liarokapisv/RobotHands/CADRoboticNewVersion/Interfaces/README.md

# Robot Hands Interfaces
In order to control robot hands the user can use the proposed interfaces.
#####Robot Hand Extension: 
This interface had two buttons, one for closing and one for opening the robot hand. 
To make this, you should print with 3d printer two parts, RobotHandExtension.STL and dovetail_male_RobotHandExtension.STL.
For connecting the two parts you must use a M5 nut and screw which you can find at common parts folder.
######Build of Materials
    1x M5 Nut
    1x M5 L22
    ABS Filament

#####SliderBox:
This interface had two linear potentiometers. Until now the one of these are active.
Also, SliderBox could be use for robot hands which had two servo motors like
[Model T42  of Yale OpenHand Project](http://www.eng.yale.edu/grablab/openhand/model_t42.html#performance).
To make this, you should cut the parts, which are in /dxf folder, in acrylic sheet with laser cutter. For connecting the parts you must use 
glue for acrylic, M3 nuts and screws. For connecting the potentiometers in the
SliderBox you must use M3 nuts, screws and spacers which are in common parts folder. 
######Build of Materials
    14x M3 Nut
    6x M3 L8
    8x M3 L20
    8x plastic spacers L15 for M3 screw
    Glue for Acrylic
    Acrylic sheet 2mm
    
For both interfaces you can find the software, firmware and electronics in respective folders of Robot-Hands repo.
