liarokapisv/RobotHands/CADRoboticNewVersion/RobotHand/README.md

# Physical Characteristics of Robot Finger and Hand
###Robot Finger:


    DOF's: 2
	Width(mm): 20
	Lenght(mm): 95
	Weigth(g): 20 
	Force in fingertip (N): 8
	
###Robot Hand:


	Actuators: 1
	Base Height(mm): 100-110
	Base Width(mm): 77
	Weight(g): 280
	Number of Fingers: 2-4

To change the design or fabrication parameters you must change the dimensions of the RobotHandParameters.SLDPRT sketch.

A complete tutorial for the replication of this robot hand can be found
[here.](http://www.openbionics.org/TR2015_OpenBionics_RobotHandsGuide.pdf)
