liarokapisv/RobotHands/CAD/Robot Finger/src/FingersTopPlate.SLDASM

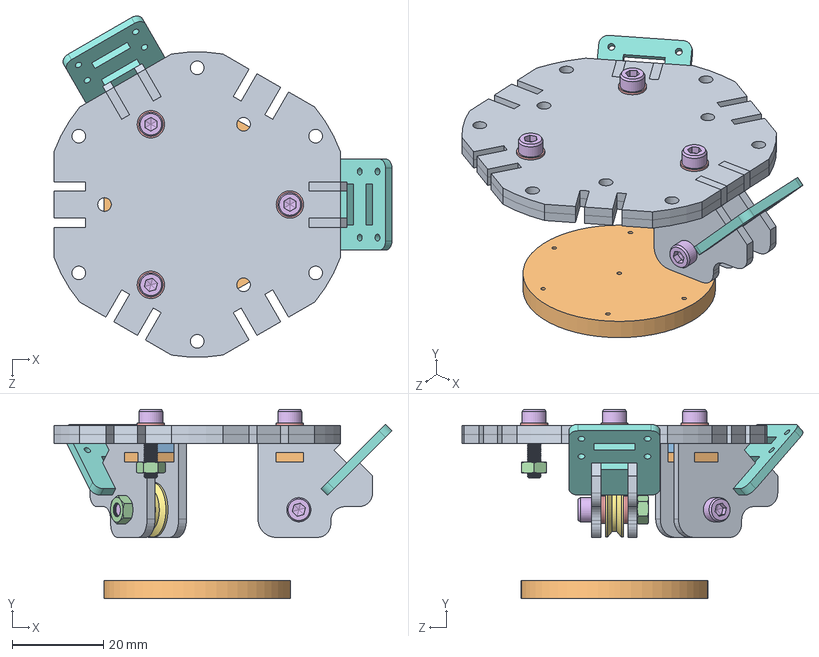
[picture p1: CAD file, 2017-01-19]
CAD/Robot Finger/src/FingersTopPlate.SLDASM
74.2 x 41.5 x 74.8 mm
FingerBase1 x 4
FingerBase2 x 2
FingerBase3 x 2
M3Nut x 5
M3Washer x 11
M3x12 x 5
pulley x 2
FingerMCP x 2
TopPlate x 2
DifferentialDisk
