liarokapisv/RobotHands/CADProsthetic/HandParameterized/Button/src/Button.SLDASM

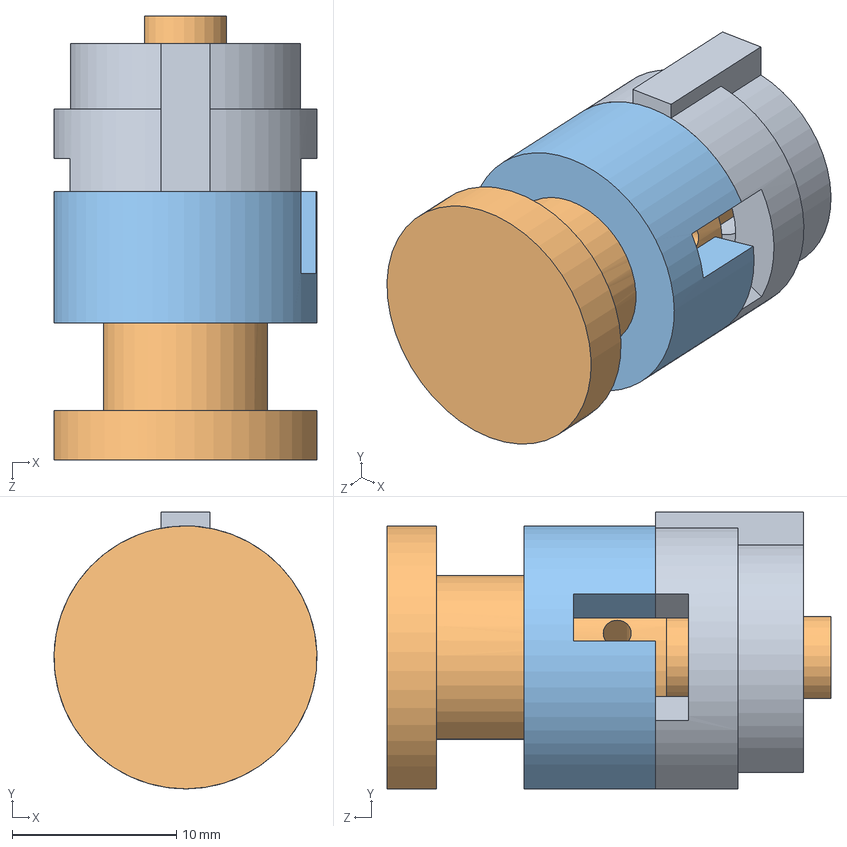
[picture p2: CAD file, 2017-01-14]
CADProsthetic/HandParameterized/Button/src/Button.SLDASM
16.0 x 16.8 x 27.0 mm
buttonBase
buttonAxle
buttonFrame
