liarokapisv/RobotHands/CADProsthetic/HandParameterized/Whipheel_tree/mainBar.STL

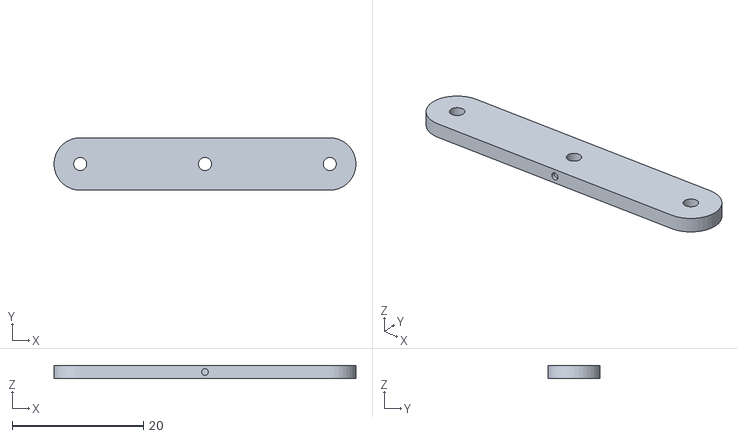
[picture p3: CAD file, 2017-01-14]
CADProsthetic/HandParameterized/Whipheel_tree/mainBar.STL
46.1 x 8.00 x 2.00
