liarokapisv/RobotHands/CADRoboticNewVersion/RobotHand/3d Printed/Robot Base/stdServoBase.SLDASM

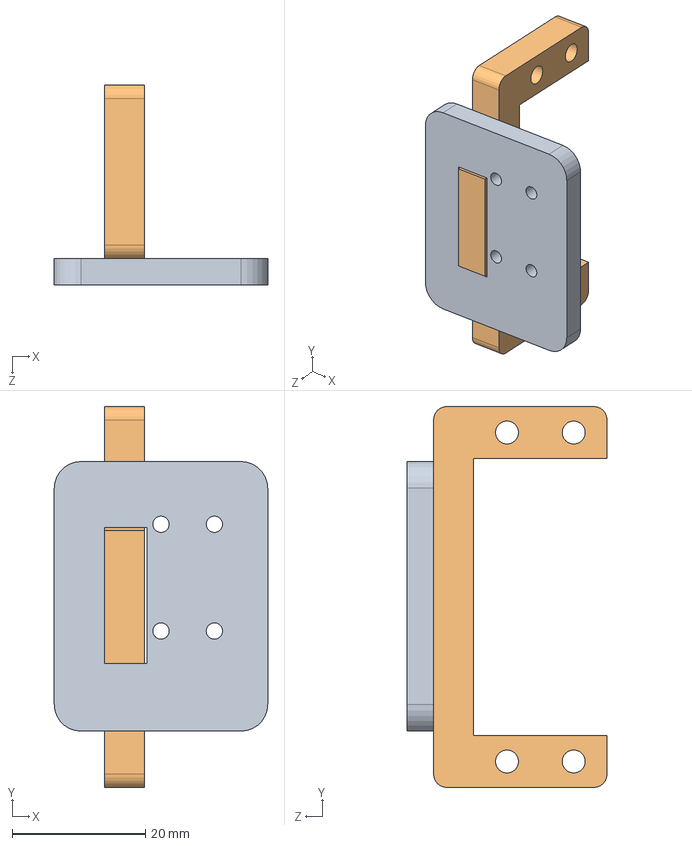
[picture p4: CAD file, 2017-01-14]
CADRoboticNewVersion/RobotHand/3d Printed/Robot Base/stdServoBase.SLDASM
32.0 x 57.1 x 30.0 mm
stdServoBase1
stdServoBase2
