liarokapisv/RobotHands/CADRoboticNewVersion/RobotHand/3d Printed/RobotHand.SLDASM

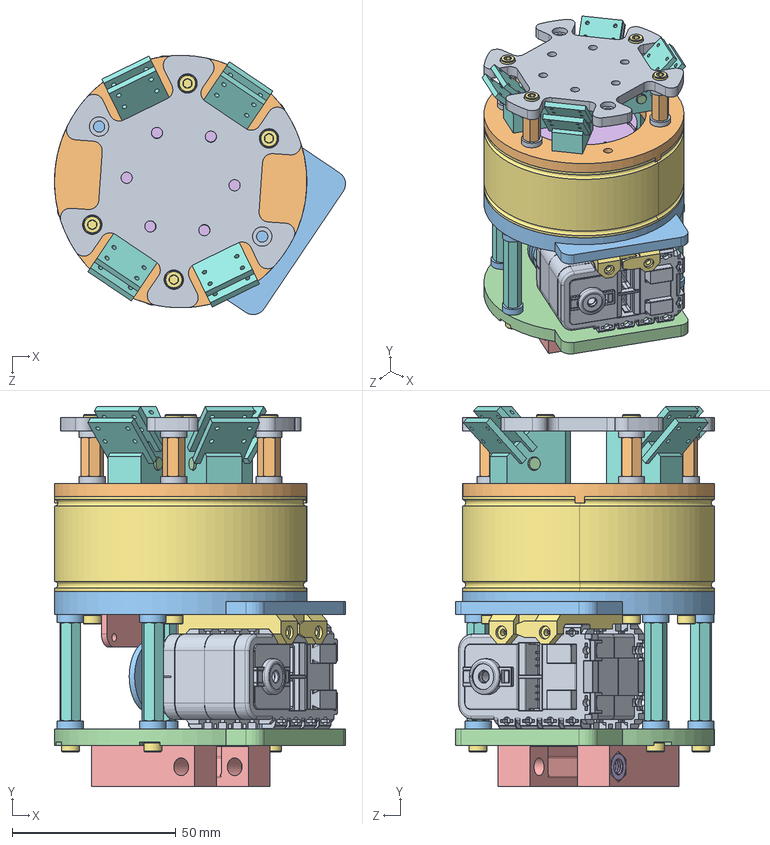
[picture p5: CAD file, 2017-01-14]
CADRoboticNewVersion/RobotHand/3d Printed/RobotHand.SLDASM
88.8 x 115.9 x 79.1 mm
TopPlate
MiddlePlate
BottomPlate
93600A129 - DowelPinM4L12 x 5
PCBMount
DifferentialDisk
AX12Base
ax12_wheel
ax12_box
ax12_cog
servoPulleyAX12
94150A305 - NutM2 x 4
91292A832 - ScrewM2L8 x 4
92290A745 - ScrewM2L4 x 2
94868A181 - HexStandoffM3L30 x 8
Spacer - 2mm x 8
94868A007 - HexStandoffM3L12 x 4
Spacer - 2_5mm x 8
FlangePlate
dovetail_female
91828A241 - NutM5
92290A115 - ScrewM3L10 x 16
FingerBase21 x 4
