liarokapisv/RobotHands/CADRoboticNewVersion/RobotHand/Laser Cutted/RobotHand.SLDASM

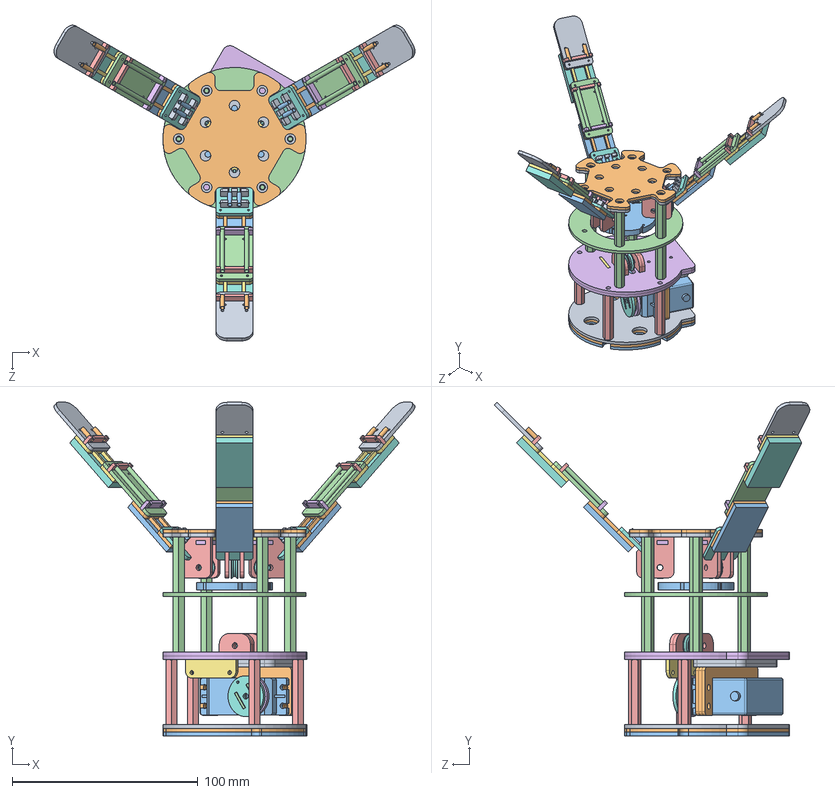
[picture p6: CAD file, 2017-01-14]
CADRoboticNewVersion/RobotHand/Laser Cutted/RobotHand.SLDASM
194.3 x 179.5 x 169.9 mm
TopPlate1
TopPlate2
DifferentialDisk
MiddlePlate
BearingBase x 4
BottomPlate x 2
PCBMount
pulley x 4
MountPA10_1
MountPA10_2
MountPA10_3
94868A181 - HexStandoffM3L30 x 8
94868A184 - HexStandoffM3L35 x 4
servoPulleyStd1
servoPulleyStd2
servoPulleyStd3
stdServoBase1 x 2
stdServoBase2 x 3
HS-422
ServoHorn
FingerBase1 x 6
FingerBase2 x 3
FingerBase3 x 3
FingerMCP x 3
TubePlateMCP x 6
JointBase1 x 3
Joint1 x 3
FingerPIP x 3
TubePlateDIP x 6
TubePlatePIP x 3
JointBase2 x 3
Joint2 x 3
FingerDIP x 3
tubeDIP x 6
tubeMCP x 6
tubePIP x 6
