liarokapisv/RobotHands/CAD/Robot Base AX12/src/servoPulley.SLDASM

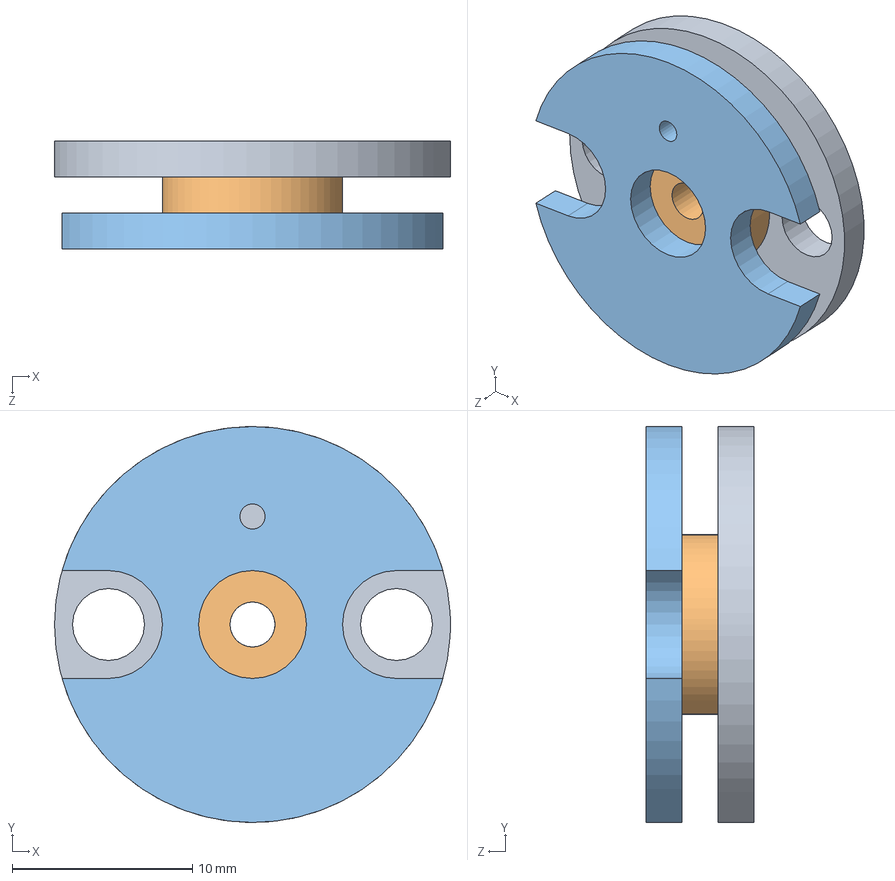
[picture p7: CAD file, 2017-01-14]
CAD/Robot Base AX12/src/servoPulley.SLDASM
22.0 x 22.0 x 6.00 mm
servoPulleyAX12_1
servoPulleyAX12_2
servoPulleyAX12_3
