liarokapisv/RobotHands/CAD/Robot Finger/src/Finger_2ph.SLDASM

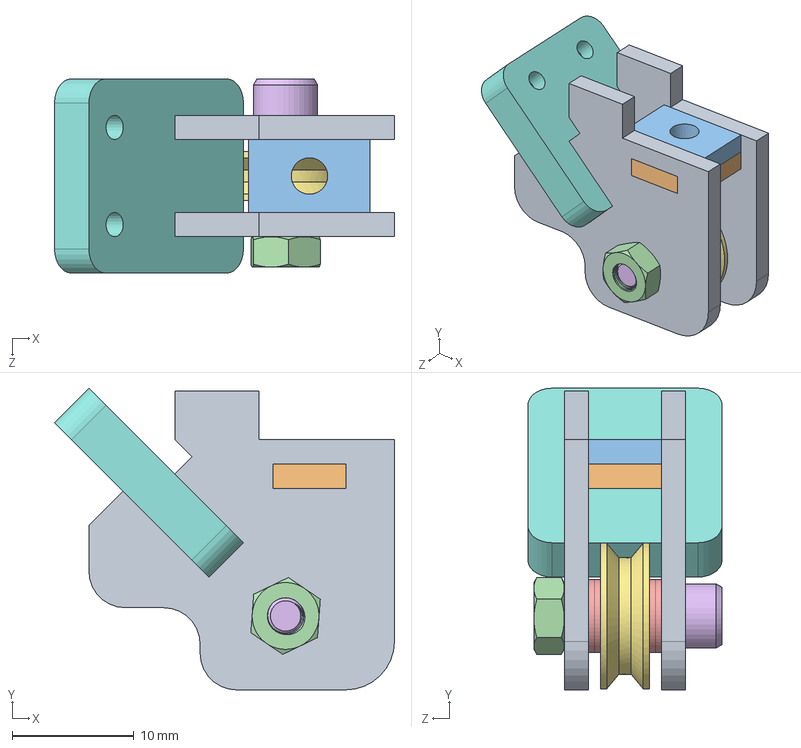
[picture p8: CAD file, 2017-01-19]
CAD/Robot Finger/src/Finger_2ph.SLDASM
28.0 x 24.8 x 16.0 mm
FingerBase1 x 2
FingerBase2
FingerBase3
M3Nut
M3Washer x 4
M3x12
pulley
FingerMCP
