liarokapisv/RobotHands/CADProsthetic/HandParameterized/Thumb_mechanism/thumbMechanismAssembly.STL

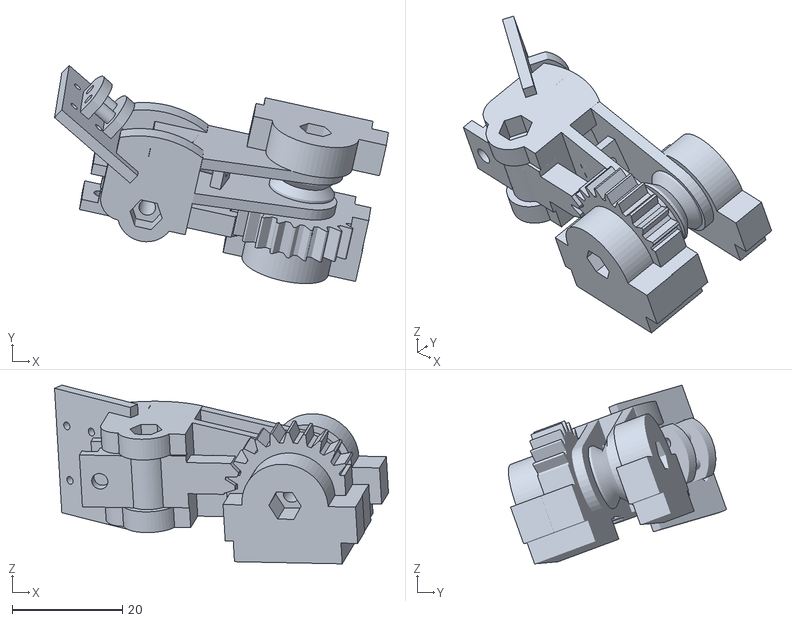
[picture p9: CAD file, 2017-01-14]
CADProsthetic/HandParameterized/Thumb_mechanism/thumbMechanismAssembly.STL
60.6 x 39.6 x 32.4
