liarokapisv/RobotHands/CADRoboticNewVersion/Interfaces/Extension/RobotHandExtensionAssembly.SLDASM

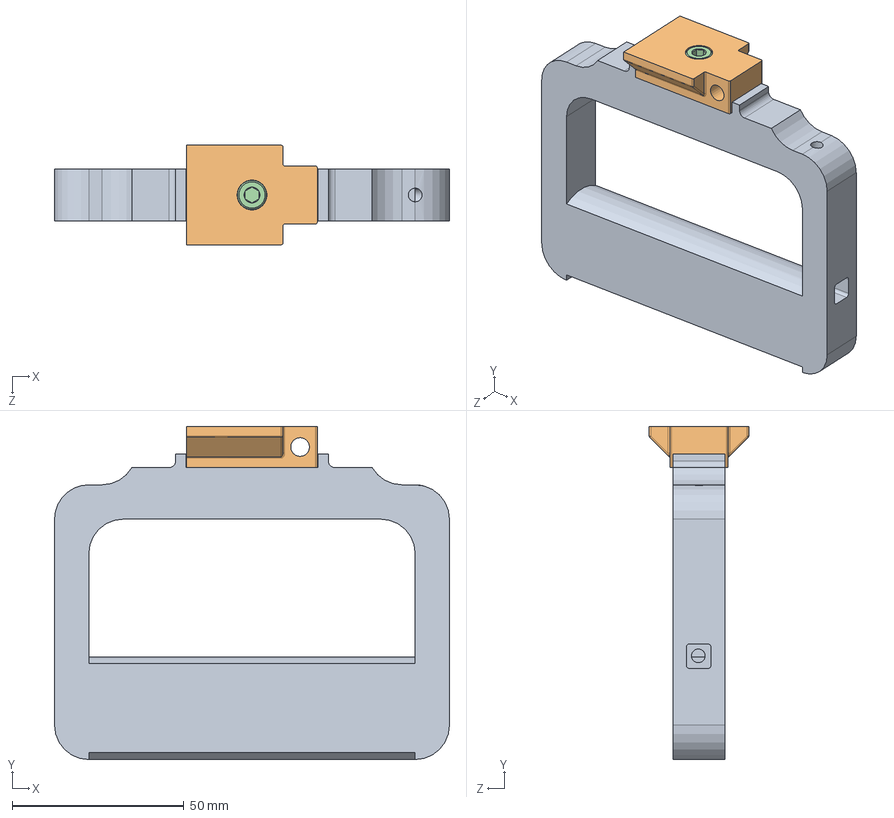
[picture p10: CAD file, 2017-01-14]
CADRoboticNewVersion/Interfaces/Extension/RobotHandExtensionAssembly.SLDASM
115.0 x 97.0 x 29.0 mm
RobotHandExtension
dovetail_male_RobotHandExtension
91828A241 - NutM5
92290A782 - ScrewM5L22
