liarokapisv/RobotHands/CADRoboticNewVersion/Interfaces/SliderBox/SliderBox.SLDASM

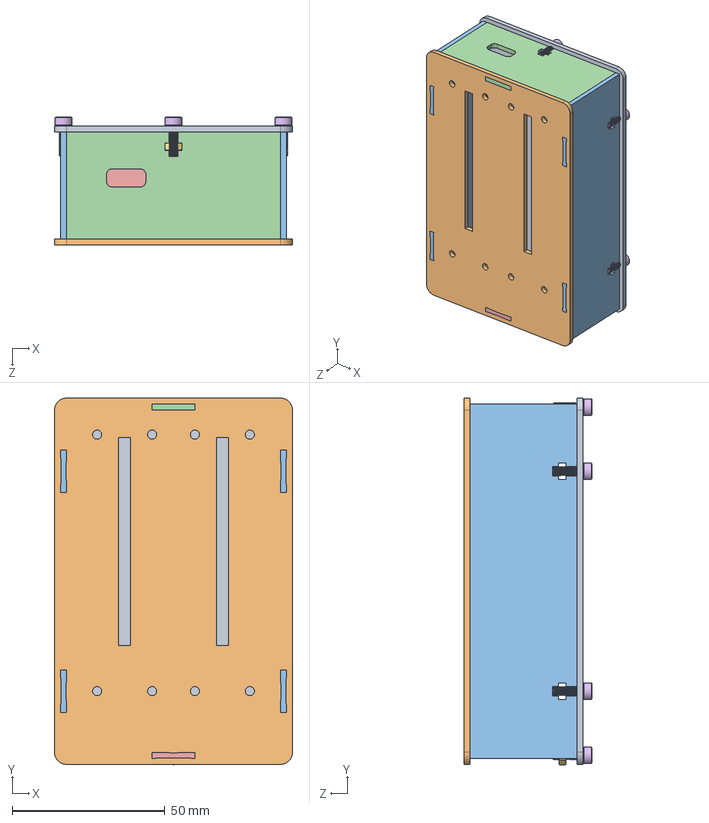
[picture p11: CAD file, 2017-01-14]
CADRoboticNewVersion/Interfaces/SliderBox/SliderBox.SLDASM
78.0 x 120.2 x 42.0 mm
SliderBottom
SliderTop
SlideSide x 2
SlideSideUp
SlideSideDown
92290A115 - ScrewM3L10 x 6
94150A325 - NutM3
