liarokapisv/RobotHands/CAD/Robot Flange/src/FlangeStdServo.SLDASM

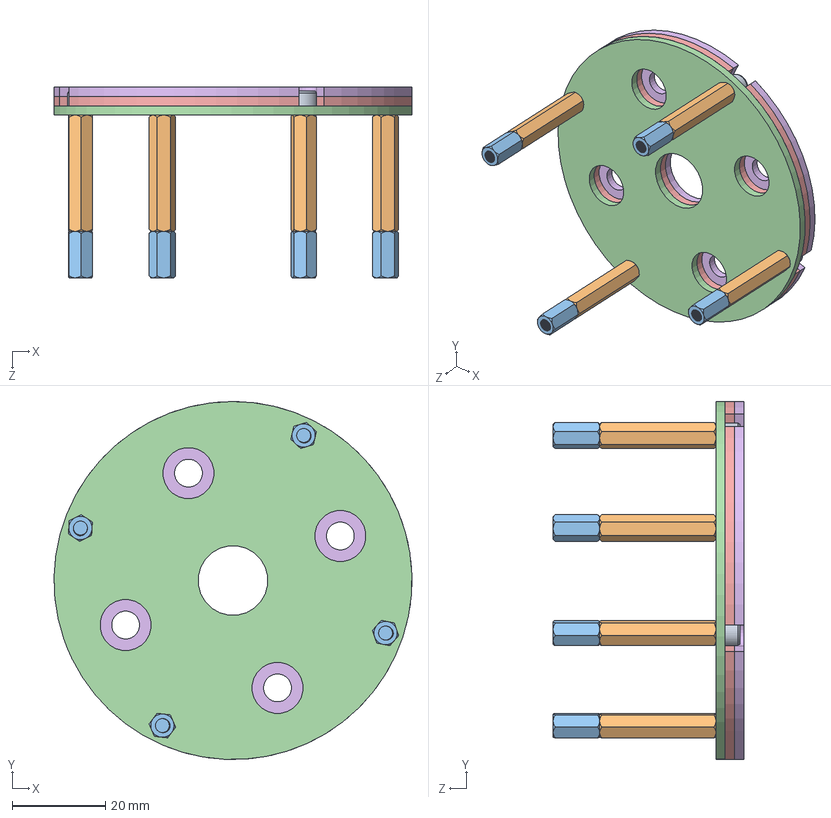
[picture p12: CAD file, 2017-01-19]
CAD/Robot Flange/src/FlangeStdServo.SLDASM
77.0 x 77.0 x 41.0 mm
M3x10 x 4
M3Spacer25 x 4
M3Spacer10 x 4
flangeStdServo_1
flangeStdServo_2
flangeStdServo_3
