liarokapisv/RobotHands/CADProsthetic/HandParameterized/Fingers/src/Pinky/pinky.SLDASM

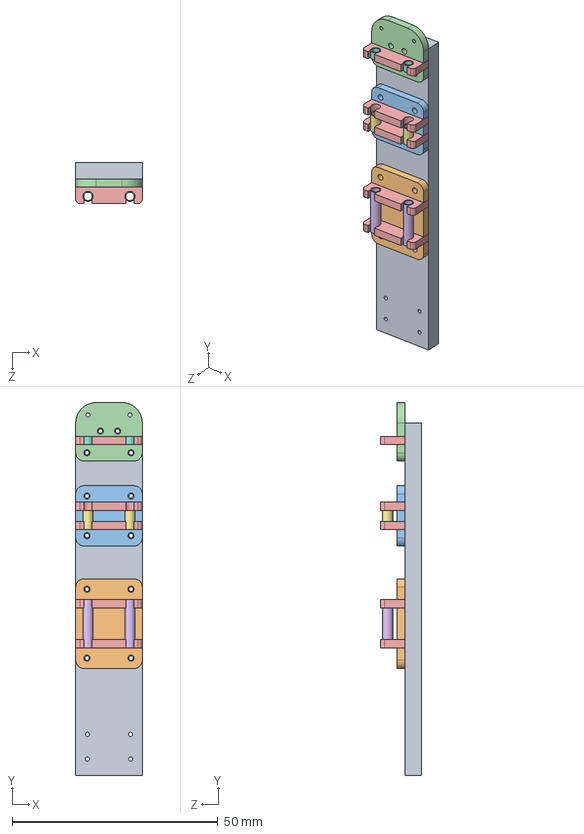
[picture p13: CAD file, 2017-01-14]
CADProsthetic/HandParameterized/Fingers/src/Pinky/pinky.SLDASM
16.2 x 90.6 x 10.0 mm
pinkyElastomer
pinkyPIP
pinkyMIP
pinkyDIP
tubeDriver x 5
pinkyTube1 x 2
pinkyTube3 x 2
commonFingersTube x 2
