liarokapisv/RobotHands/CADProsthetic/HandParameterized/Thumb_mechanism/src/thumbMovingMechanism.SLDASM

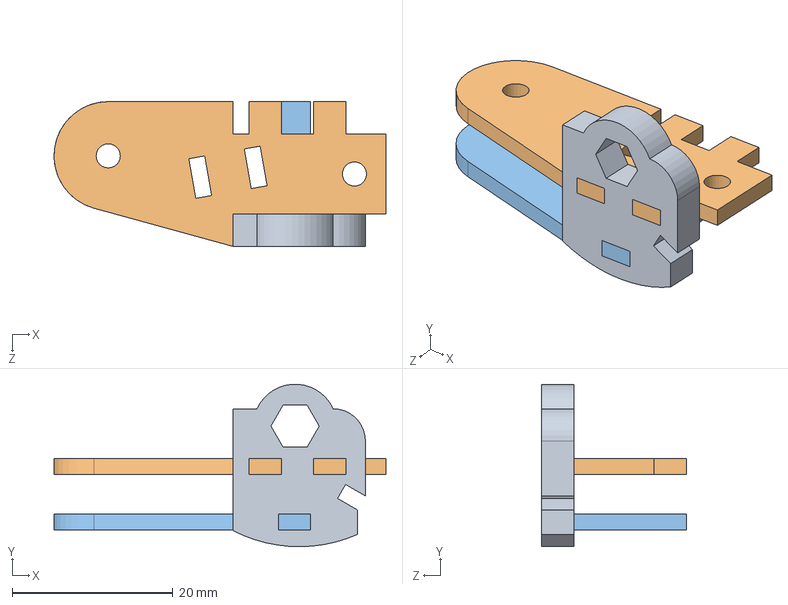
[picture p14: CAD file, 2017-01-14]
CADProsthetic/HandParameterized/Thumb_mechanism/src/thumbMovingMechanism.SLDASM
41.3 x 20.2 x 18.0 mm
thumbMovingBracket
thumbMovingBracketDown
thumbMovingBracketUp
