liarokapisv/RobotHands/CADProsthetic/HandParameterized/Fingers/src/Index/index.SLDASM

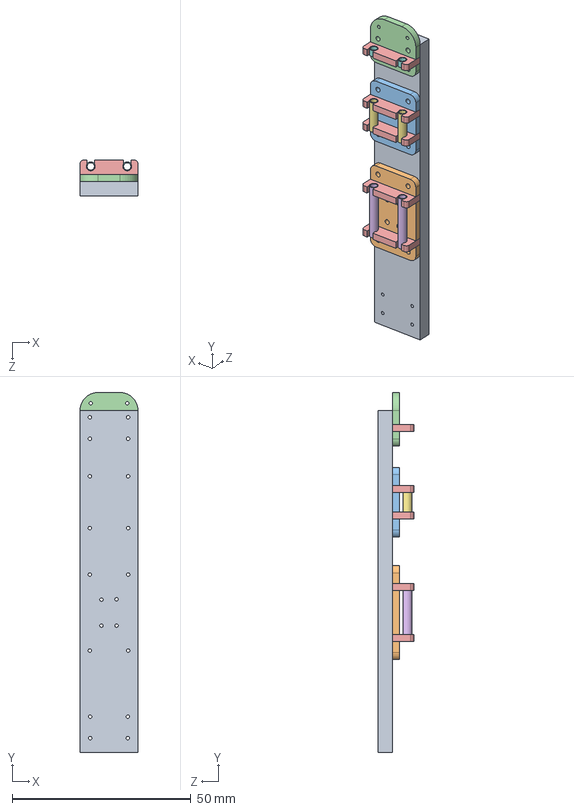
[picture p15: CAD file, 2017-01-14]
CADProsthetic/HandParameterized/Fingers/src/Index/index.SLDASM
16.2 x 100.7 x 10.0 mm
indexElastomer
indexPIP
indexMIP
indexDIP
tubeDriver x 5
indexTube1 x 2
indexTube2 x 2
commonFingersTube x 2
