liarokapisv/RobotHands/CADProsthetic/HandParameterized/Fingers/src/Thumb/thumb.SLDASM

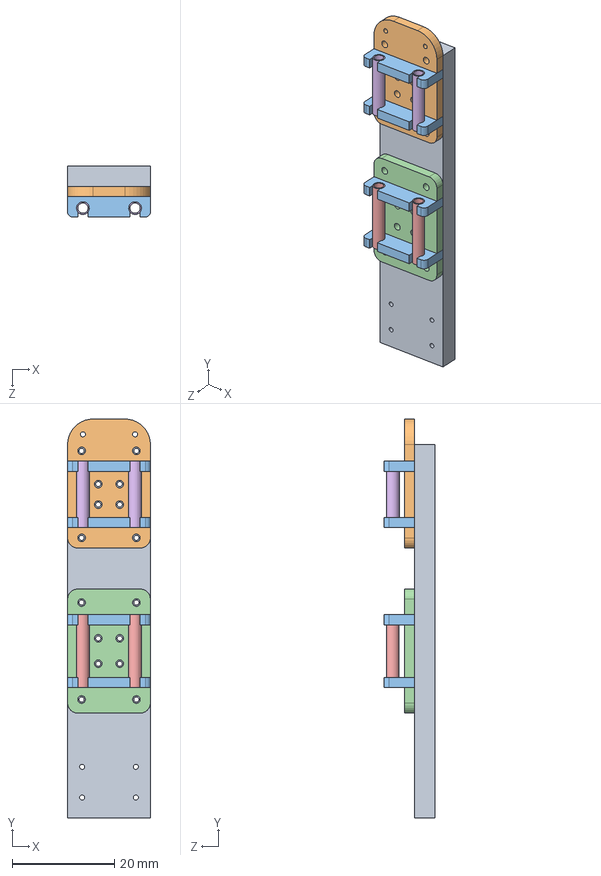
[picture p16: CAD file, 2017-01-14]
CADProsthetic/HandParameterized/Fingers/src/Thumb/thumb.SLDASM
16.2 x 78.0 x 10.0 mm
thumbElastomer
thumbDIP
tubeDriver x 4
thumbPIP
thumbTube1 x 2
thumbTube2 x 2
