liarokapisv/RobotHands/CADProsthetic/HandParameterized/Whipheel_tree/src/whiffleetree.SLDASM

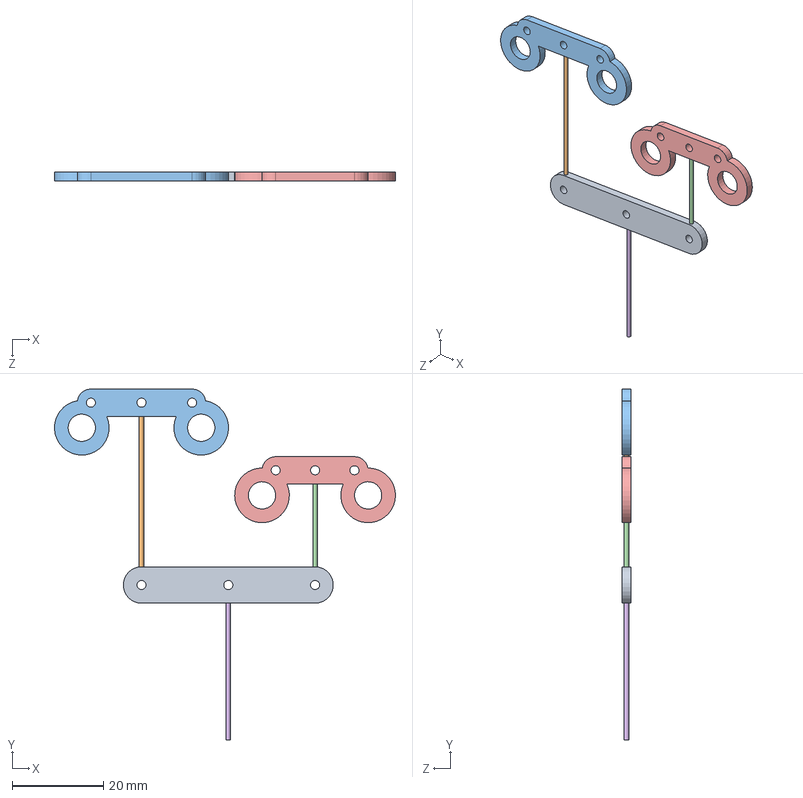
[picture p17: CAD file, 2017-01-14]
CADProsthetic/HandParameterized/Whipheel_tree/src/whiffleetree.SLDASM
74.8 x 77.0 x 2.00 mm
mainBar
dynema1
barIndexMiddle
dynema2
barMiddlePinky
dynema3
