liarokapisv/RobotHands/CADProsthetic/HandParameterized/Fingers/src/Middle/middle.SLDASM

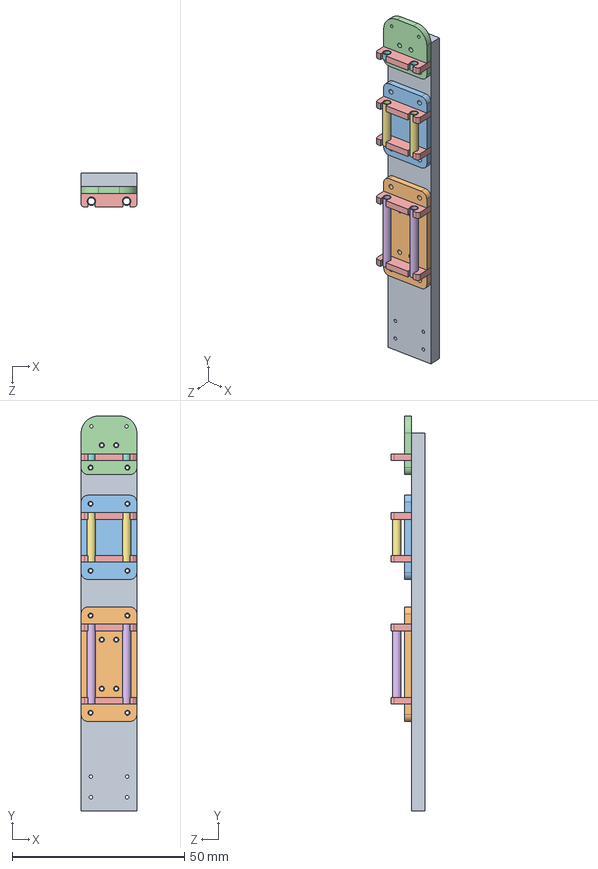
[picture p18: CAD file, 2017-01-14]
CADProsthetic/HandParameterized/Fingers/src/Middle/middle.SLDASM
16.2 x 114.6 x 10.0 mm
middleElastomer
middlePIP
middleMIP
middleDIP
tubeDriver x 5
middleTube1 x 2
middleTube2 x 2
commonFingersTube x 2
