liarokapisv/RobotHands/CADRoboticNewVersion/Couplings/MountPA10.SLDASM

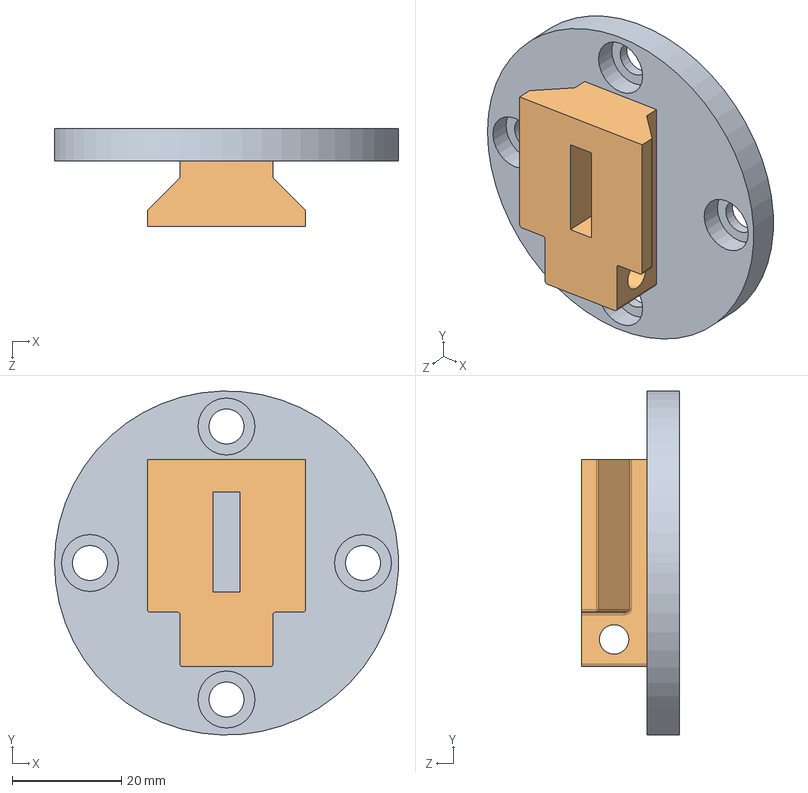
[picture p19: CAD file, 2017-01-14]
CADRoboticNewVersion/Couplings/MountPA10.SLDASM
63.0 x 63.0 x 18.0 mm
MountPlatePA10
dovetail_male
