liarokapisv/RobotHands/CAD/Robot Base stdServo/src/RobotBaseStdServo.SLDASM

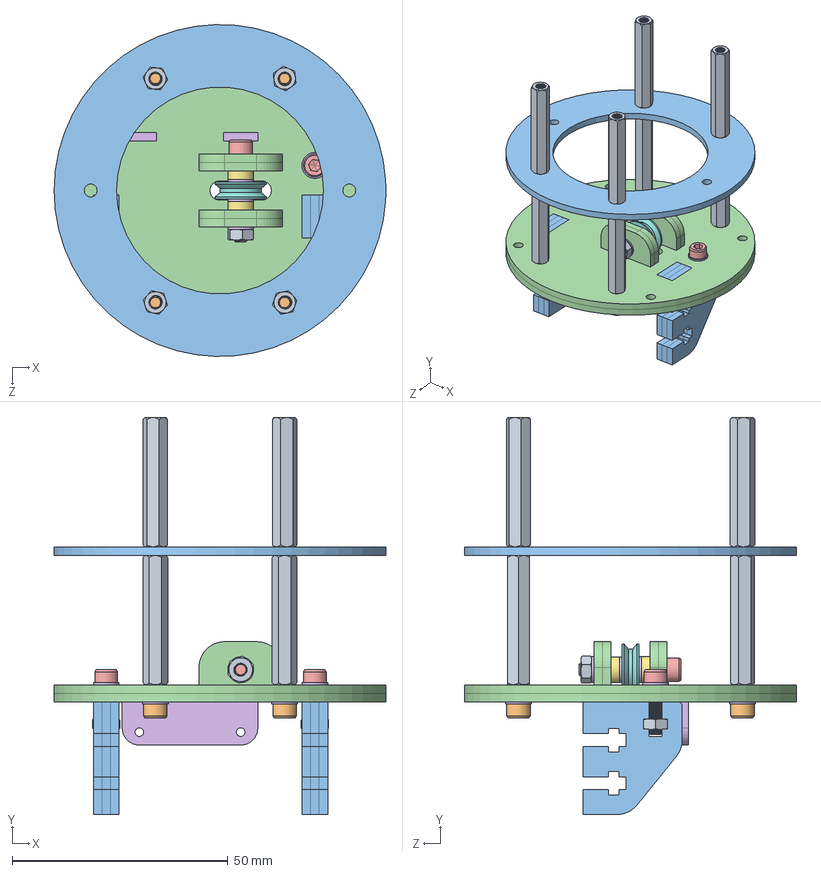
[picture p20: CAD file, 2017-01-19]
CAD/Robot Base stdServo/src/RobotBaseStdServo.SLDASM
77.0 x 92.1 x 77.0 mm
M3Spacer30 x 8
M3ThreadRod x 4
MiddlePlate
BearingBase x 4
M3x20
M3Washer x 9
PlasticSpacer x 2
pulley
M3Nut x 3
M3x10 x 4
stdServoBase x 6
BottomPlateStdServo x 2
M3x12 x 2
PCBMount
