liarokapisv/RobotHands/CADProsthetic/HandParameterized/Fingers/src/Ring/ring.SLDASM

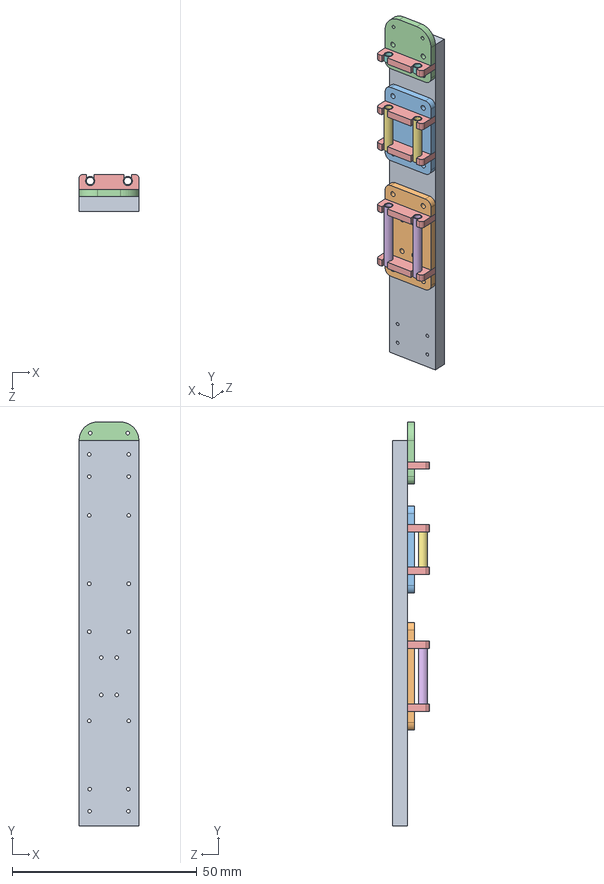
[picture p21: CAD file, 2017-01-14]
CADProsthetic/HandParameterized/Fingers/src/Ring/ring.SLDASM
16.2 x 109.5 x 10.0 mm
ringElastomer
ringPIP
ringMIP
ringDIP
tubeDriver x 5
ringTube1 x 2
ringTube2 x 2
commonFingersTube x 2
