liarokapisv/RobotHands/CADProsthetic/HandParameterized/Whipheel_tree/src/mainBar.SLDPRT

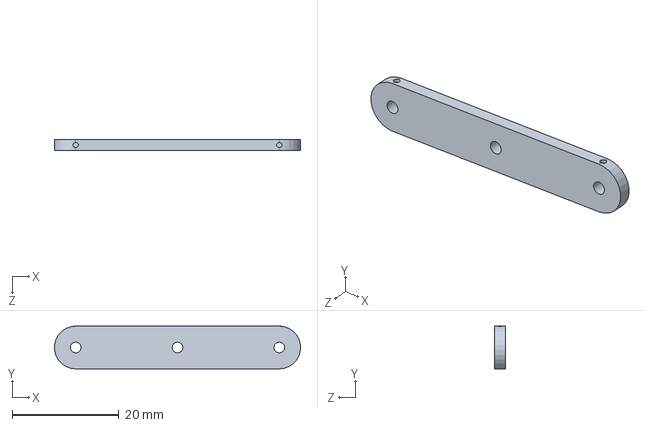
[picture p22: CAD file, 2017-01-14]
CADProsthetic/HandParameterized/Whipheel_tree/src/mainBar.SLDPRT
46.0 x 8.00 x 2.00 mm
