liarokapisv/RobotHands/CADRoboticNewVersion/RobotHand/3d Printed/Robot Base/FlangeCoupling.SLDASM

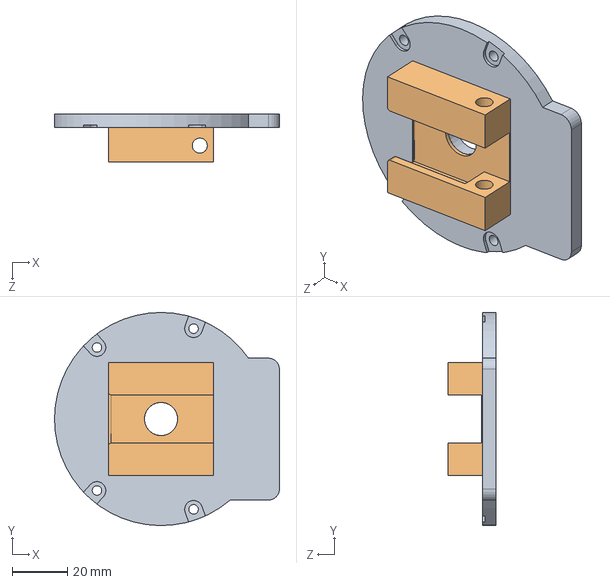
[picture p23: CAD file, 2017-01-14]
CADRoboticNewVersion/RobotHand/3d Printed/Robot Base/FlangeCoupling.SLDASM
81.3 x 77.0 x 17.5 mm
FlangePlate
dovetail_female
