liarokapisv/RobotHands/CAD/Robot Base AX12/src/RobotBaseAX12.SLDASM

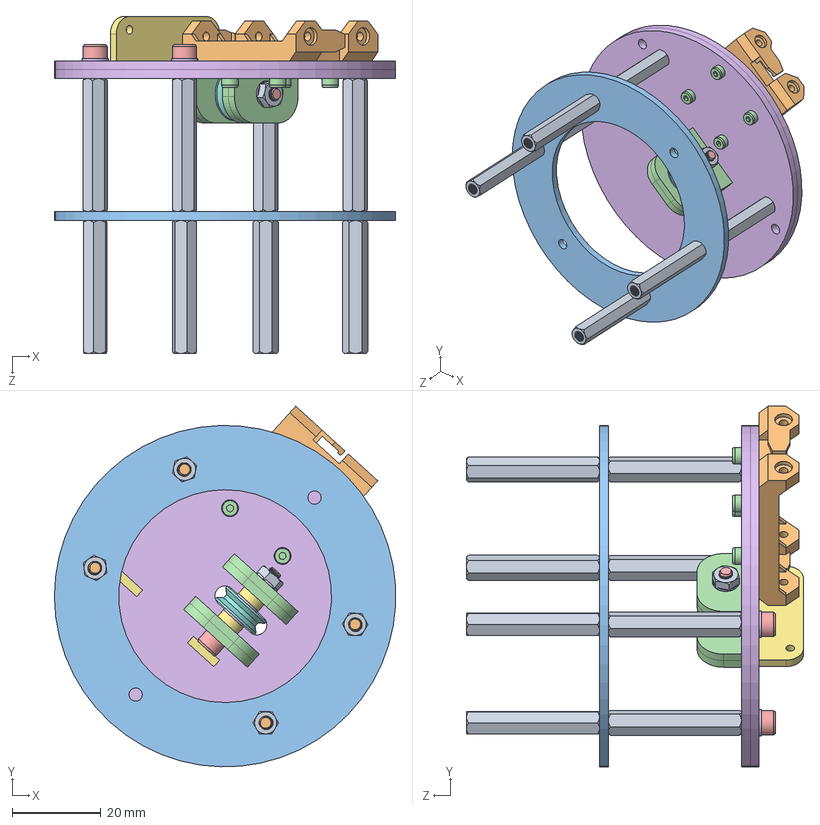
[picture p24: CAD file, 2017-01-14]
CAD/Robot Base AX12/src/RobotBaseAX12.SLDASM
76.9 x 81.3 x 76.0 mm
M3Spacer30 x 8
M3ThreadRod x 4
MiddlePlate
BearingBase x 4
M3x20
M3Washer x 7
PlasticSpacer x 2
pulley
M3Nut
AX12Base
M2Nut x 4
M2x8 x 4
M3x10 x 4
BottomPlateAX12 x 2
PCBMount
