liarokapisv/RobotHands/CAD/Robot Base stdServo/src/servoPulleyStd.SLDASM

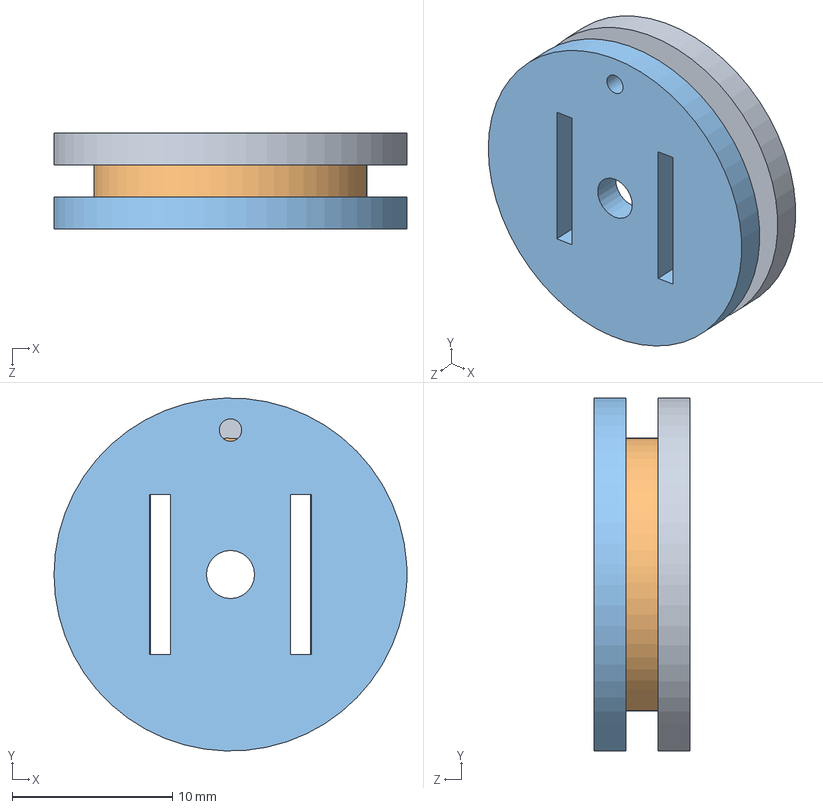
[picture p26: CAD file, 2017-01-14]
CAD/Robot Base stdServo/src/servoPulleyStd.SLDASM
22.0 x 22.0 x 6.00 mm
servoPulleyStd1
servoPulleyStd2
servoPulleyStd3
