liarokapisv/RobotHands/CADRoboticNewVersion/Common Parts/AX12.SLDASM

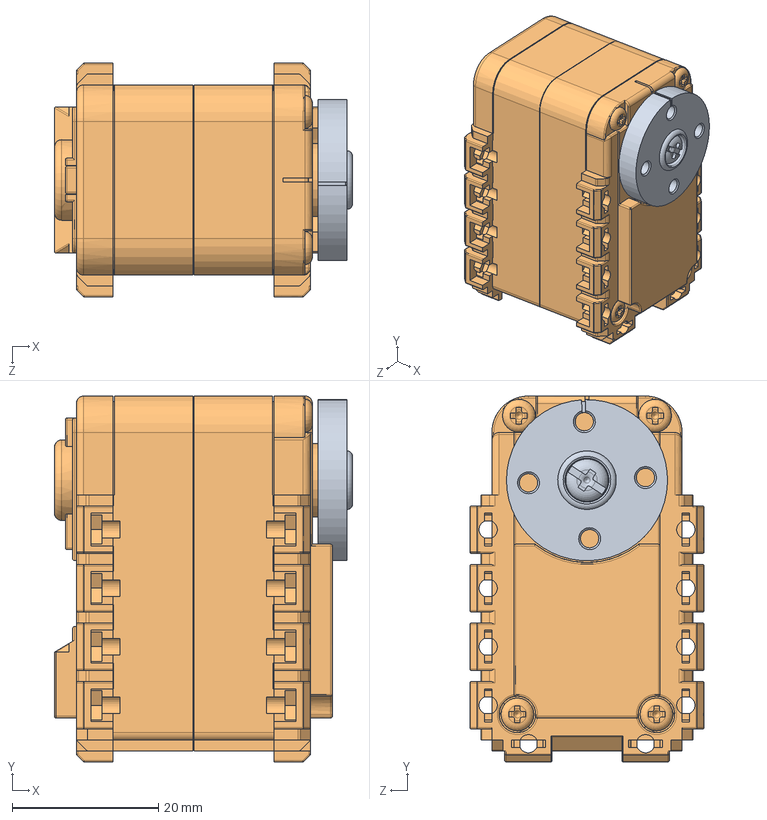
[picture p27: CAD file, 2017-01-14]
CADRoboticNewVersion/Common Parts/AX12.SLDASM
40.8 x 50.0 x 32.0 mm
ax12_wheel
ax12_box
ax12_cog
