liarokapisv/RobotHands/CADProsthetic/HandParameterized/Thumb_mechanism/src/lockMechanismBracket2.SLDASM

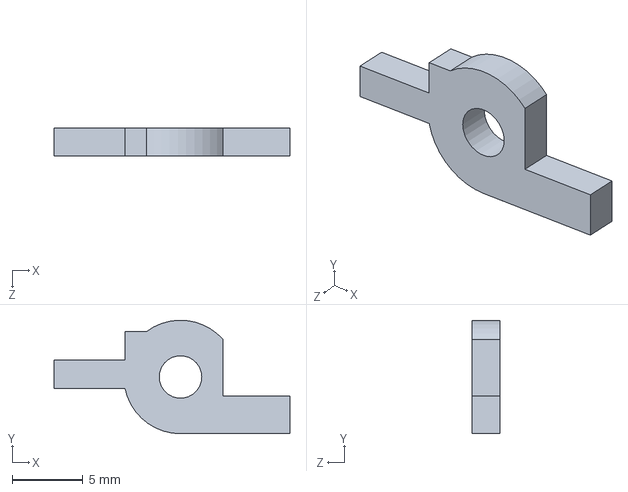
[picture p28: CAD file, 2017-01-14]
CADProsthetic/HandParameterized/Thumb_mechanism/src/lockMechanismBracket2.SLDASM
16.6 x 8.00 x 2.00 mm
