liarokapisv/RobotHands/CADRoboticNewVersion/RobotHand/Laser Cutted/Robot Base/Base.SLDASM

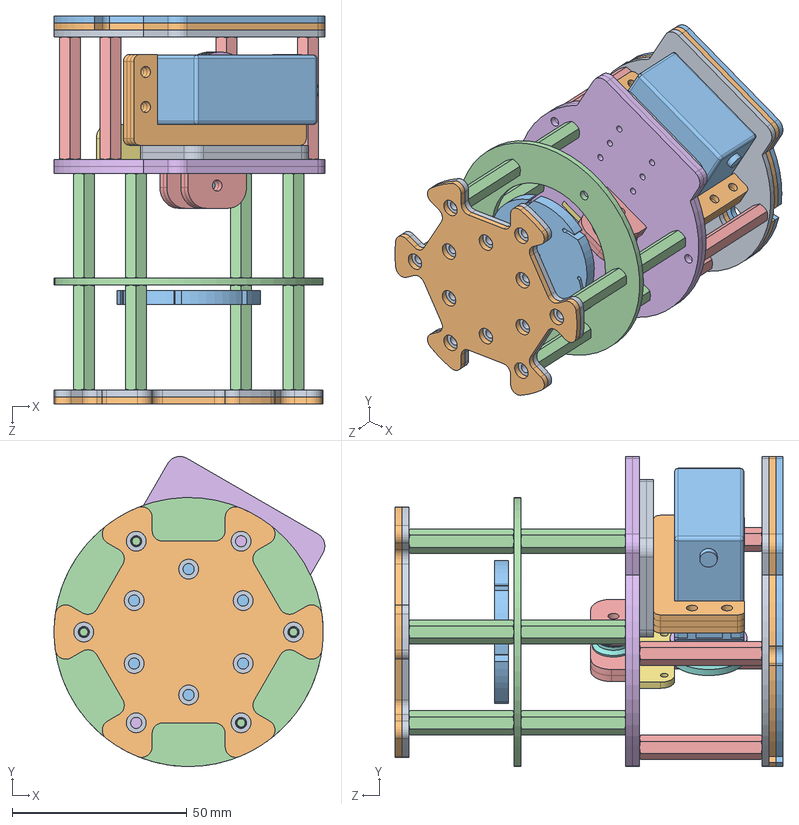
[picture p29: CAD file, 2017-01-14]
CADRoboticNewVersion/RobotHand/Laser Cutted/Robot Base/Base.SLDASM
77.5 x 88.8 x 111.0 mm
TopPlate1
TopPlate2
DifferentialDisk
MiddlePlate
BearingBase x 4
BottomPlate x 2
PCBMount
pulley
MountPA10_1
MountPA10_2
MountPA10_3
94868A181 - HexStandoffM3L30 x 8
94868A184 - HexStandoffM3L35 x 4
servoPulleyStd1
servoPulleyStd2
servoPulleyStd3
stdServoBase1 x 2
stdServoBase2 x 3
HS-422
ServoHorn
