liarokapisv/RobotHands/CAD/CommonParts/M3ThreadRod.SLDPRT

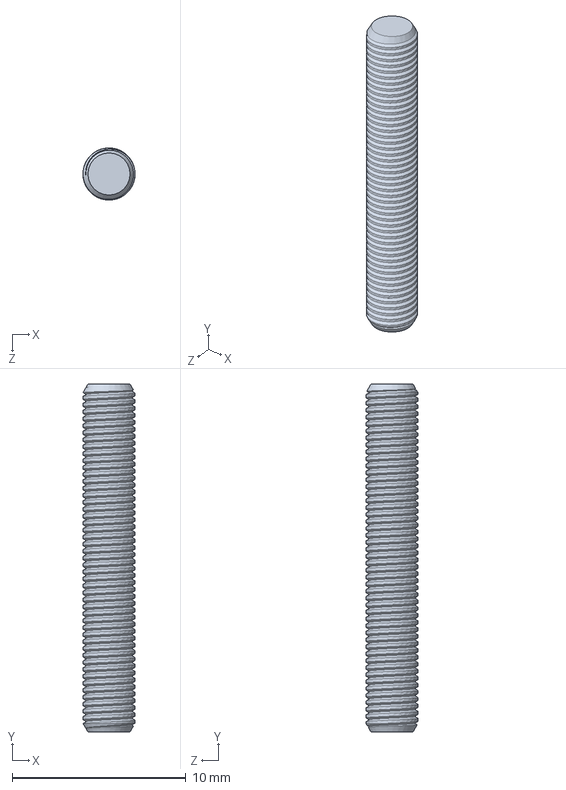
[picture p30: CAD file, 2017-01-19]
CAD/CommonParts/M3ThreadRod.SLDPRT
3.00 x 20.0 x 3.00 mm
