liarokapisv/RobotHands/CAD/FinalParts/MiddlePlate.sldprt

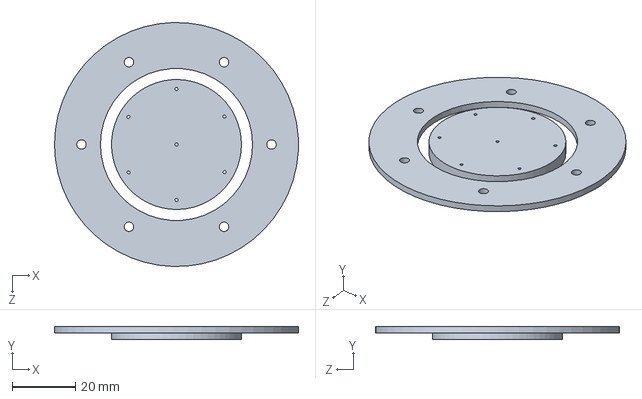
[picture p31: CAD file, 2017-01-19]
CAD/FinalParts/MiddlePlate.sldprt
77.0 x 4.00 x 77.0 mm
