liarokapisv/RobotHands/CAD/Laser/RobotHand_stdServo.dxf

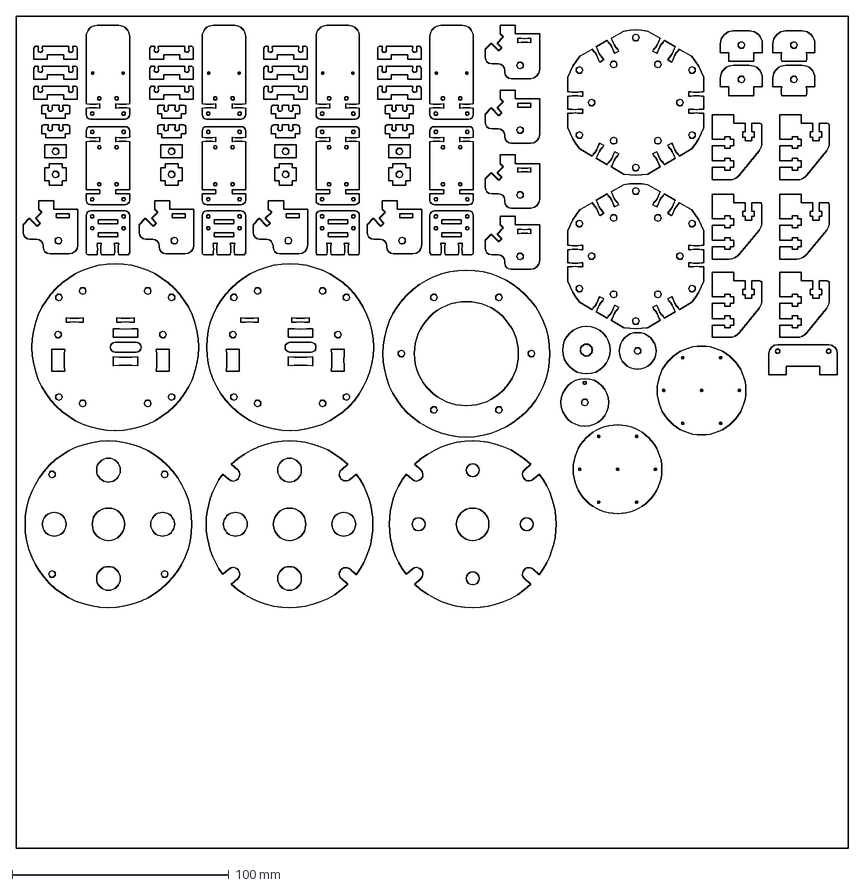
[picture p32: CAD file, 2017-01-14]
CAD/Laser/RobotHand_stdServo.dxf
384.0 x 384.0 mm
