liarokapisv/RobotHands/CAD/Robot Base AX12/PCBMount.STL

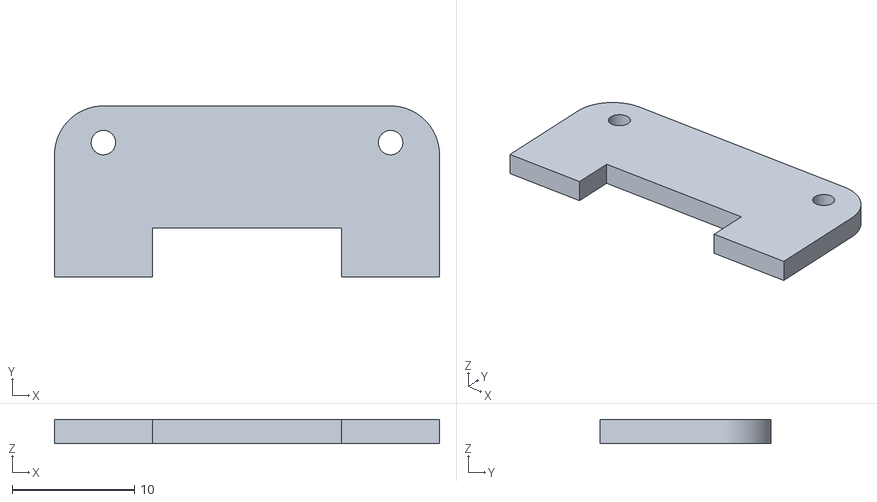
[picture p33: CAD file, 2017-01-14]
CAD/Robot Base AX12/PCBMount.STL
31.5 x 14.0 x 2.00
