liarokapisv/RobotHands/CAD/Robot Base AX12/src/servoPulleyAX12_3.SLDPRT

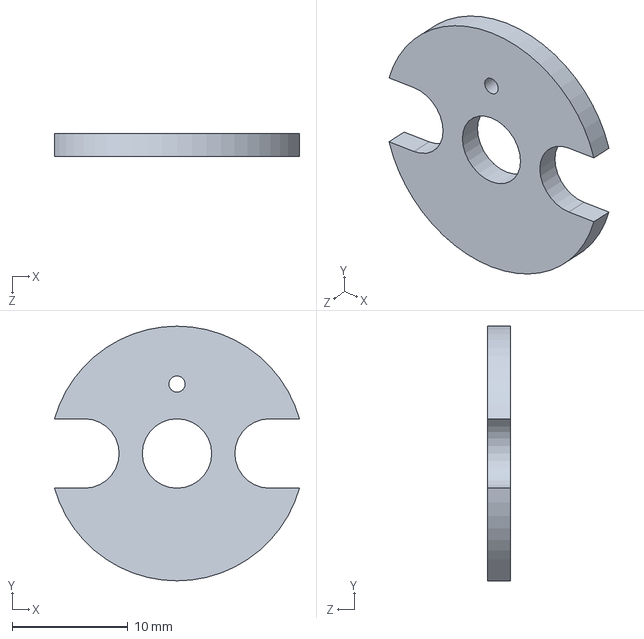
[picture p34: CAD file, 2017-01-14]
CAD/Robot Base AX12/src/servoPulleyAX12_3.SLDPRT
21.2 x 22.0 x 2.00 mm
