liarokapisv/RobotHands/CAD/Robot Base stdServo/BottomPlateStdServo.STL

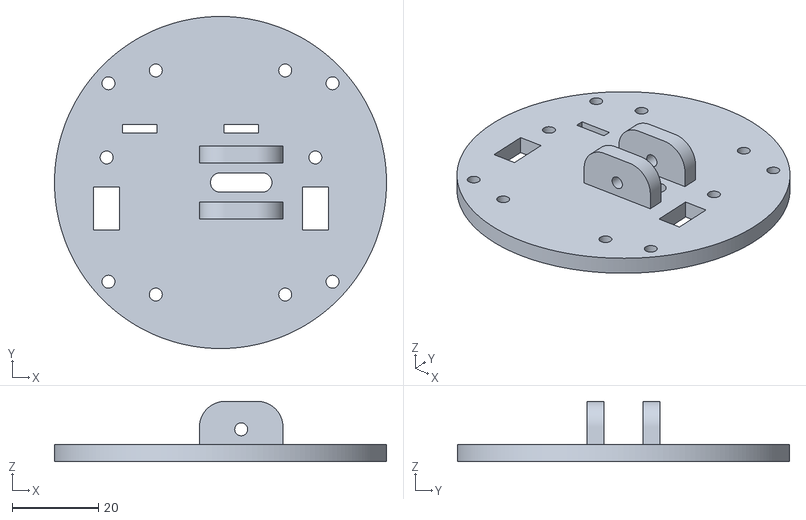
[picture p35: CAD file, 2017-01-14]
CAD/Robot Base stdServo/BottomPlateStdServo.STL
77.0 x 77.0 x 14.0
