liarokapisv/RobotHands/CAD/Robot Base stdServo/src/BearingBase.SLDPRT

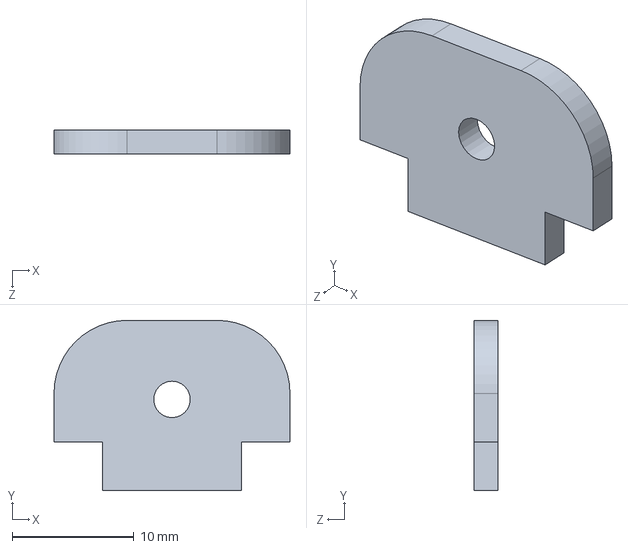
[picture p36: CAD file, 2017-01-19]
CAD/Robot Base stdServo/src/BearingBase.SLDPRT
19.4 x 14.0 x 2.00 mm
