liarokapisv/RobotHands/CAD/Robot Finger/FingerDIP.STL

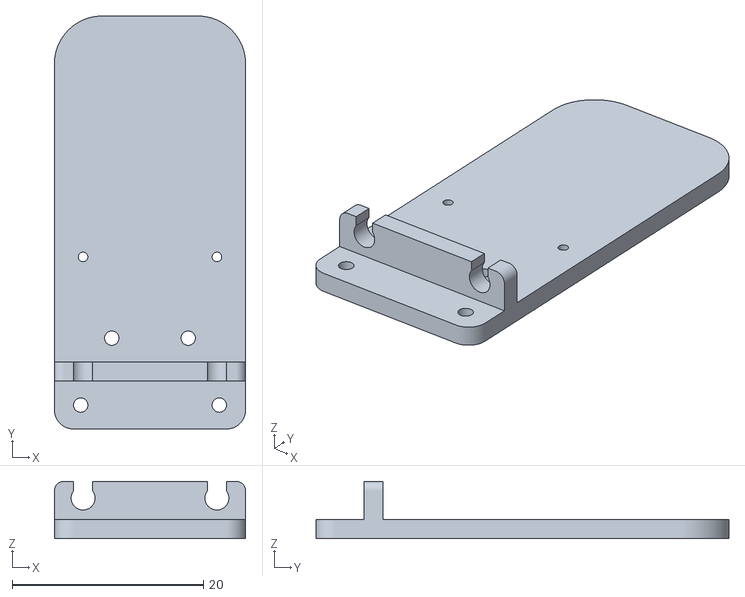
[picture p37: CAD file, 2017-01-14]
CAD/Robot Finger/FingerDIP.STL
20.0 x 43.2 x 6.00
