liarokapisv/RobotHands/CAD/Robot Flange/FlangeAX12.STL

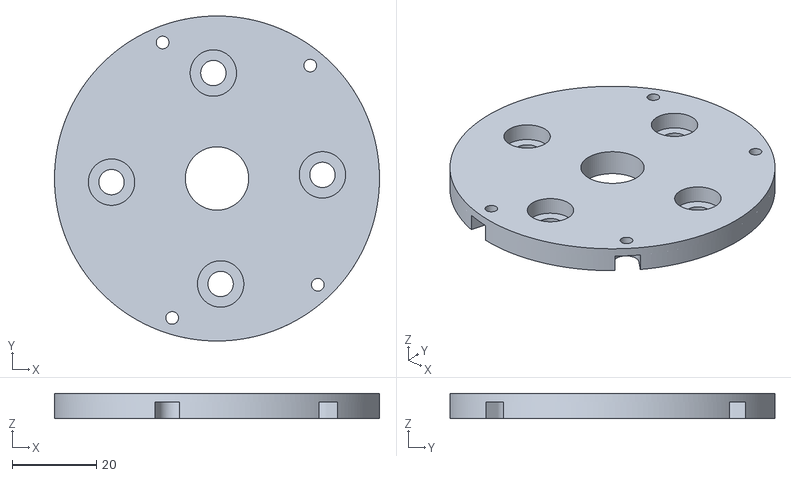
[picture p38: CAD file, 2017-01-14]
CAD/Robot Flange/FlangeAX12.STL
77.0 x 77.0 x 6.00
