liarokapisv/RobotHands/CAD/Robot Flange/src/flangeStdServo_2.SLDPRT

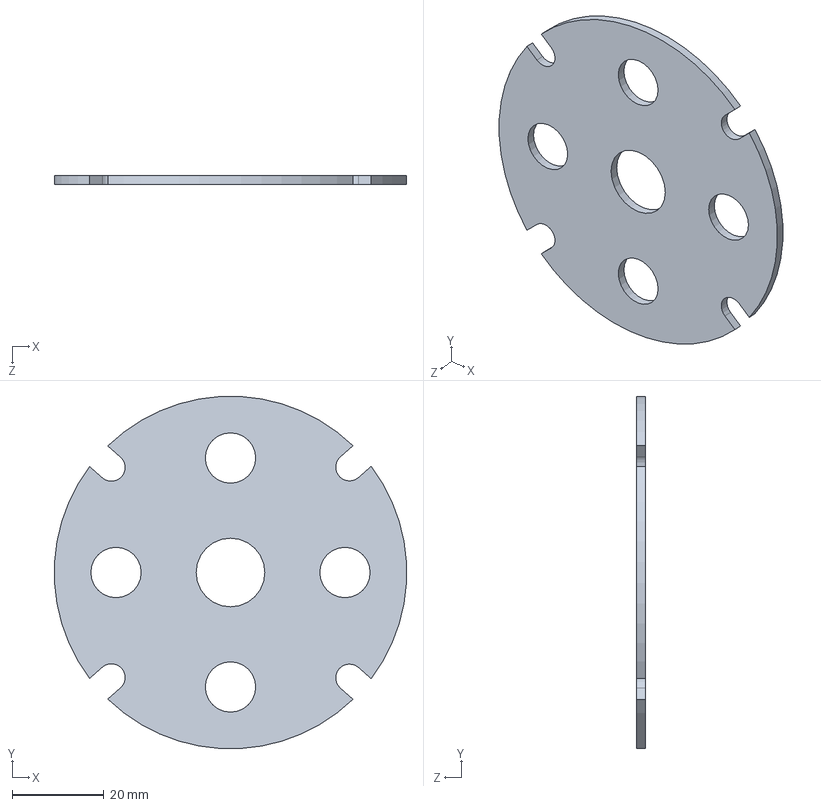
[picture p39: CAD file, 2017-01-19]
CAD/Robot Flange/src/flangeStdServo_2.SLDPRT
76.9 x 76.9 x 2.00 mm
