liarokapisv/RobotHands/CADProsthetic/HandParameterized/Button/buttonBase.STL

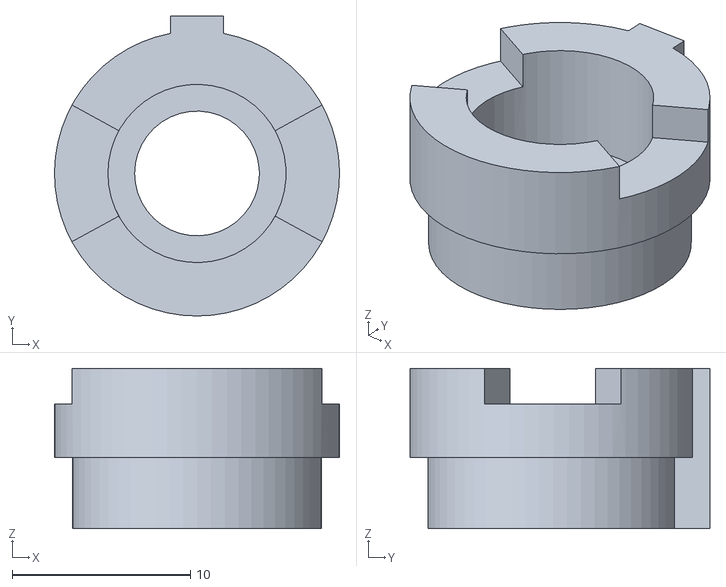
[picture p40: CAD file, 2017-01-14]
CADProsthetic/HandParameterized/Button/buttonBase.STL
16.0 x 16.8 x 9.00
