liarokapisv/RobotHands/CADProsthetic/HandParameterized/Fingers/Common Parts/driverBaseFrame1.STL

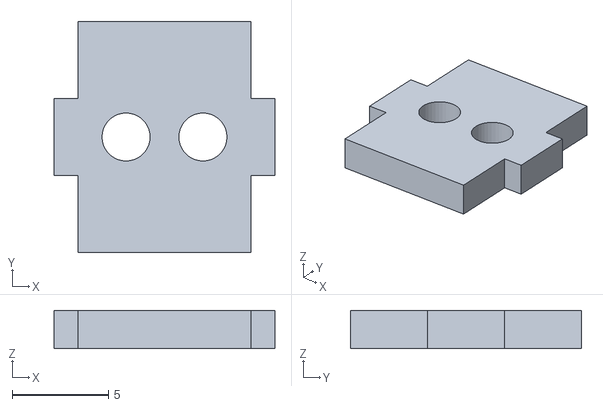
[picture p41: CAD file, 2017-01-14]
CADProsthetic/HandParameterized/Fingers/Common Parts/driverBaseFrame1.STL
11.5 x 12.0 x 2.00
