liarokapisv/RobotHands/CADProsthetic/HandParameterized/Fingers/Index/indexPIP.STL

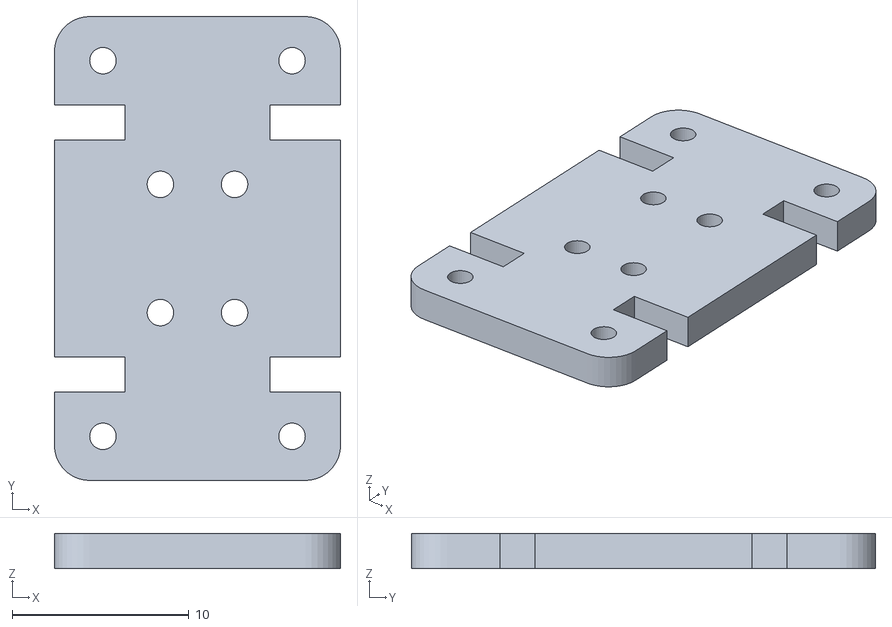
[picture p42: CAD file, 2017-01-14]
CADProsthetic/HandParameterized/Fingers/Index/indexPIP.STL
16.2 x 26.3 x 2.00
