liarokapisv/RobotHands/CADProsthetic/HandParameterized/Fingers/Middle/middlePIP.STL

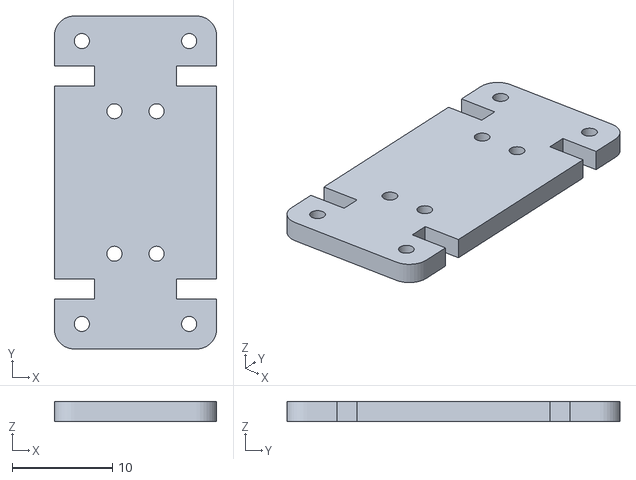
[picture p43: CAD file, 2017-01-14]
CADProsthetic/HandParameterized/Fingers/Middle/middlePIP.STL
16.2 x 33.2 x 2.00
