liarokapisv/RobotHands/CADProsthetic/HandParameterized/Fingers/Pinky/pinkyMIP.STL

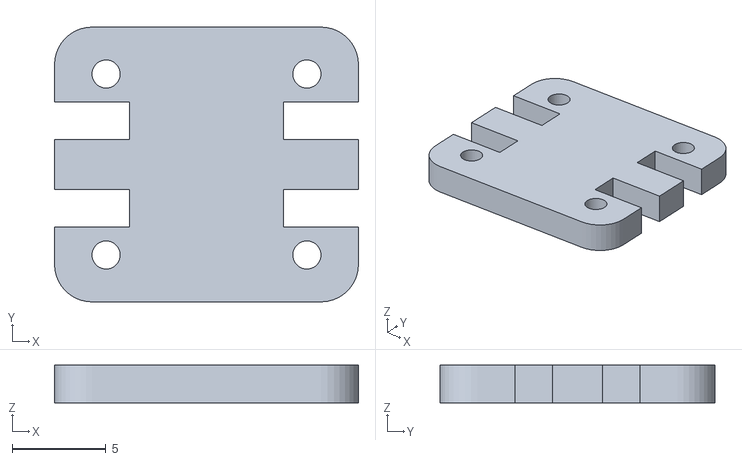
[picture p44: CAD file, 2017-01-14]
CADProsthetic/HandParameterized/Fingers/Pinky/pinkyMIP.STL
16.2 x 14.6 x 2.00
