liarokapisv/RobotHands/CADProsthetic/HandParameterized/Fingers/src/Common Parts/driverBaseFrame1.SLDPRT

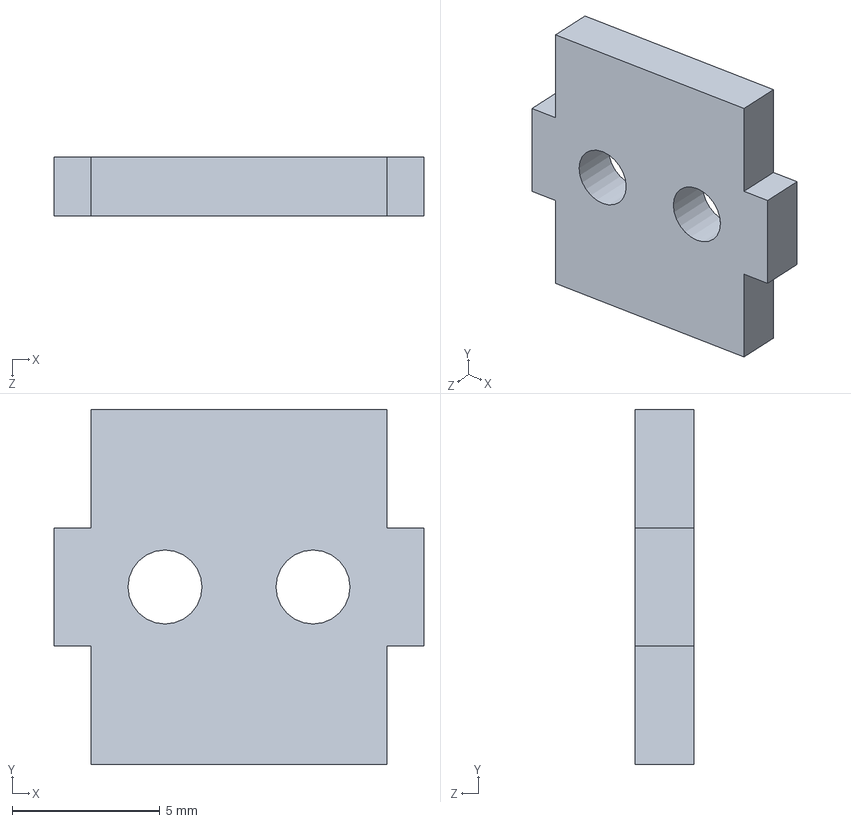
[picture p45: CAD file, 2017-01-14]
CADProsthetic/HandParameterized/Fingers/src/Common Parts/driverBaseFrame1.SLDPRT
12.5 x 12.0 x 2.00 mm
