liarokapisv/RobotHands/CADProsthetic/HandParameterized/Fingers/src/Middle/tube32.SLDPRT

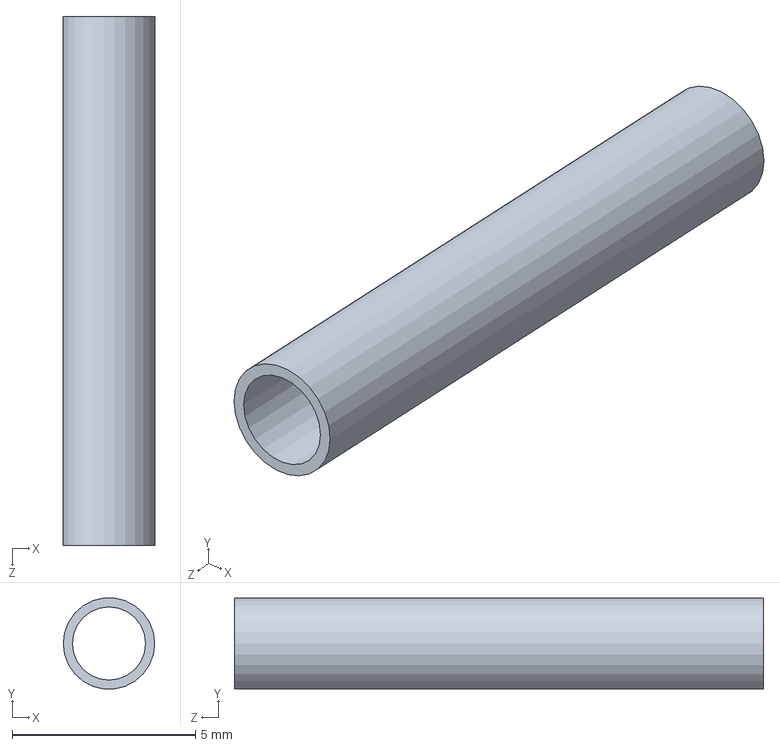
[picture p46: CAD file, 2017-01-14]
CADProsthetic/HandParameterized/Fingers/src/Middle/tube32.SLDPRT
2.50 x 2.48 x 14.4 mm
