liarokapisv/RobotHands/CADProsthetic/HandParameterized/Fingers/src/Ring/ringDIP.SLDPRT

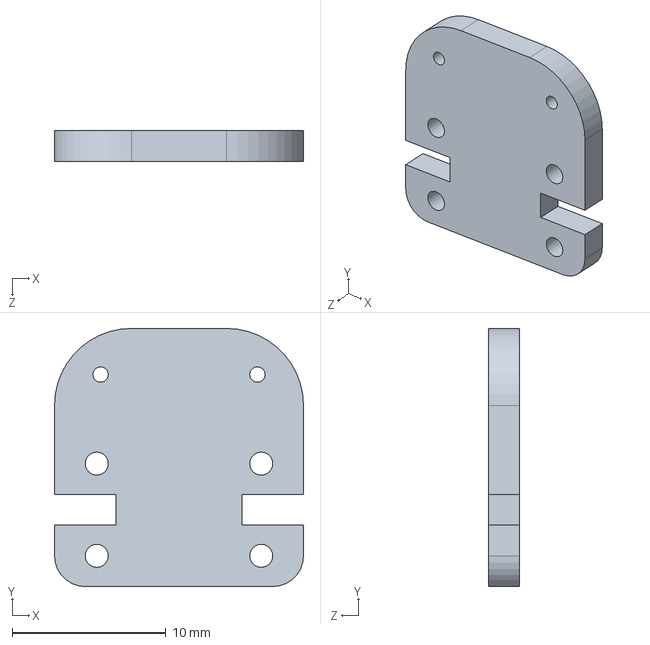
[picture p47: CAD file, 2017-01-14]
CADProsthetic/HandParameterized/Fingers/src/Ring/ringDIP.SLDPRT
16.2 x 16.8 x 2.00 mm
