liarokapisv/RobotHands/CADProsthetic/HandParameterized/Fingers/src/Thumb/thumbDIP.SLDPRT

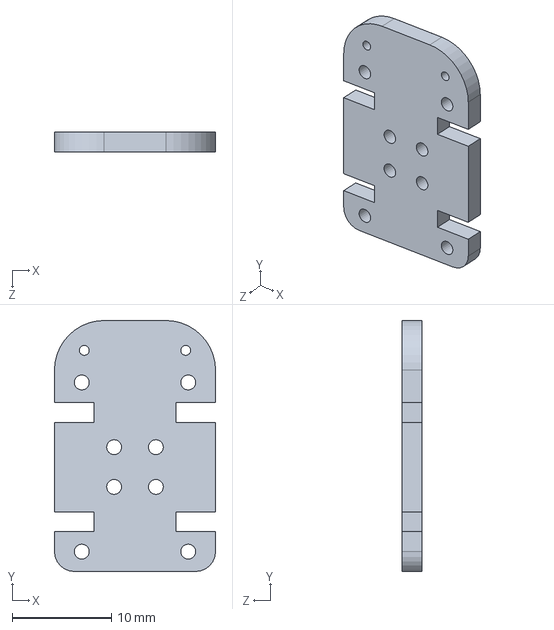
[picture p48: CAD file, 2017-01-14]
CADProsthetic/HandParameterized/Fingers/src/Thumb/thumbDIP.SLDPRT
16.2 x 25.2 x 2.00 mm
