liarokapisv/RobotHands/CADProsthetic/HandParameterized/Flange/src/SupportHandFlange1.SLDPRT

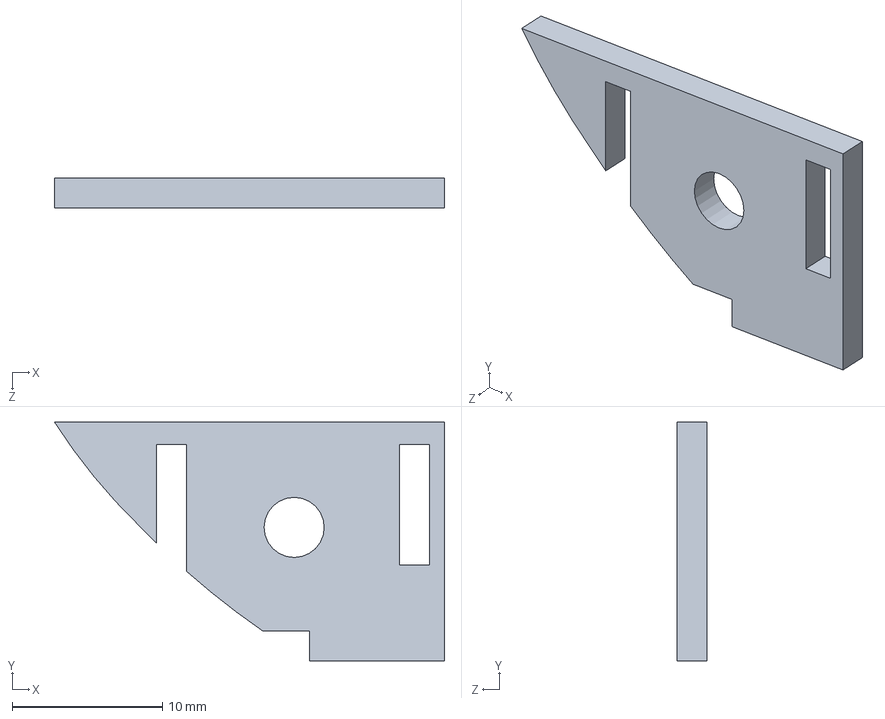
[picture p49: CAD file, 2017-01-14]
CADProsthetic/HandParameterized/Flange/src/SupportHandFlange1.SLDPRT
25.9 x 15.9 x 2.00 mm
