liarokapisv/RobotHands/CADProsthetic/HandParameterized/Flange/supportHandFlange2.STL

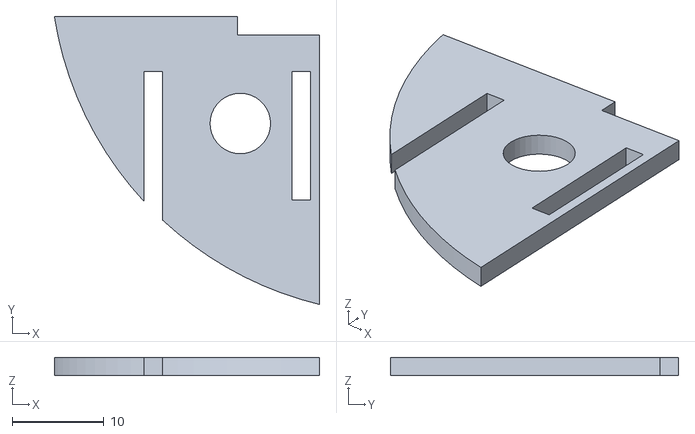
[picture p50: CAD file, 2017-01-14]
CADProsthetic/HandParameterized/Flange/supportHandFlange2.STL
28.9 x 31.4 x 2.00
