liarokapisv/RobotHands/CADProsthetic/HandParameterized/Palm/palmUp.STL

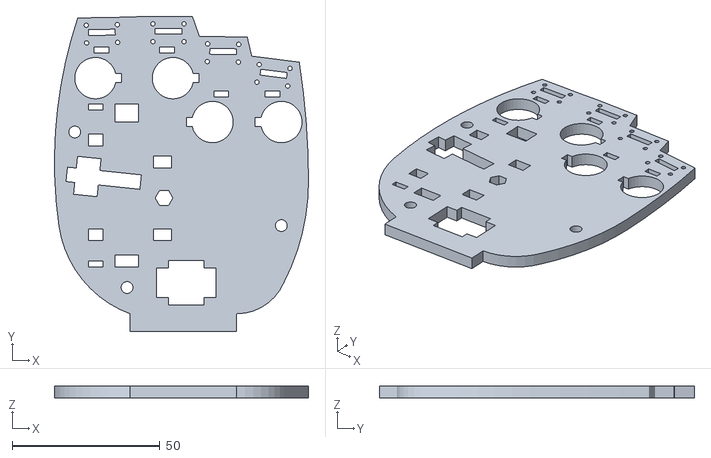
[picture p51: CAD file, 2017-01-14]
CADProsthetic/HandParameterized/Palm/palmUp.STL
85.9 x 106.5 x 4.00
