liarokapisv/RobotHands/CADProsthetic/HandParameterized/ServoBase/Base HerkuleX/BracketHerkulex.STL

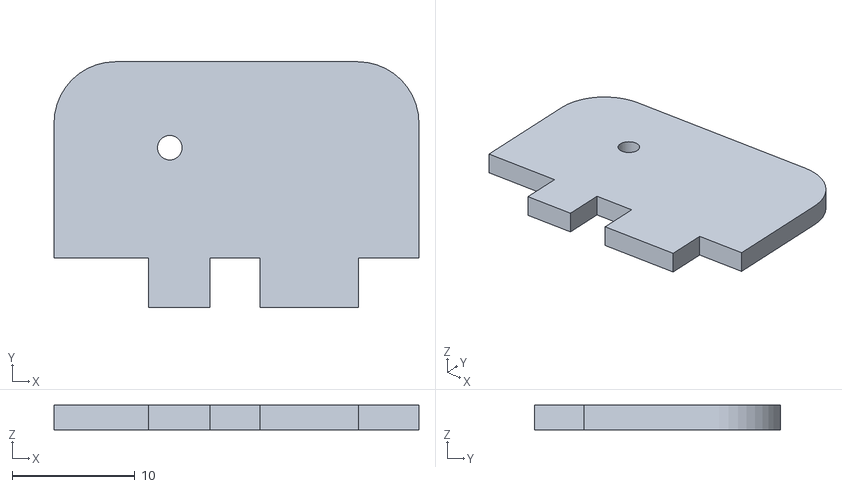
[picture p52: CAD file, 2017-01-14]
CADProsthetic/HandParameterized/ServoBase/Base HerkuleX/BracketHerkulex.STL
29.7 x 20.0 x 2.00
