liarokapisv/RobotHands/CADProsthetic/HandParameterized/ServoBase/Pulley/supportPulley1.STL

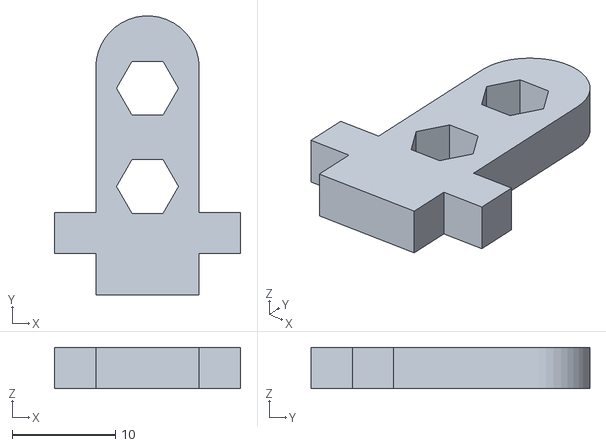
[picture p53: CAD file, 2017-01-14]
CADProsthetic/HandParameterized/ServoBase/Pulley/supportPulley1.STL
18.0 x 27.0 x 4.00
