liarokapisv/RobotHands/CADProsthetic/HandParameterized/ServoBase/src/Pulley/pulley.SLDPRT

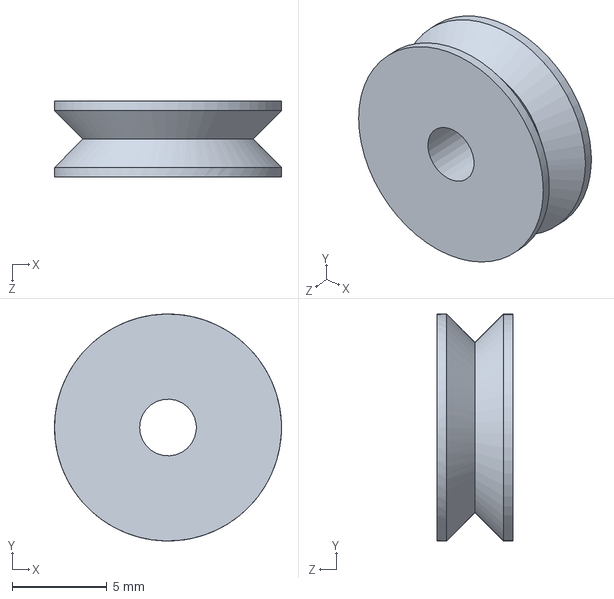
[picture p54: CAD file, 2017-01-14]
CADProsthetic/HandParameterized/ServoBase/src/Pulley/pulley.SLDPRT
12.0 x 12.0 x 4.00 mm
