liarokapisv/RobotHands/CADProsthetic/HandParameterized/Thumb_mechanism/lockMechanismSupport.STL

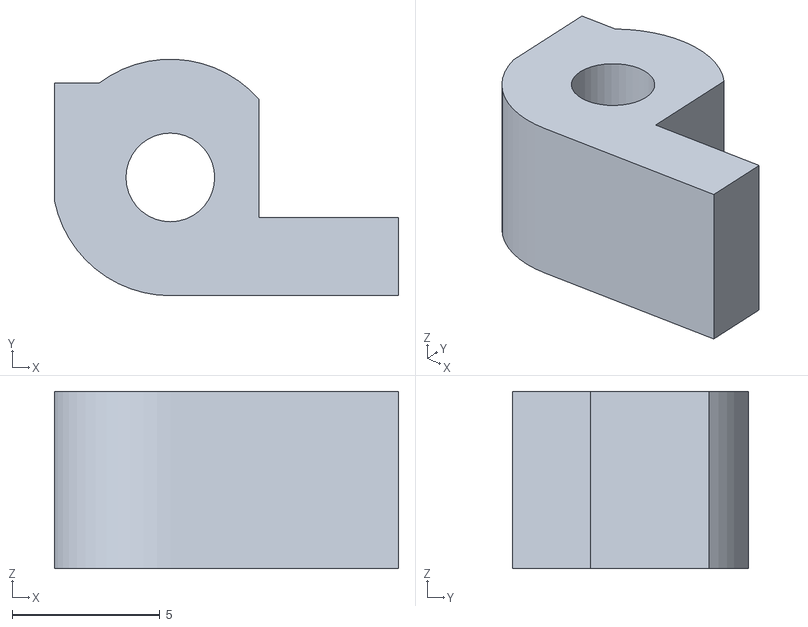
[picture p55: CAD file, 2017-01-14]
CADProsthetic/HandParameterized/Thumb_mechanism/lockMechanismSupport.STL
11.6 x 8.00 x 6.00
