liarokapisv/RobotHands/CADProsthetic/HandParameterized/Thumb_mechanism/src/thumbBase.SLDPRT

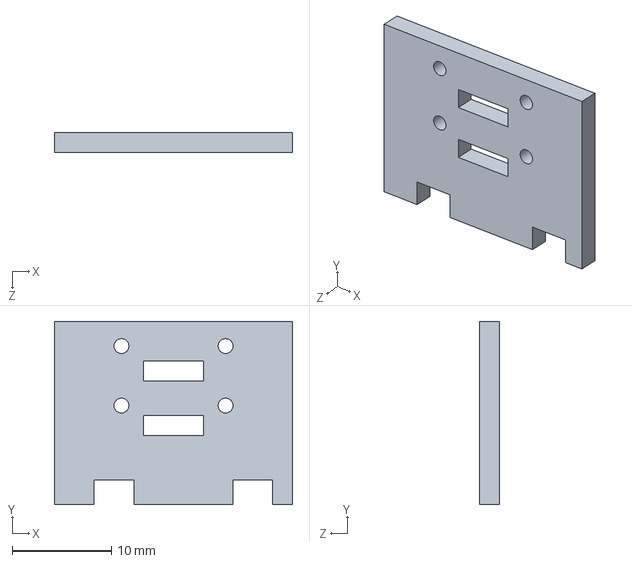
[picture p56: CAD file, 2017-01-14]
CADProsthetic/HandParameterized/Thumb_mechanism/src/thumbBase.SLDPRT
24.0 x 18.5 x 2.00 mm
