liarokapisv/RobotHands/CADProsthetic/HandParameterized/Whipheel_tree/src/barIndexMiddle.SLDPRT

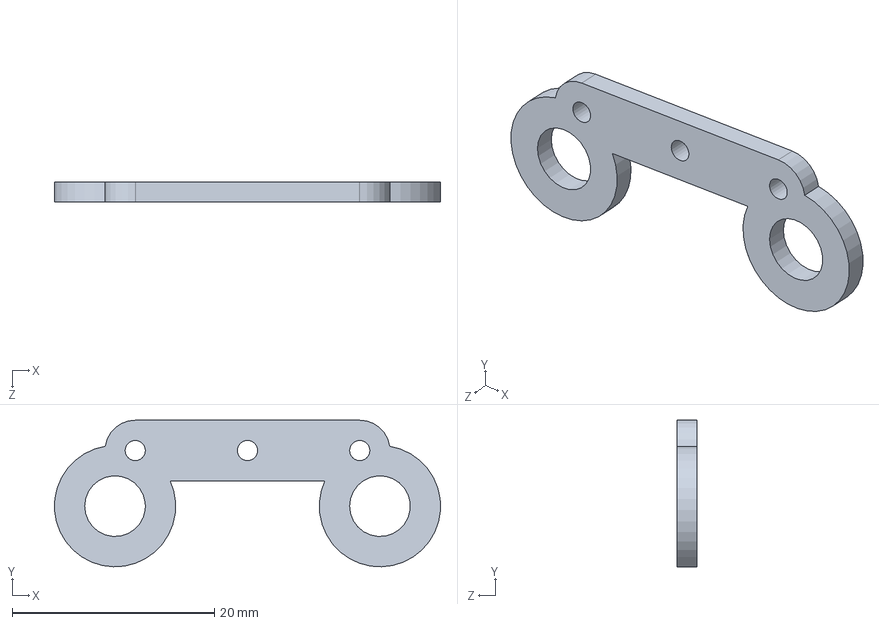
[picture p57: CAD file, 2017-01-14]
CADProsthetic/HandParameterized/Whipheel_tree/src/barIndexMiddle.SLDPRT
38.2 x 14.5 x 2.00 mm
