liarokapisv/RobotHands/CADRoboticNewVersion/Common Parts/Joint1.SLDPRT

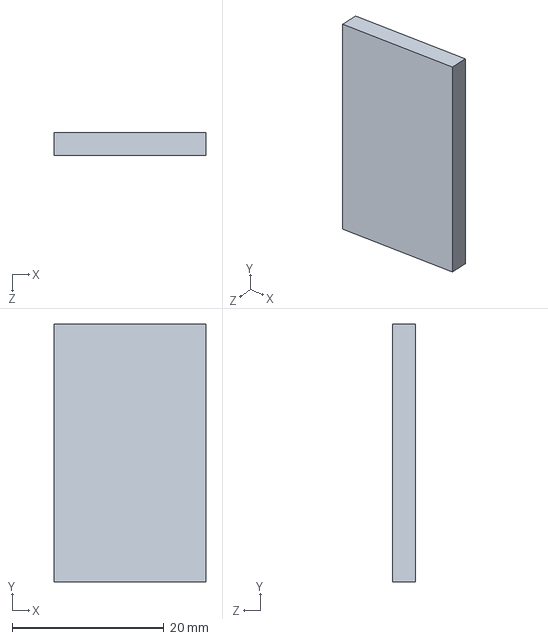
[picture p58: CAD file, 2017-01-14]
CADRoboticNewVersion/Common Parts/Joint1.SLDPRT
20.0 x 34.0 x 3.00 mm
