liarokapisv/RobotHands/CADRoboticNewVersion/Couplings/Mount_Kuka-Youbot.SLDPRT

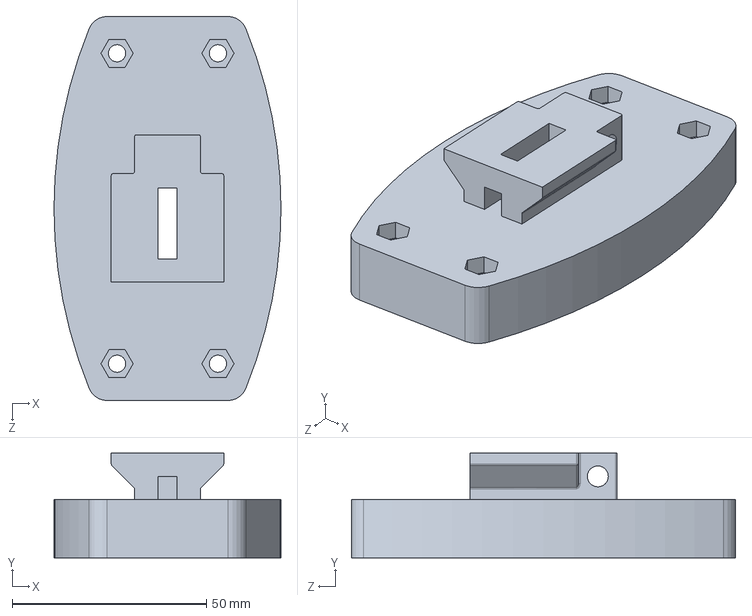
[picture p59: CAD file, 2017-01-14]
CADRoboticNewVersion/Couplings/Mount_Kuka-Youbot.SLDPRT
58.5 x 27.0 x 99.0 mm
