liarokapisv/RobotHands/CADRoboticNewVersion/Interfaces/Extension/dovetail_male_RobotHandExtension.SLDPRT

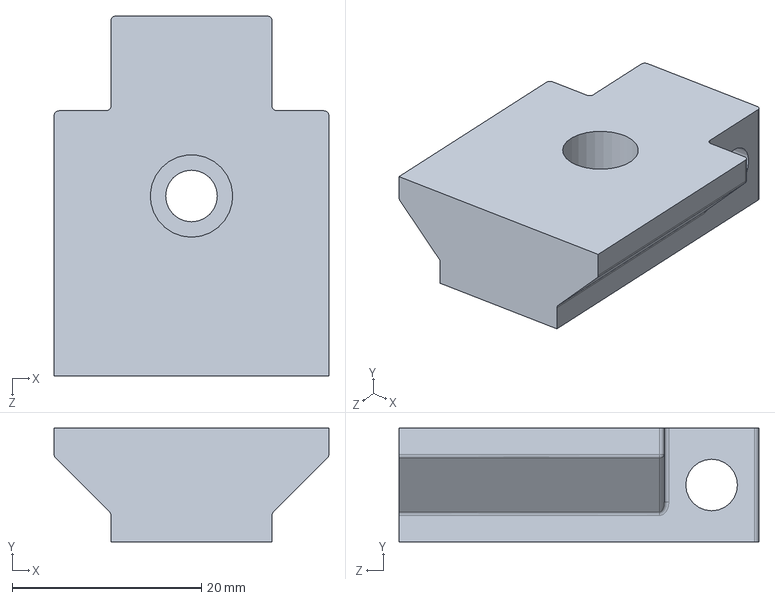
[picture p60: CAD file, 2017-01-14]
CADRoboticNewVersion/Interfaces/Extension/dovetail_male_RobotHandExtension.SLDPRT
29.0 x 12.0 x 38.0 mm
