liarokapisv/RobotHands/CADRoboticNewVersion/Interfaces/SliderBox/SliderBottom.SLDPRT

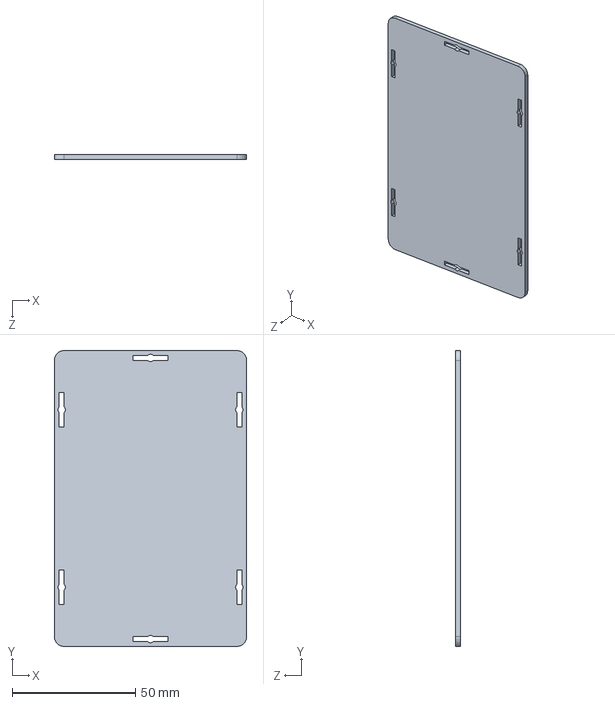
[picture p61: CAD file, 2017-01-14]
CADRoboticNewVersion/Interfaces/SliderBox/SliderBottom.SLDPRT
78.0 x 120.0 x 2.00 mm
