liarokapisv/RobotHands/CADRoboticNewVersion/RobotHand/3d Printed/Robot Finger/FingerDIP.SLDPRT

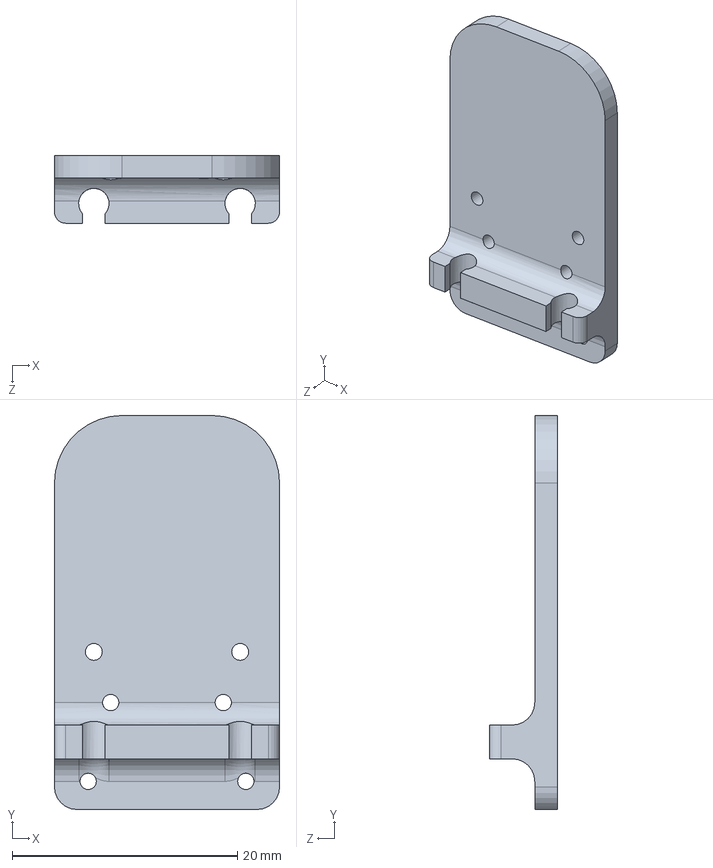
[picture p62: CAD file, 2017-01-14]
CADRoboticNewVersion/RobotHand/3d Printed/Robot Finger/FingerDIP.SLDPRT
20.0 x 35.0 x 6.00 mm
