liarokapisv/RobotHands/CADRoboticNewVersion/RobotHand/Laser Cutted/Robot Base/MountPA10_3.SLDPRT

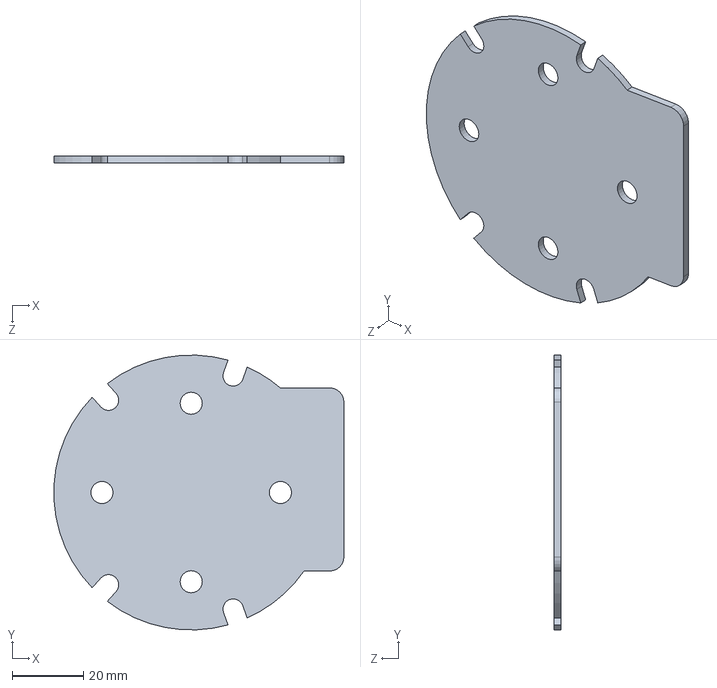
[picture p63: CAD file, 2017-01-14]
CADRoboticNewVersion/RobotHand/Laser Cutted/Robot Base/MountPA10_3.SLDPRT
81.2 x 76.9 x 2.00 mm
