liarokapisv/RobotHands/CADRoboticNewVersion/RobotHand/Laser Cutted/Robot Finger/JointBase1.SLDPRT

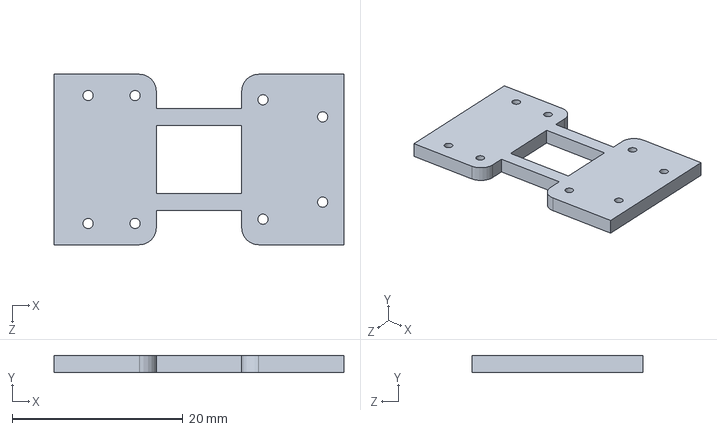
[picture p64: CAD file, 2017-01-14]
CADRoboticNewVersion/RobotHand/Laser Cutted/Robot Finger/JointBase1.SLDPRT
34.0 x 2.00 x 20.0 mm
