liarokapisv/RobotHands/CAD/FinalParts/FingerTopPlate.sldprt

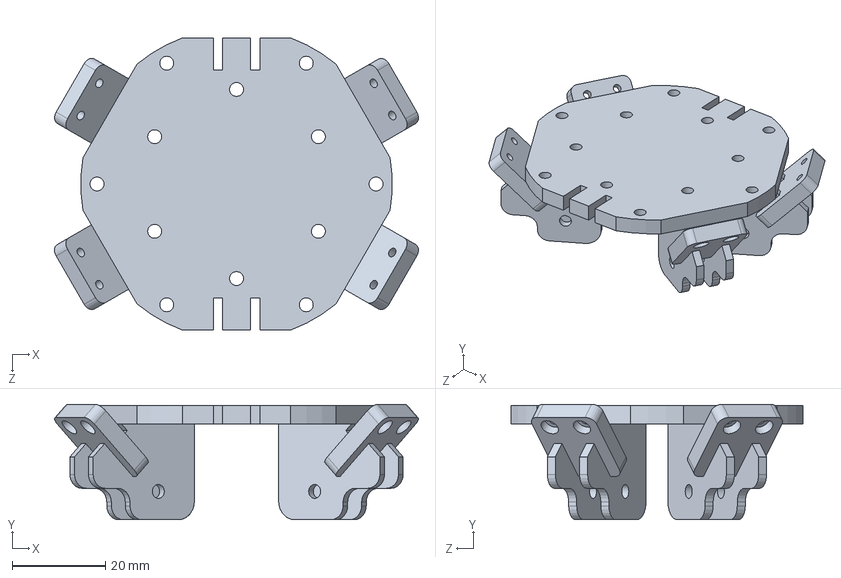
[picture p65: CAD file, 2017-01-19]
CAD/FinalParts/FingerTopPlate.sldprt
78.3 x 24.8 x 62.8 mm
