liarokapisv/RobotHands/CAD/Laser/RobotHand_AX12.dxf

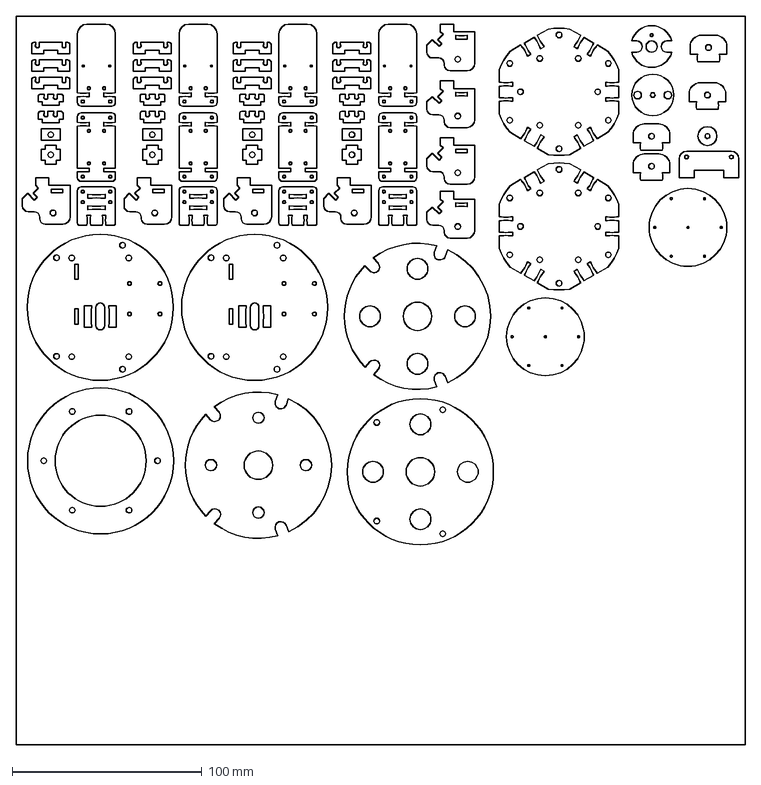
[picture p66: CAD file, 2017-01-14]
CAD/Laser/RobotHand_AX12.dxf
384.0 x 384.0 mm
