liarokapisv/RobotHands/CAD/Robot Base stdServo/MiddlePlate.STL

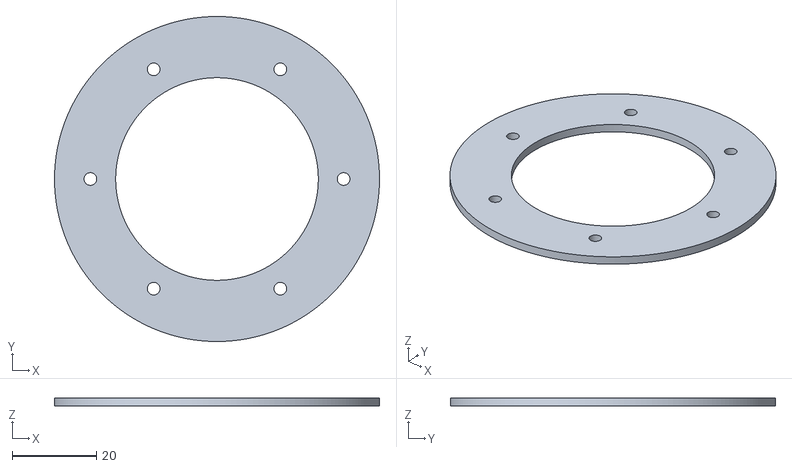
[picture p67: CAD file, 2017-01-14]
CAD/Robot Base stdServo/MiddlePlate.STL
77.0 x 77.0 x 2.00
