liarokapisv/RobotHands/CAD/Robot Base stdServo/src/BottomPlateStdServo.SLDPRT

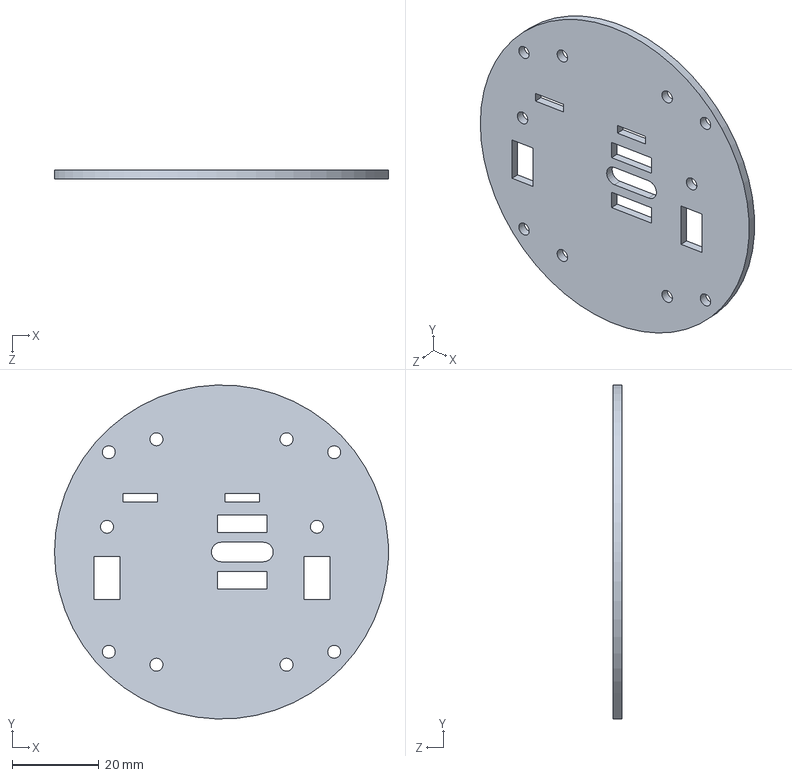
[picture p68: CAD file, 2017-01-19]
CAD/Robot Base stdServo/src/BottomPlateStdServo.SLDPRT
77.0 x 77.0 x 2.00 mm
