liarokapisv/RobotHands/CAD/Robot Finger/FingerBase.STL

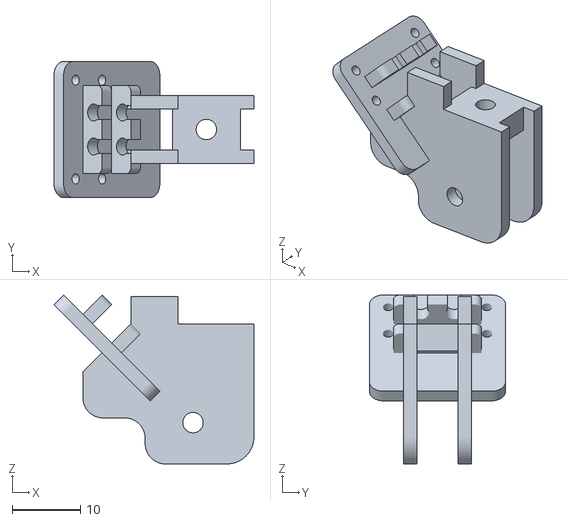
[picture p69: CAD file, 2017-01-14]
CAD/Robot Finger/FingerBase.STL
29.4 x 20.0 x 24.8
