liarokapisv/RobotHands/CAD/Robot Flange/src/flangeStdServo_1.SLDPRT

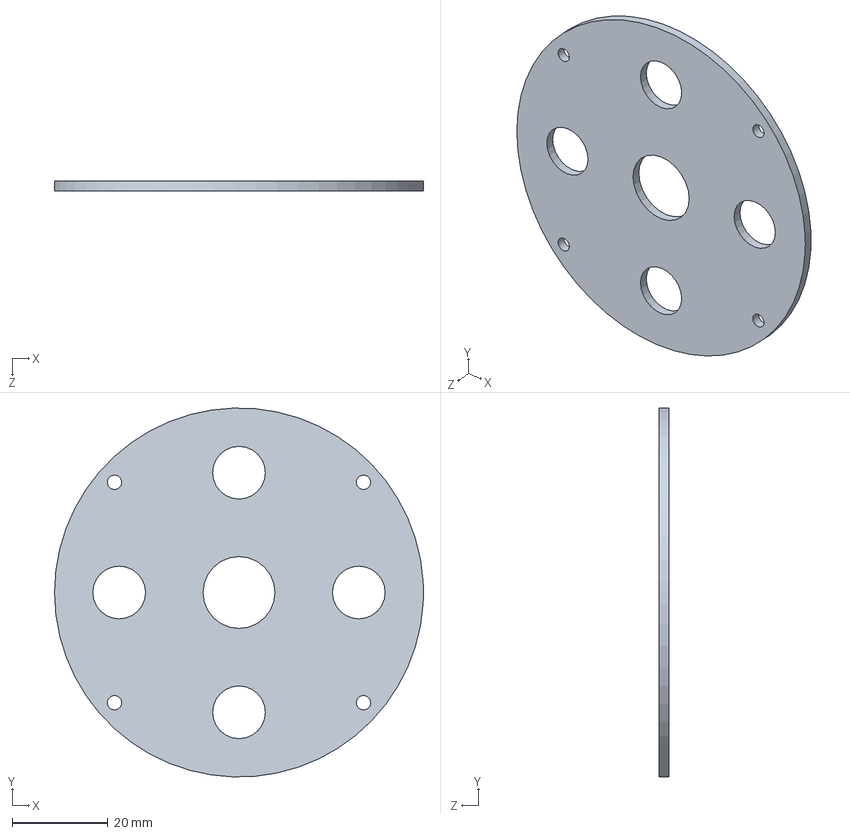
[picture p70: CAD file, 2017-01-19]
CAD/Robot Flange/src/flangeStdServo_1.SLDPRT
77.0 x 77.0 x 2.00 mm
