liarokapisv/RobotHands/CADProsthetic/HandParameterized/Button/buttonAxle.STL

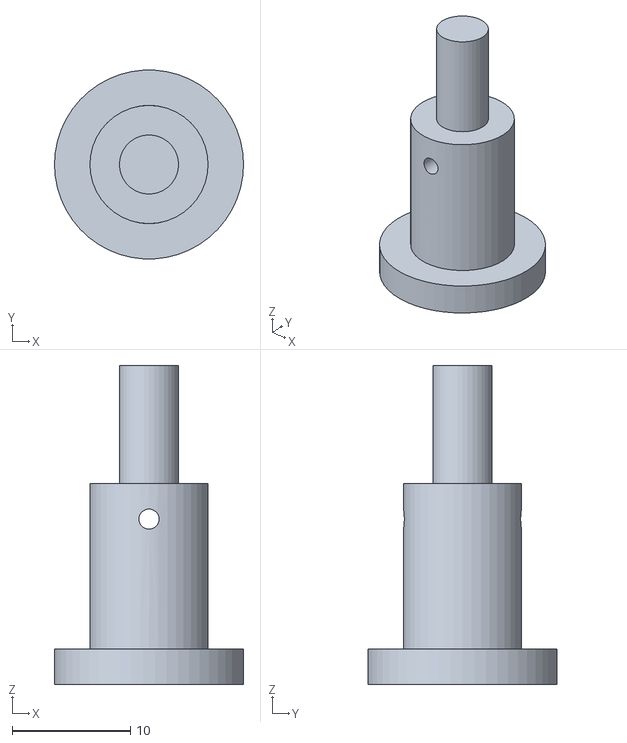
[picture p71: CAD file, 2017-01-14]
CADProsthetic/HandParameterized/Button/buttonAxle.STL
16.0 x 16.0 x 27.0
