liarokapisv/RobotHands/CADProsthetic/HandParameterized/Fingers/Common Parts/driverBaseFrame2.STL

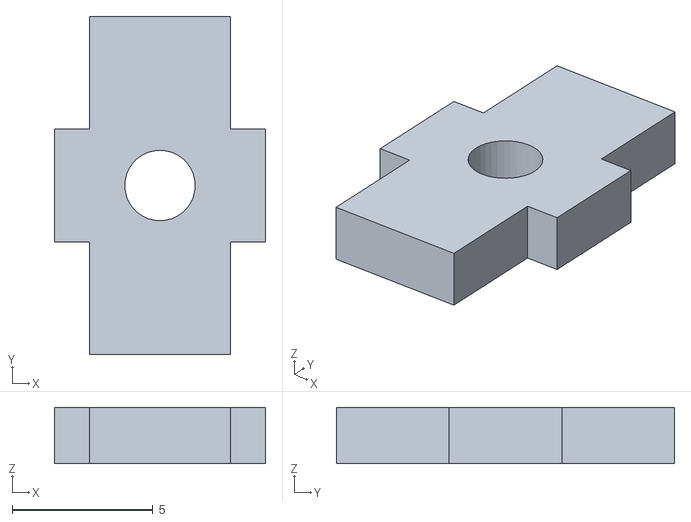
[picture p72: CAD file, 2017-01-14]
CADProsthetic/HandParameterized/Fingers/Common Parts/driverBaseFrame2.STL
7.50 x 12.0 x 2.00
