liarokapisv/RobotHands/CADProsthetic/HandParameterized/Fingers/Index/indexDIP.STL

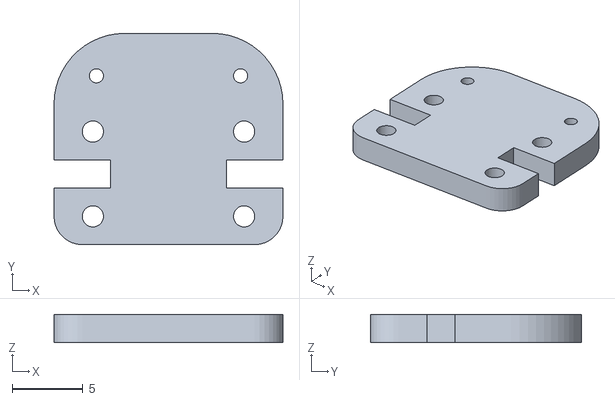
[picture p73: CAD file, 2017-01-14]
CADProsthetic/HandParameterized/Fingers/Index/indexDIP.STL
16.2 x 14.9 x 2.00
