liarokapisv/RobotHands/CADProsthetic/HandParameterized/Fingers/Pinky/pinkyPIP.STL

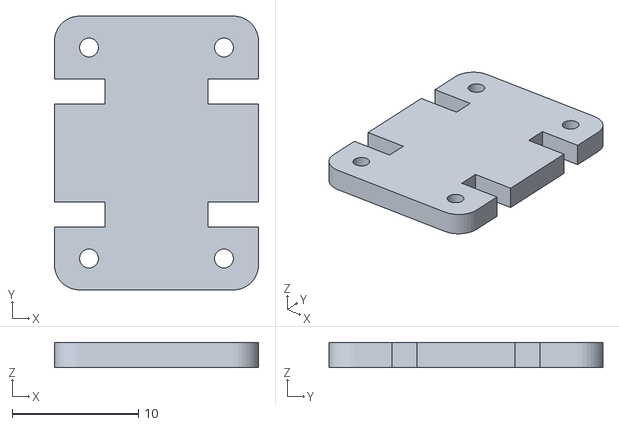
[picture p74: CAD file, 2017-01-14]
CADProsthetic/HandParameterized/Fingers/Pinky/pinkyPIP.STL
16.2 x 21.7 x 2.00
