liarokapisv/RobotHands/CADProsthetic/HandParameterized/Fingers/Ring/ringPIP.STL

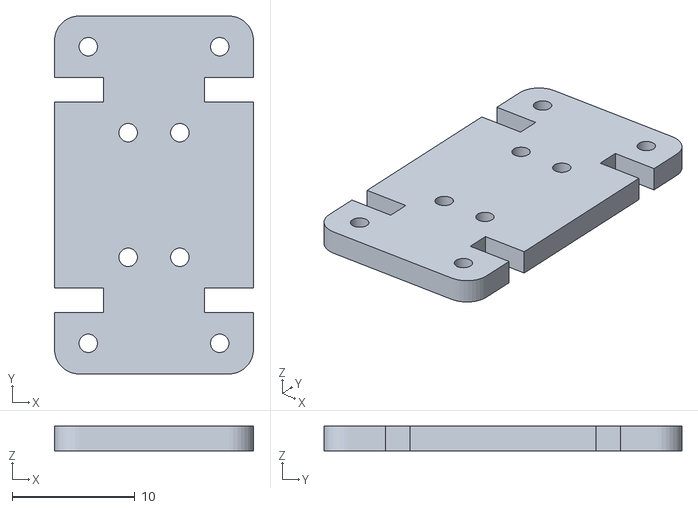
[picture p75: CAD file, 2017-01-14]
CADProsthetic/HandParameterized/Fingers/Ring/ringPIP.STL
16.2 x 29.1 x 2.00
