liarokapisv/RobotHands/CADProsthetic/HandParameterized/Fingers/src/Middle/middleTube2.SLDPRT

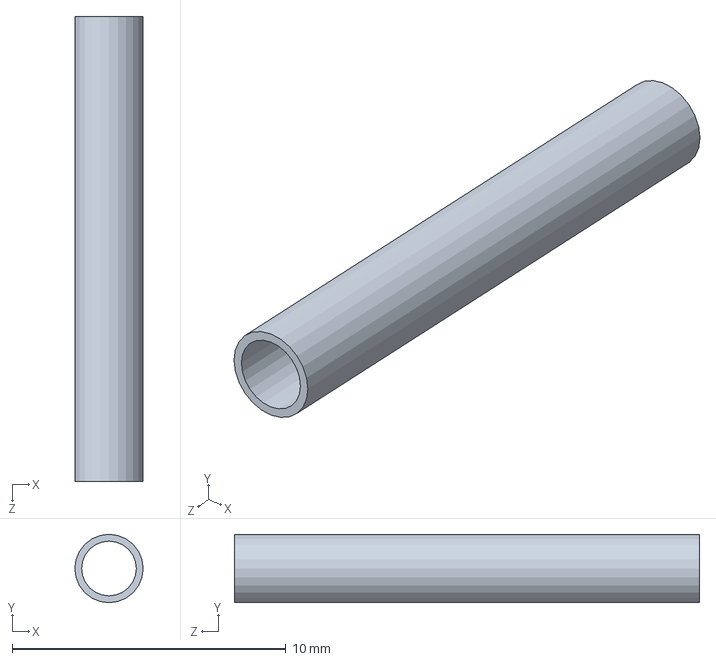
[picture p76: CAD file, 2017-01-14]
CADProsthetic/HandParameterized/Fingers/src/Middle/middleTube2.SLDPRT
2.50 x 2.50 x 17.0 mm
