liarokapisv/RobotHands/CADProsthetic/HandParameterized/Fingers/src/Pinky/pinkyTube3.SLDPRT

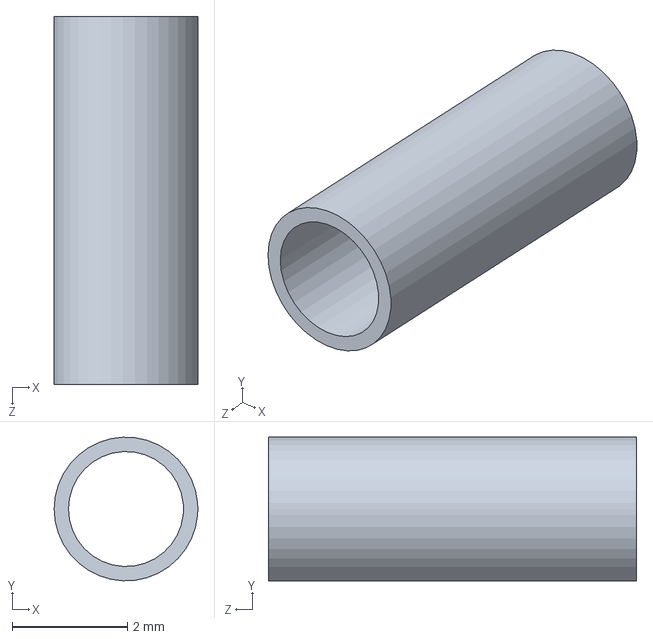
[picture p77: CAD file, 2017-01-14]
CADProsthetic/HandParameterized/Fingers/src/Pinky/pinkyTube3.SLDPRT
2.50 x 2.50 x 6.40 mm
