liarokapisv/RobotHands/CADProsthetic/HandParameterized/Fingers/src/Ring/ringElastomer.SLDPRT

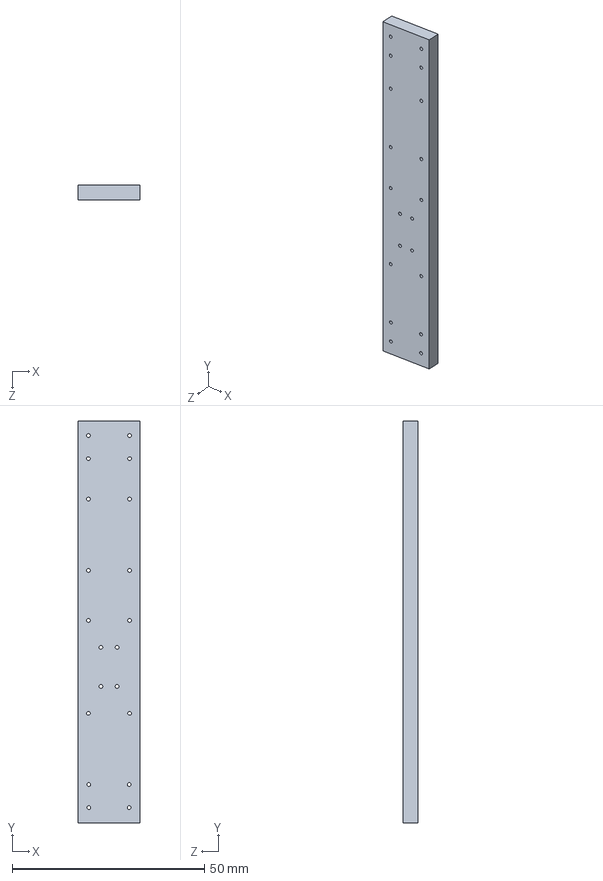
[picture p78: CAD file, 2017-01-14]
CADProsthetic/HandParameterized/Fingers/src/Ring/ringElastomer.SLDPRT
16.2 x 104.5 x 4.00 mm
