liarokapisv/RobotHands/CADProsthetic/HandParameterized/Fingers/src/Thumb/tubeDriver.SLDPRT

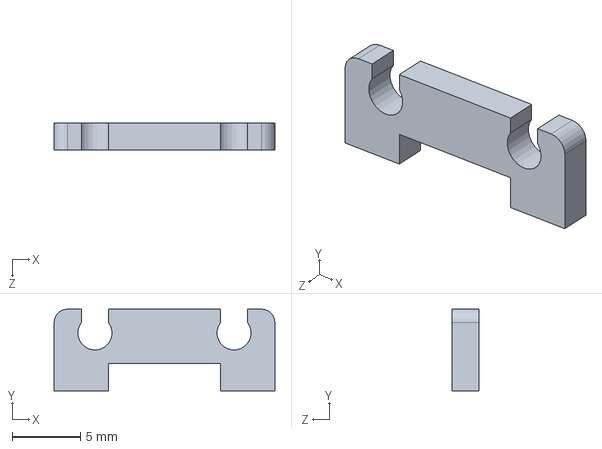
[picture p79: CAD file, 2017-01-14]
CADProsthetic/HandParameterized/Fingers/src/Thumb/tubeDriver.SLDPRT
16.2 x 6.00 x 2.00 mm
