liarokapisv/RobotHands/CADProsthetic/HandParameterized/Fingers/Thumb/thumbPIP.STL

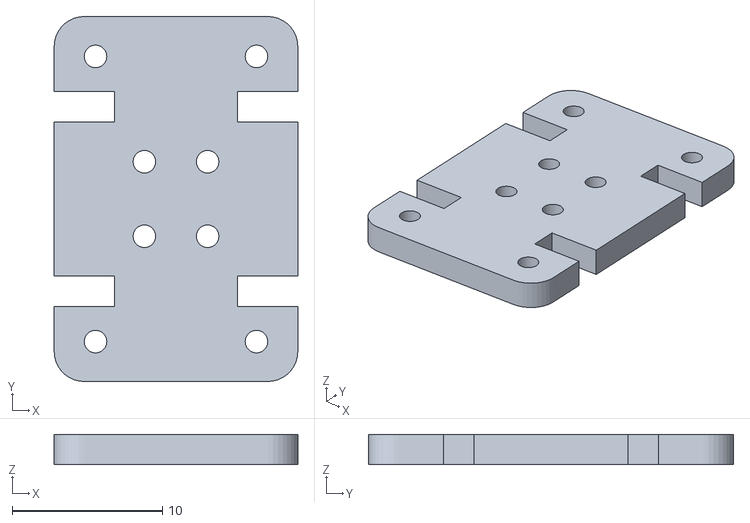
[picture p80: CAD file, 2017-01-14]
CADProsthetic/HandParameterized/Fingers/Thumb/thumbPIP.STL
16.2 x 24.3 x 2.00
