liarokapisv/RobotHands/CADProsthetic/HandParameterized/Flange/src/flange.SLDPRT

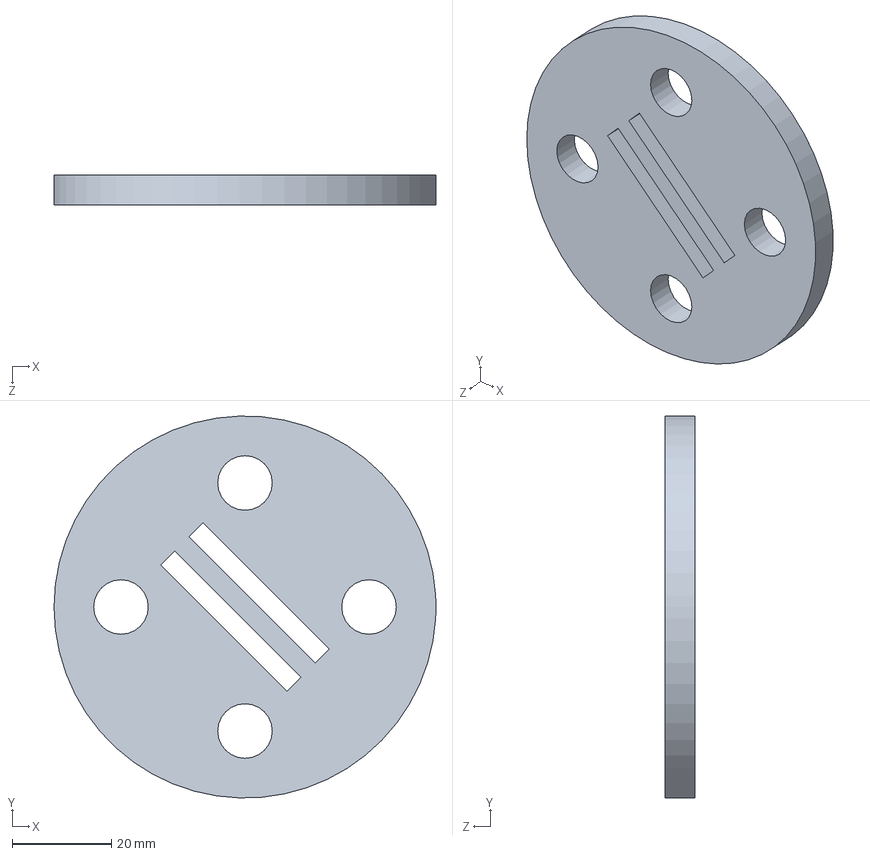
[picture p81: CAD file, 2017-01-14]
CADProsthetic/HandParameterized/Flange/src/flange.SLDPRT
77.0 x 77.0 x 6.00 mm
