liarokapisv/RobotHands/CADProsthetic/HandParameterized/ServoBase/Base HerkuleX/MiniBaseHerkulex.STL

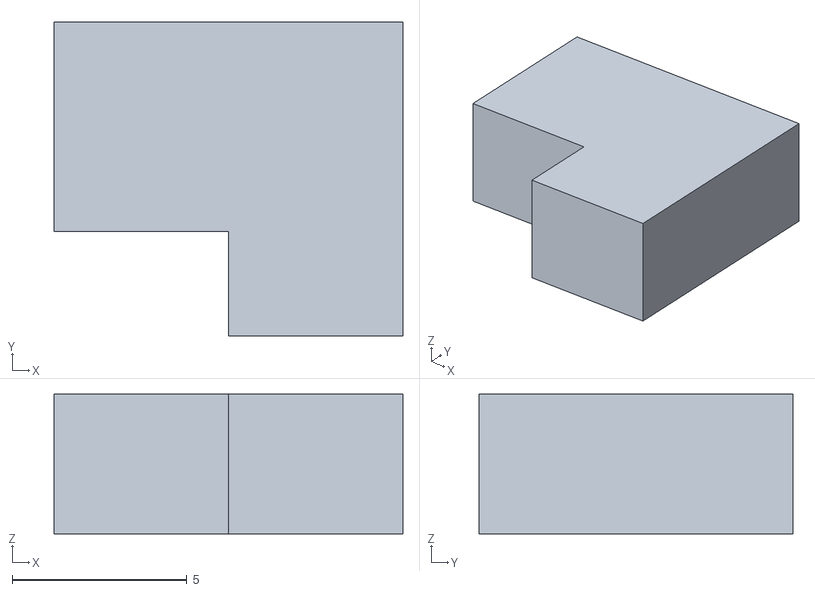
[picture p82: CAD file, 2017-01-14]
CADProsthetic/HandParameterized/ServoBase/Base HerkuleX/MiniBaseHerkulex.STL
10.0 x 9.00 x 4.00
