liarokapisv/RobotHands/CADProsthetic/HandParameterized/ServoBase/Pulley/supportPulleyPalmUp2.STL

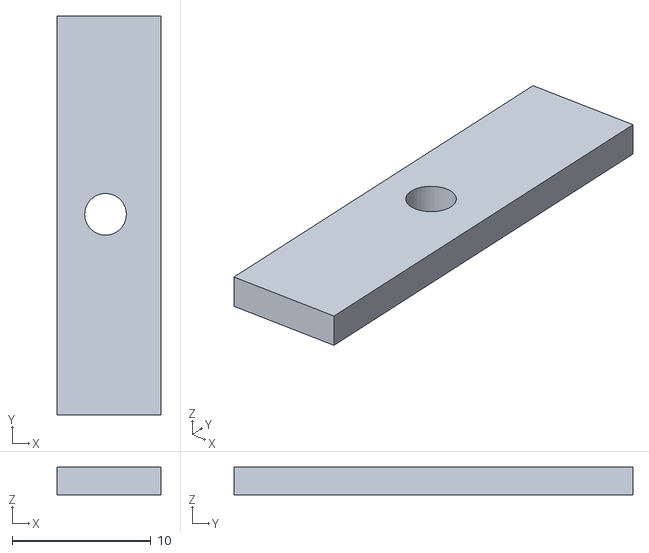
[picture p83: CAD file, 2017-01-14]
CADProsthetic/HandParameterized/ServoBase/Pulley/supportPulleyPalmUp2.STL
7.50 x 28.7 x 2.00
