liarokapisv/RobotHands/CADProsthetic/HandParameterized/ServoBase/src/Base HerkuleX/BracketHerkulex2.SLDPRT

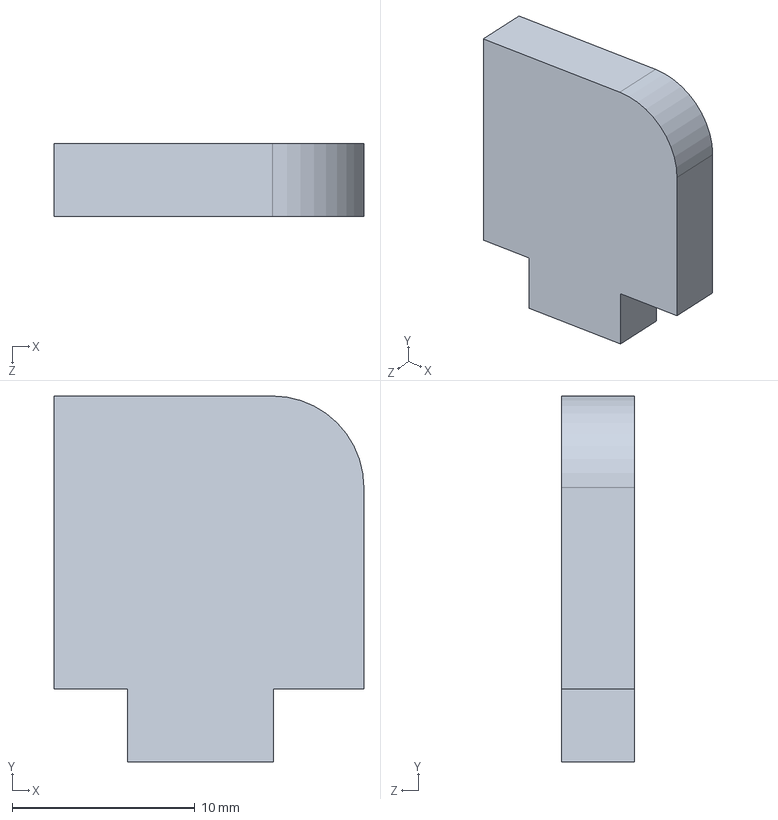
[picture p84: CAD file, 2017-01-14]
CADProsthetic/HandParameterized/ServoBase/src/Base HerkuleX/BracketHerkulex2.SLDPRT
16.9 x 20.0 x 4.00 mm
