liarokapisv/RobotHands/CADProsthetic/HandParameterized/ServoBase/src/Pulley/supportPulleyPalmUp.SLDPRT

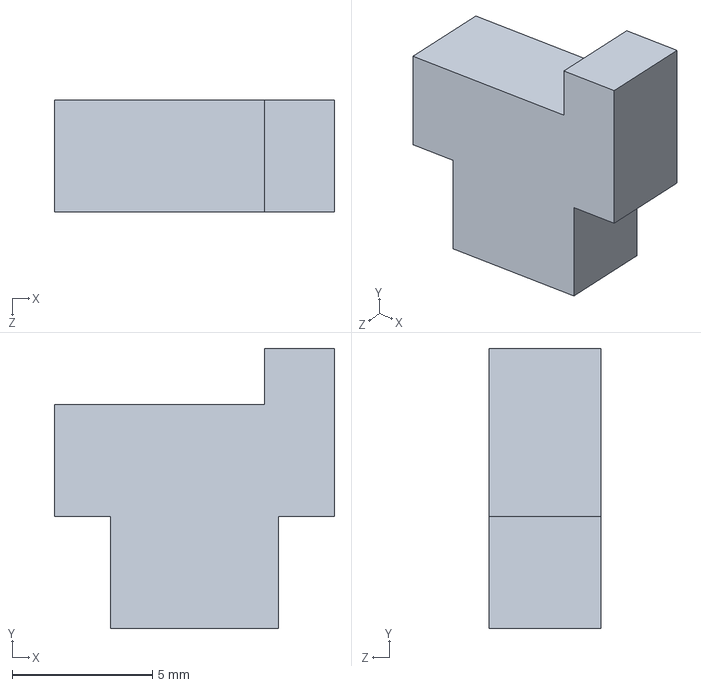
[picture p85: CAD file, 2017-01-14]
CADProsthetic/HandParameterized/ServoBase/src/Pulley/supportPulleyPalmUp.SLDPRT
10.0 x 10.0 x 4.00 mm
