liarokapisv/RobotHands/CADProsthetic/HandParameterized/Thumb_mechanism/src/thumbMovingBracketUp.SLDPRT

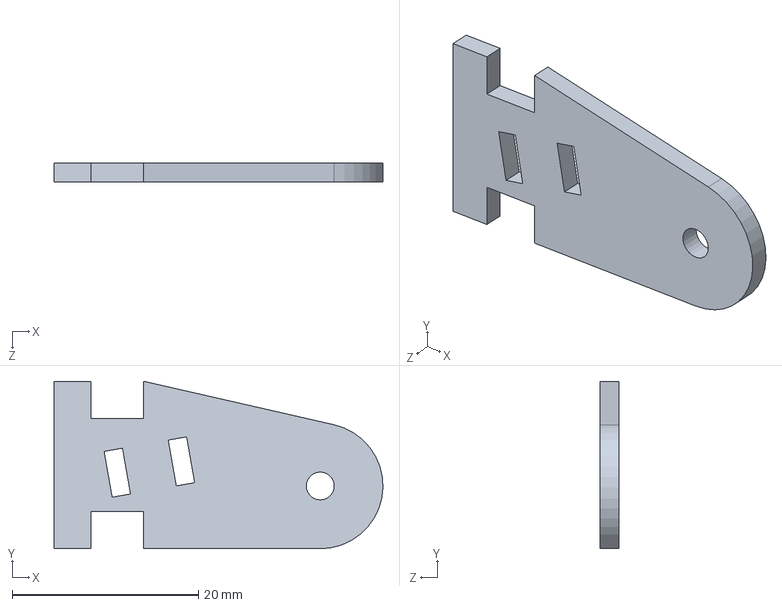
[picture p86: CAD file, 2017-01-14]
CADProsthetic/HandParameterized/Thumb_mechanism/src/thumbMovingBracketUp.SLDPRT
35.4 x 18.0 x 2.00 mm
