liarokapisv/RobotHands/CADProsthetic/HandParameterized/Whipheel_tree/src/BasePulleyInsidePalm.SLDPRT

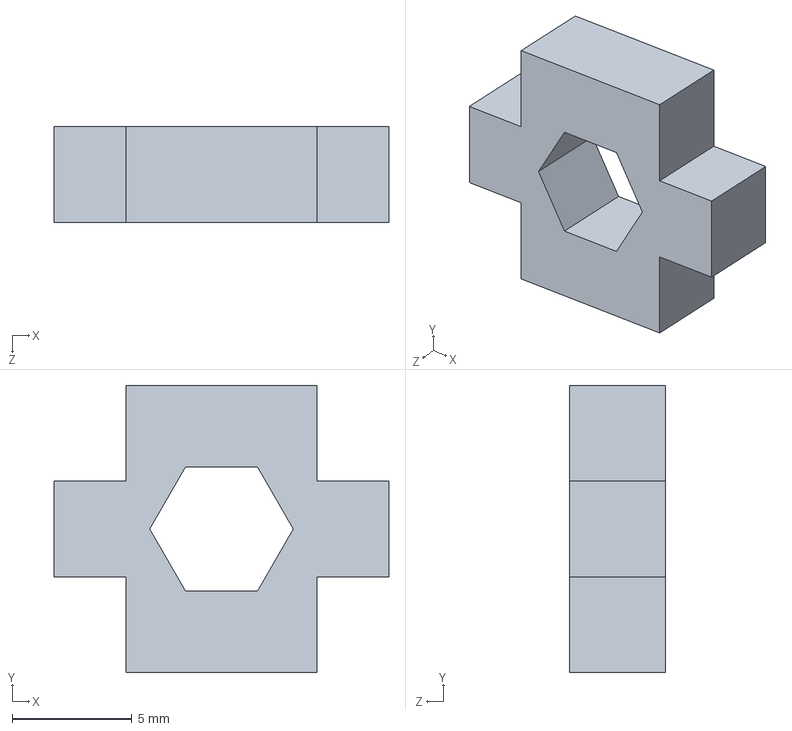
[picture p87: CAD file, 2017-01-14]
CADProsthetic/HandParameterized/Whipheel_tree/src/BasePulleyInsidePalm.SLDPRT
14.0 x 12.0 x 4.00 mm
