liarokapisv/RobotHands/CADRoboticNewVersion/Common Parts/tubePIP.SLDPRT

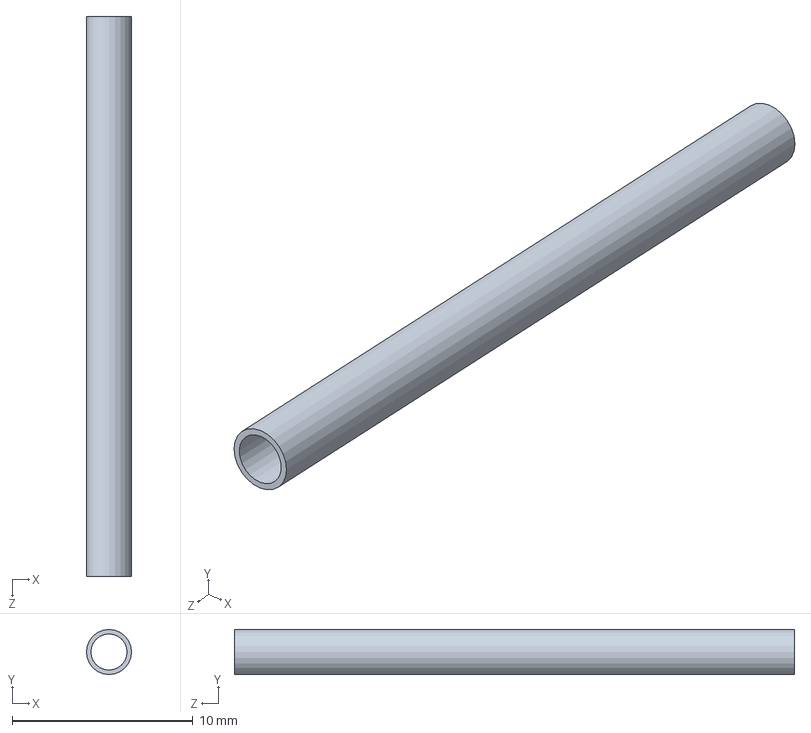
[picture p88: CAD file, 2017-01-14]
CADRoboticNewVersion/Common Parts/tubePIP.SLDPRT
2.50 x 2.50 x 31.0 mm
