liarokapisv/RobotHands/CADRoboticNewVersion/Couplings/dovetail_female.SLDPRT

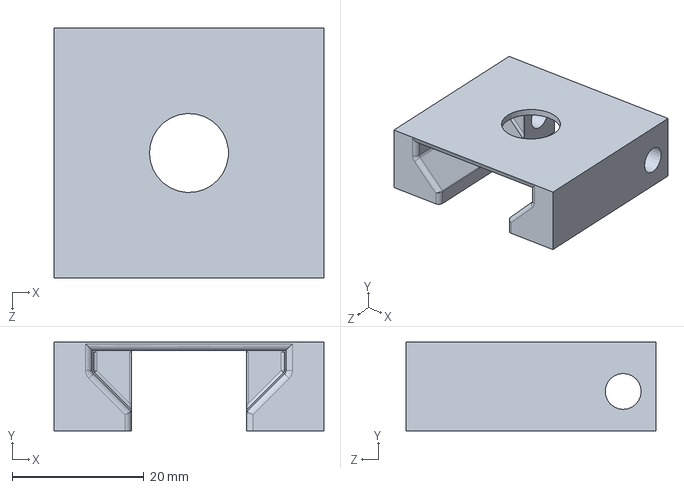
[picture p89: CAD file, 2017-01-14]
CADRoboticNewVersion/Couplings/dovetail_female.SLDPRT
41.0 x 13.5 x 38.0 mm
