liarokapisv/RobotHands/CADRoboticNewVersion/RobotHand/3d Printed/Robot Base/PCBMount.SLDPRT

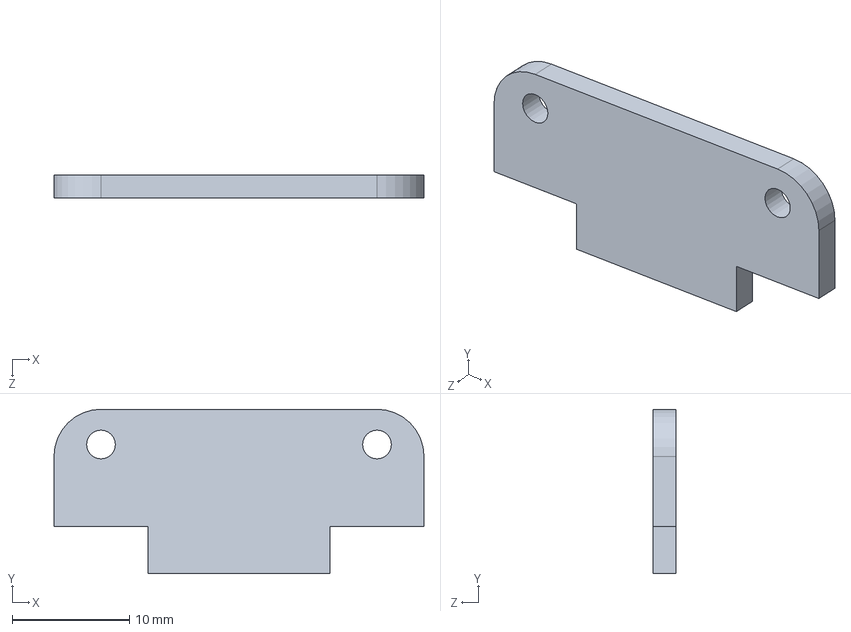
[picture p90: CAD file, 2017-01-14]
CADRoboticNewVersion/RobotHand/3d Printed/Robot Base/PCBMount.SLDPRT
31.5 x 14.0 x 2.00 mm
