liarokapisv/RobotHands/CADRoboticNewVersion/RobotHand/3d Printed/Robot Finger/FingerPIP.SLDPRT

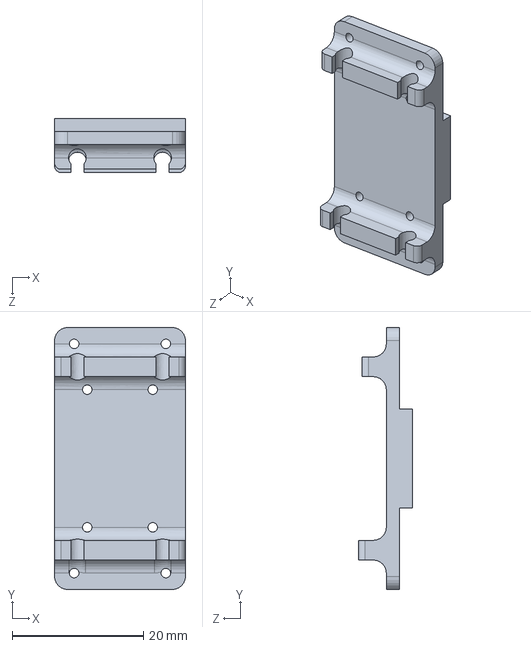
[picture p91: CAD file, 2017-01-14]
CADRoboticNewVersion/RobotHand/3d Printed/Robot Finger/FingerPIP.SLDPRT
20.0 x 40.0 x 8.25 mm
