liarokapisv/RobotHands/CADRoboticNewVersion/RobotHand/Laser Cutted/Robot Base/servoPulleyStd3.SLDPRT

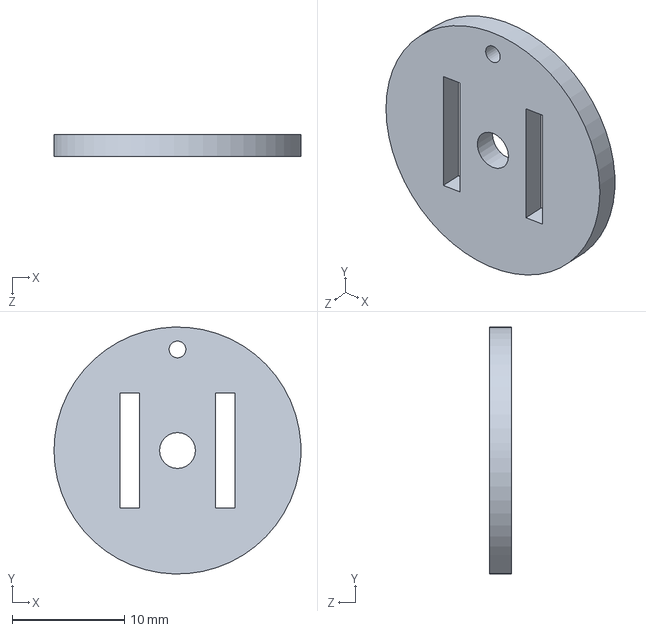
[picture p92: CAD file, 2017-01-14]
CADRoboticNewVersion/RobotHand/Laser Cutted/Robot Base/servoPulleyStd3.SLDPRT
22.0 x 22.0 x 2.00 mm
