liarokapisv/RobotHands/CADRoboticNewVersion/RobotHand/Laser Cutted/Robot Finger/TubePlateDIP.SLDPRT

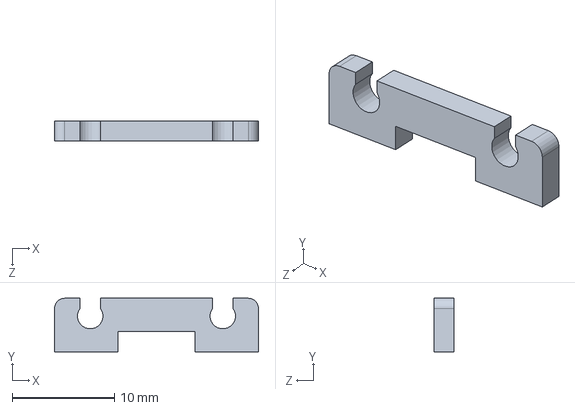
[picture p93: CAD file, 2017-01-14]
CADRoboticNewVersion/RobotHand/Laser Cutted/Robot Finger/TubePlateDIP.SLDPRT
20.0 x 5.25 x 2.00 mm
