liarokapisv/RobotHands/CAD/FinalParts/ServoPlate.sldprt

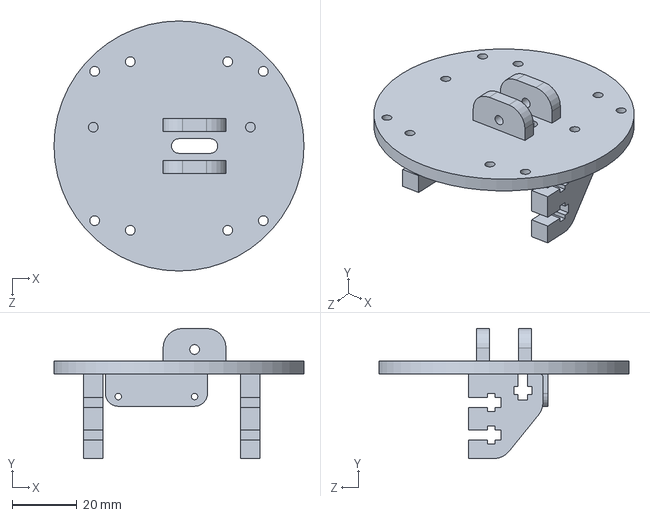
[picture p94: CAD file, 2017-01-19]
CAD/FinalParts/ServoPlate.sldprt
77.0 x 40.1 x 77.0 mm
