liarokapisv/RobotHands/CAD/Robot Base stdServo/servoPulleyStd3.STL

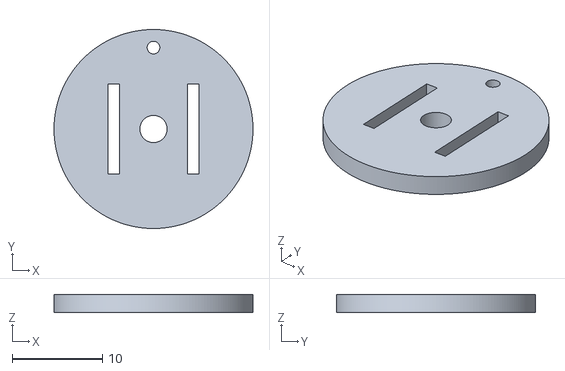
[picture p95: CAD file, 2017-01-14]
CAD/Robot Base stdServo/servoPulleyStd3.STL
22.0 x 22.0 x 2.00
