liarokapisv/RobotHands/CAD/Robot Base stdServo/src/stdServoBase.SLDPRT

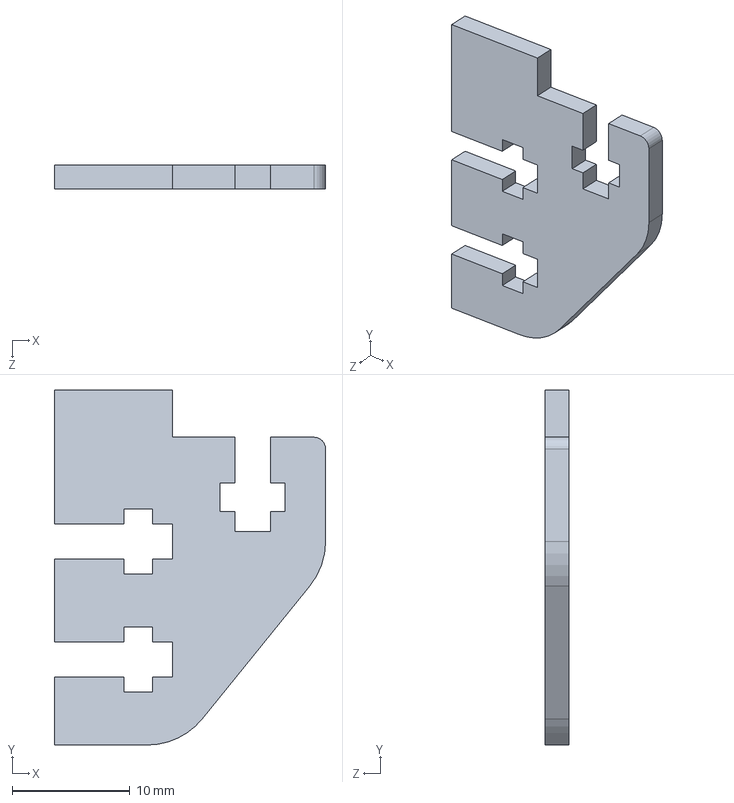
[picture p96: CAD file, 2017-01-19]
CAD/Robot Base stdServo/src/stdServoBase.SLDPRT
23.0 x 30.1 x 2.00 mm
