liarokapisv/RobotHands/CAD/Robot Finger/src/FingerBase1.SLDPRT

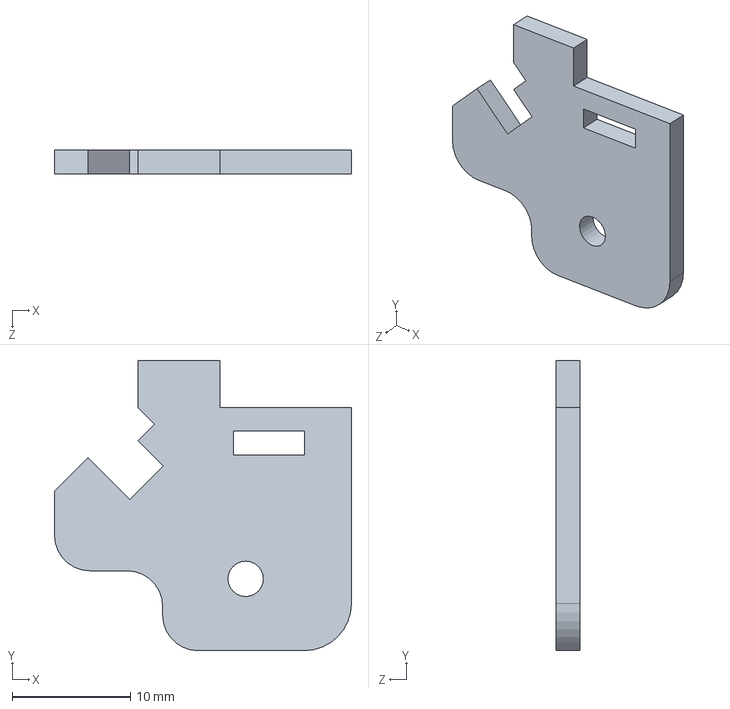
[picture p97: CAD file, 2017-01-19]
CAD/Robot Finger/src/FingerBase1.SLDPRT
25.2 x 24.6 x 2.00 mm
