liarokapisv/RobotHands/CAD/Robot Finger/TopPlate.STL

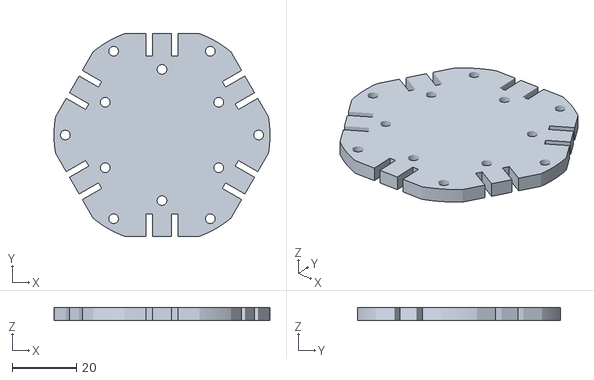
[picture p98: CAD file, 2017-01-14]
CAD/Robot Finger/TopPlate.STL
67.0 x 62.8 x 4.00
