liarokapisv/RobotHands/CADProsthetic/HandParameterized/Button/buttonFrame.STL

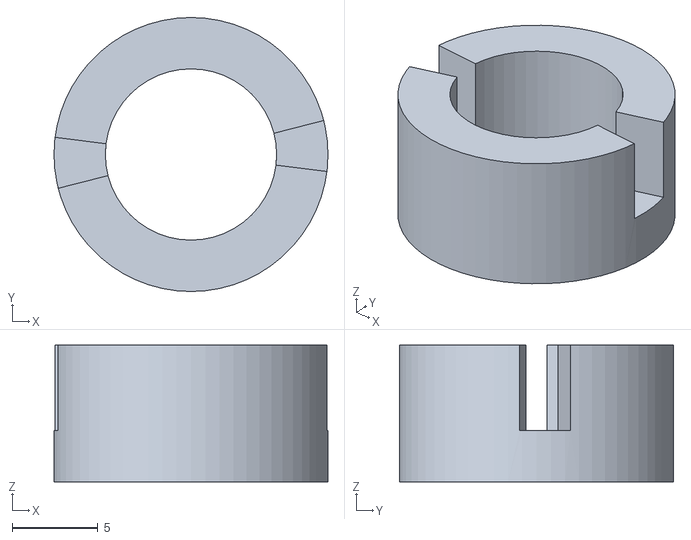
[picture p99: CAD file, 2017-01-14]
CADProsthetic/HandParameterized/Button/buttonFrame.STL
16.0 x 16.0 x 8.00
