liarokapisv/RobotHands/CADProsthetic/HandParameterized/Fingers/Index/indexMIP.STL

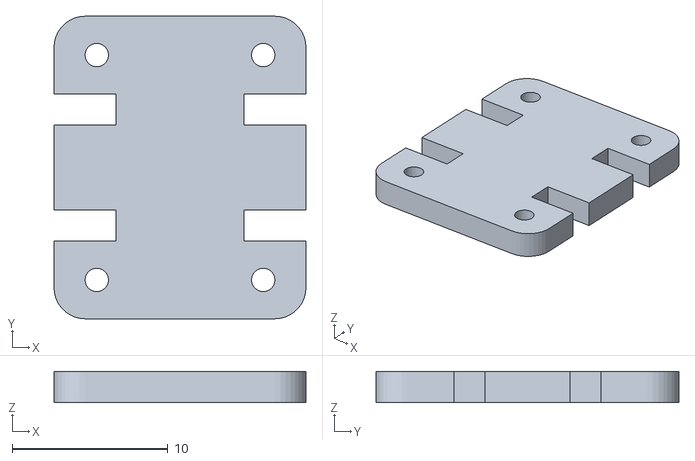
[picture p100: CAD file, 2017-01-14]
CADProsthetic/HandParameterized/Fingers/Index/indexMIP.STL
16.2 x 19.5 x 2.00
