liarokapisv/RobotHands/CADProsthetic/HandParameterized/Fingers/Middle/middleDIP.STL

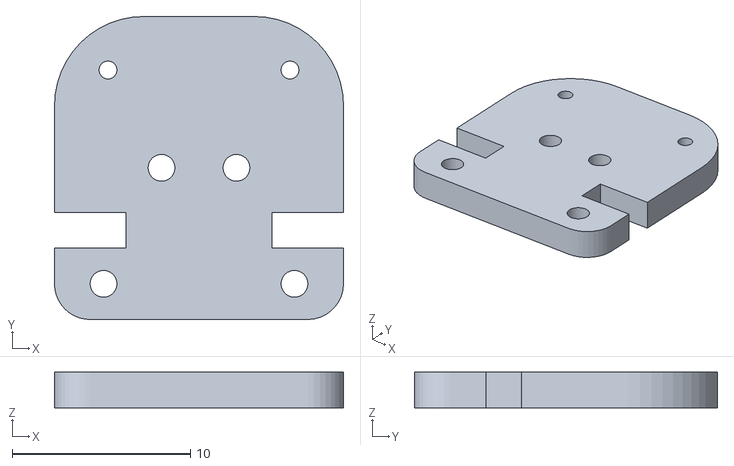
[picture p101: CAD file, 2017-01-14]
CADProsthetic/HandParameterized/Fingers/Middle/middleDIP.STL
16.2 x 17.0 x 2.00
