liarokapisv/RobotHands/CADProsthetic/HandParameterized/Fingers/Ring/ringMIP.STL

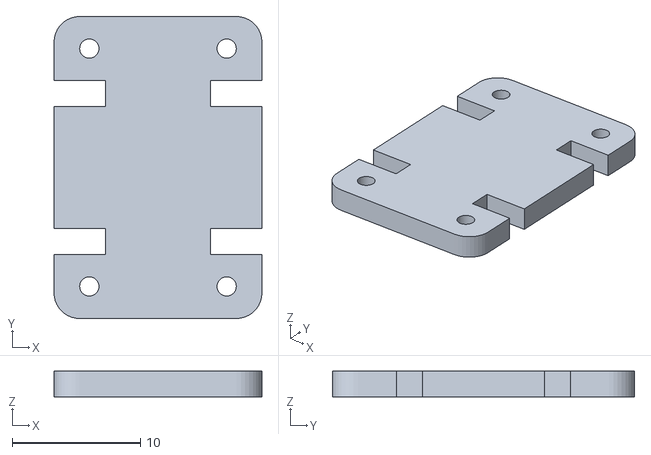
[picture p102: CAD file, 2017-01-14]
CADProsthetic/HandParameterized/Fingers/Ring/ringMIP.STL
16.2 x 23.5 x 2.00
