liarokapisv/RobotHands/CADProsthetic/HandParameterized/Fingers/src/Common Parts/commonFingersTube.SLDPRT

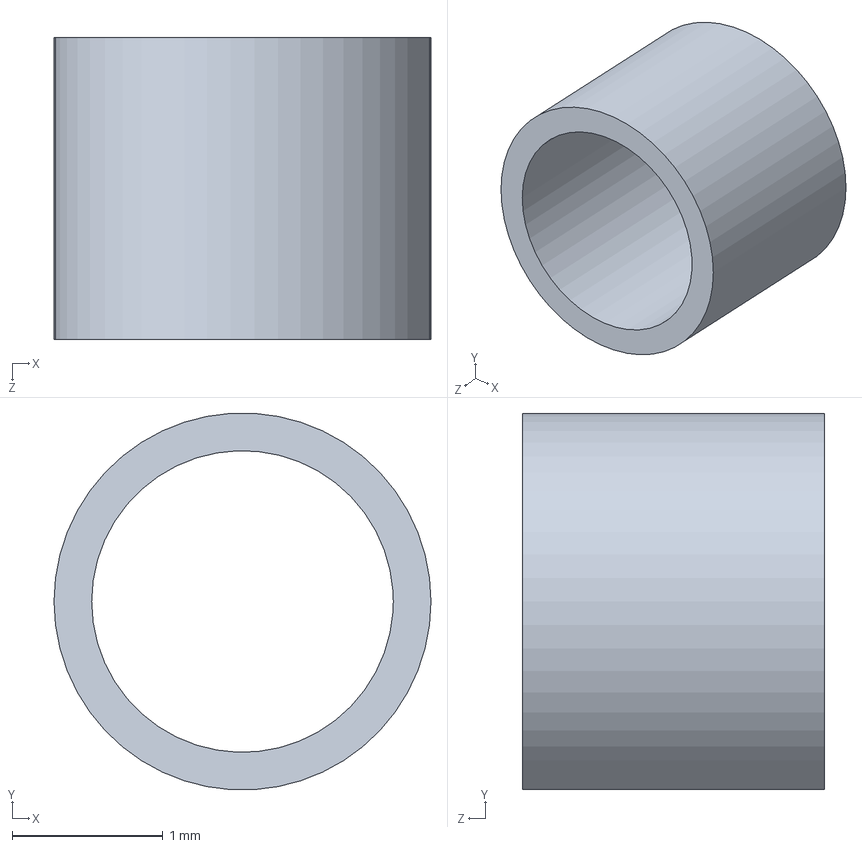
[picture p103: CAD file, 2017-01-14]
CADProsthetic/HandParameterized/Fingers/src/Common Parts/commonFingersTube.SLDPRT
2.50 x 2.50 x 2.00 mm
