liarokapisv/RobotHands/CADProsthetic/HandParameterized/Fingers/src/Index/indexElastomer.SLDPRT

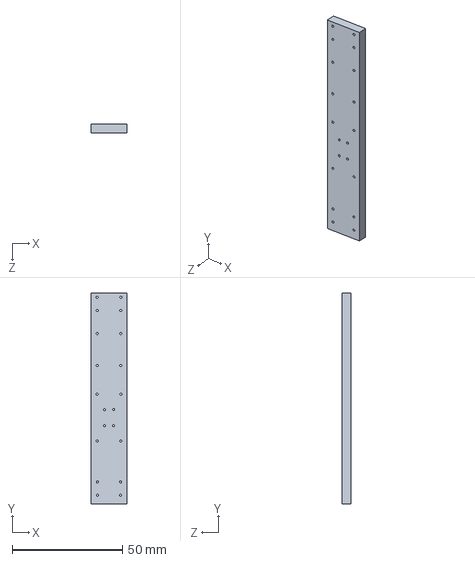
[picture p104: CAD file, 2017-01-14]
CADProsthetic/HandParameterized/Fingers/src/Index/indexElastomer.SLDPRT
16.2 x 95.7 x 4.00 mm
