liarokapisv/RobotHands/CADProsthetic/HandParameterized/Fingers/src/Ring/ringTube1.SLDPRT

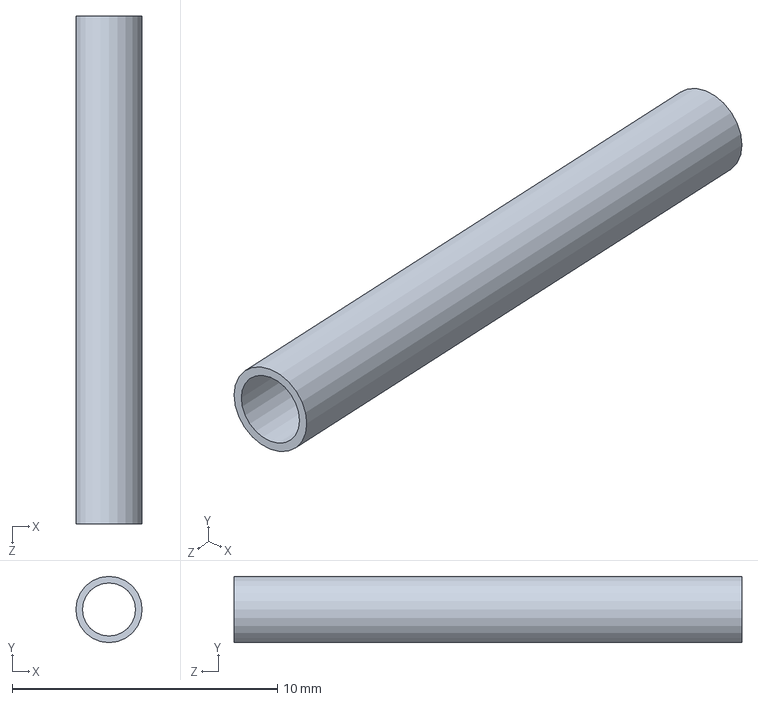
[picture p105: CAD file, 2017-01-14]
CADProsthetic/HandParameterized/Fingers/src/Ring/ringTube1.SLDPRT
2.50 x 2.50 x 19.1 mm
