liarokapisv/RobotHands/CADProsthetic/HandParameterized/Fingers/src/Thumb/thumbTube1.SLDPRT

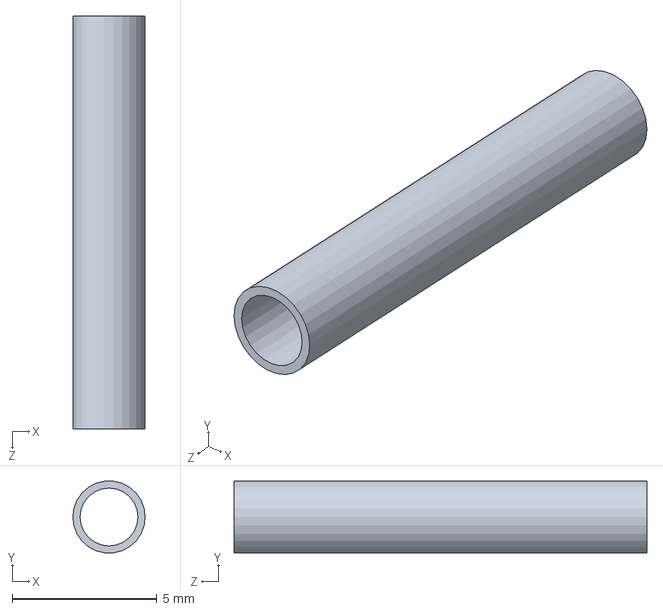
[picture p106: CAD file, 2017-01-14]
CADProsthetic/HandParameterized/Fingers/src/Thumb/thumbTube1.SLDPRT
2.50 x 2.48 x 14.3 mm
