liarokapisv/RobotHands/CADProsthetic/HandParameterized/Flange/src/SupportBaseFlange1.SLDPRT

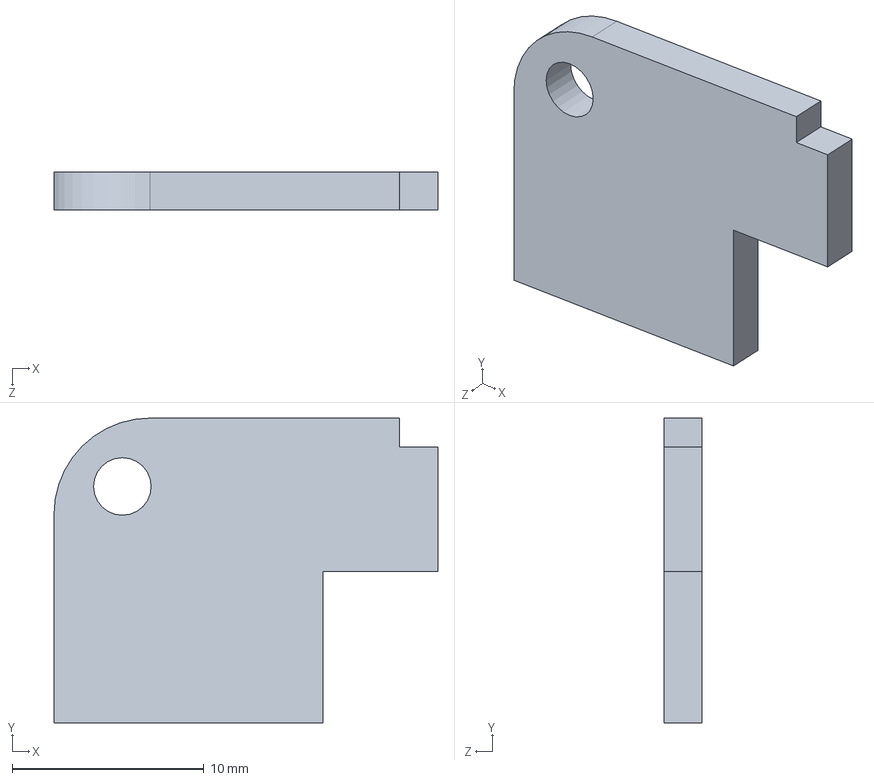
[picture p107: CAD file, 2017-01-14]
CADProsthetic/HandParameterized/Flange/src/SupportBaseFlange1.SLDPRT
20.0 x 15.9 x 2.00 mm
