liarokapisv/RobotHands/CADProsthetic/HandParameterized/Flange/SupportBaseFlange2.STL

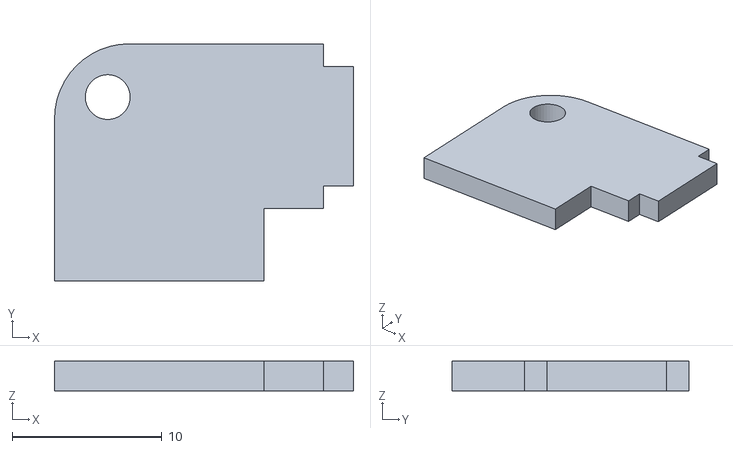
[picture p108: CAD file, 2017-01-14]
CADProsthetic/HandParameterized/Flange/SupportBaseFlange2.STL
20.0 x 15.9 x 2.00
