liarokapisv/RobotHands/CADProsthetic/HandParameterized/ServoBase/Base HerkuleX/BracketHerkulex3.STL

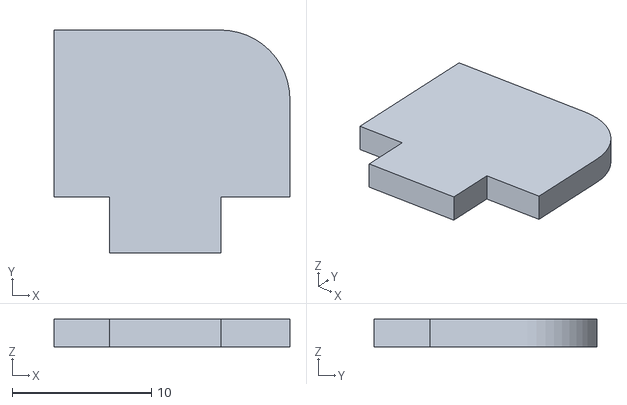
[picture p109: CAD file, 2017-01-14]
CADProsthetic/HandParameterized/ServoBase/Base HerkuleX/BracketHerkulex3.STL
16.9 x 16.0 x 2.00
