liarokapisv/RobotHands/CADProsthetic/HandParameterized/Thumb_mechanism/thumbMechanismDriver1.STL

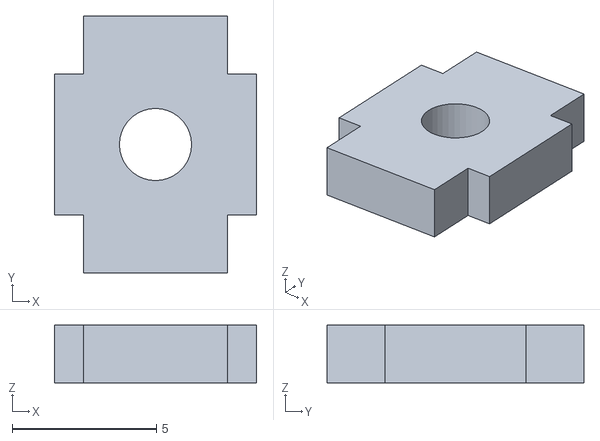
[picture p110: CAD file, 2017-01-14]
CADProsthetic/HandParameterized/Thumb_mechanism/thumbMechanismDriver1.STL
7.00 x 8.90 x 2.00
