liarokapisv/RobotHands/CADProsthetic/HandParameterized/Whipheel_tree/BasePulleyInsidePalm2.STL

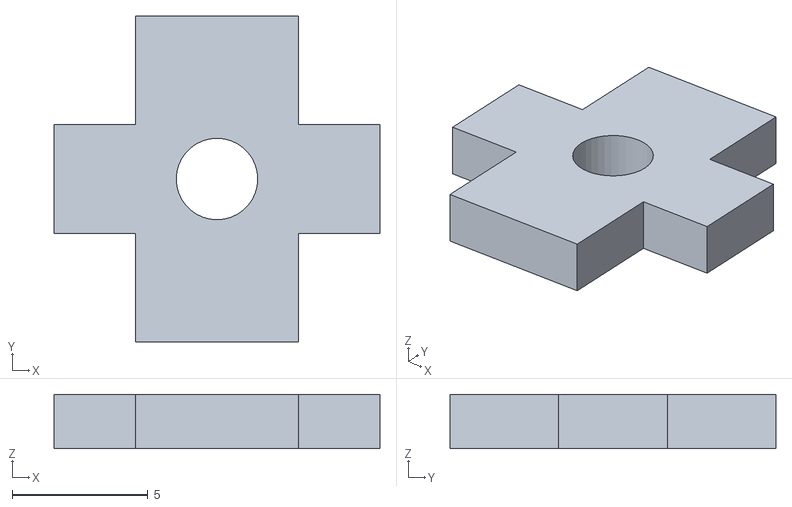
[picture p111: CAD file, 2017-01-14]
CADProsthetic/HandParameterized/Whipheel_tree/BasePulleyInsidePalm2.STL
12.0 x 12.0 x 2.00
