liarokapisv/RobotHands/CADProsthetic/HandParameterized/Whipheel_tree/src/barMiddlePinky.SLDPRT

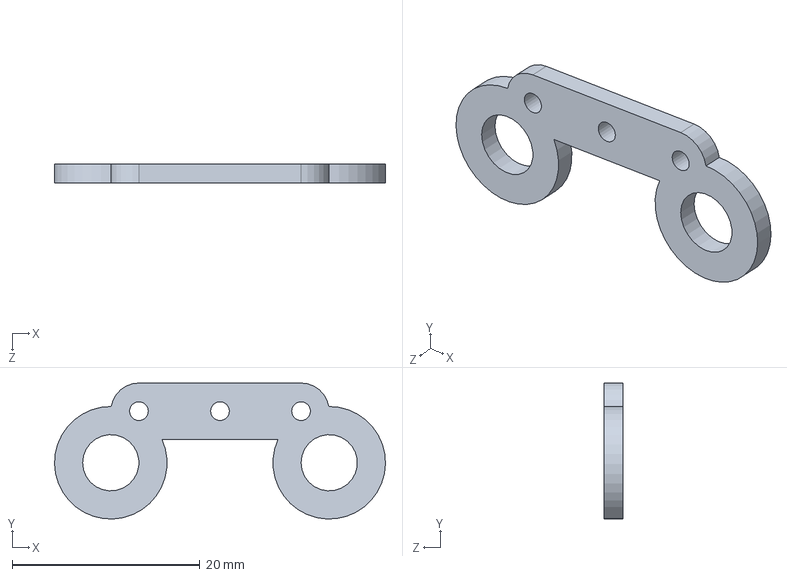
[picture p112: CAD file, 2017-01-14]
CADProsthetic/HandParameterized/Whipheel_tree/src/barMiddlePinky.SLDPRT
35.3 x 14.5 x 2.00 mm
