liarokapisv/RobotHands/CADRoboticNewVersion/Couplings/MountPlatePA10.SLDPRT

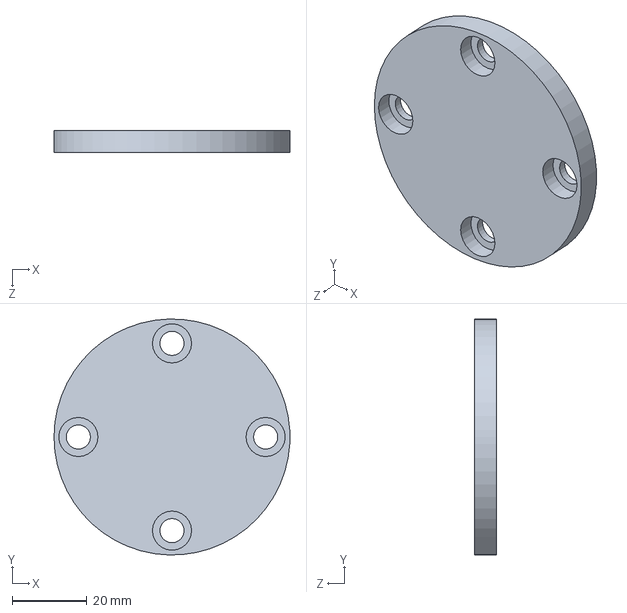
[picture p113: CAD file, 2017-01-14]
CADRoboticNewVersion/Couplings/MountPlatePA10.SLDPRT
63.0 x 63.0 x 6.00 mm
