liarokapisv/RobotHands/CADRoboticNewVersion/Interfaces/Extension/RobotHandExtension.SLDPRT

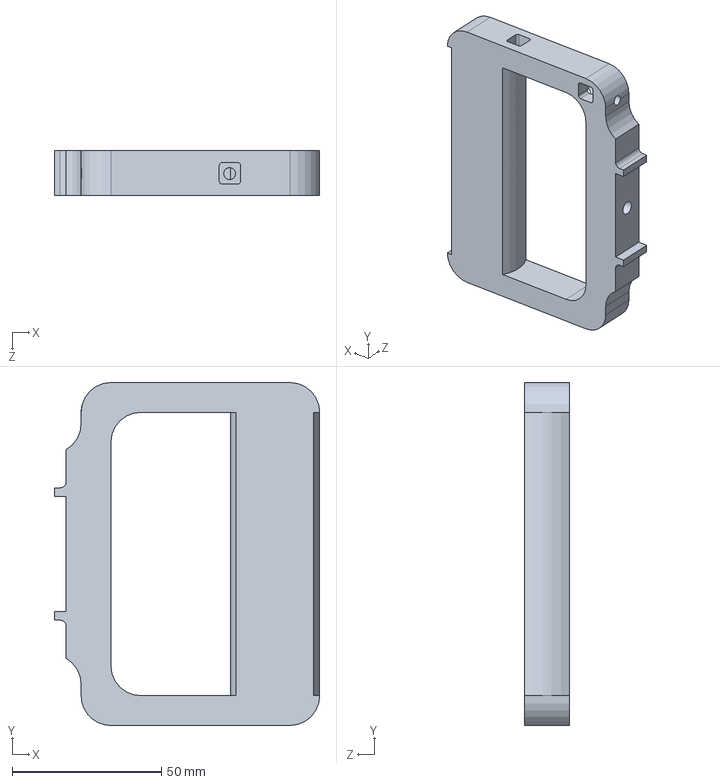
[picture p114: CAD file, 2017-01-14]
CADRoboticNewVersion/Interfaces/Extension/RobotHandExtension.SLDPRT
89.0 x 115.0 x 15.0 mm
