liarokapisv/RobotHands/CADRoboticNewVersion/Interfaces/SliderBox/SlideSide.SLDPRT

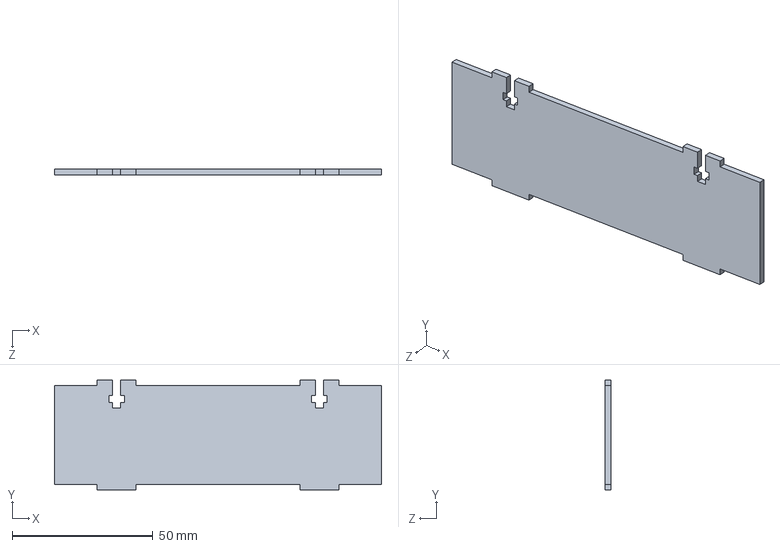
[picture p115: CAD file, 2017-01-14]
CADRoboticNewVersion/Interfaces/SliderBox/SlideSide.SLDPRT
116.0 x 39.0 x 2.00 mm
