liarokapisv/RobotHands/(list of files, cad)

Other CAD files:
CAD/Robot Flange/src/FlangeAX12.SLDASM
CAD/Laser/src/RobotHand_AX12.dwg
CADProsthetic/HandParameterized/Fingers/Ring/ring.STL
CADProsthetic/HandParameterized/Fingers/src/Index/indexPIP.SLDPRT
CADProsthetic/HandParameterized/Fingers/src/Pinky/skarifima.SLDPRT
CADProsthetic/HandParameterized/Fingers/Thumb/thumb.STL
CADProsthetic/HandParameterized/Palm/src/palmDown.SLDPRT
CADProsthetic/HandParameterized/prostheticParameters.SLDPRT
CADProsthetic/HandParameterized/ServoBase/src/Base HerkuleX/BracketHerkulex.SLDPRT
CADRoboticNewVersion/FabricationParameters.SLDPRT
CADRoboticNewVersion/RobotHand/RobotHandParameters.SLDPRT
CAD/Laser/src/RobotHand_stdServo.dwg
CAD/Robot Base AX12/servoPulleyAX12_3.STL
CAD/Robot Flange/FlangeStdServo.STL
CADProsthetic/HandParameterized/Button/src/buttonAxle.SLDPRT
CADProsthetic/HandParameterized/Fingers/Middle/middle.STL
CADProsthetic/HandParameterized/Fingers/src/Common Parts/driverBaseFrame2.SLDPRT
CADProsthetic/HandParameterized/Fingers/src/Index/skarifima.SLDPRT
CADProsthetic/HandParameterized/Flange/SupportHandFlange1.STL
CADProsthetic/HandParameterized/Palm/palmDown.STL
CADProsthetic/HandParameterized/Palm/src/palmUp.SLDPRT
CADProsthetic/HandParameterized/Whipheel_tree/whiffleetree.STL
CAD/Robot Base AX12/src/PCBMount.SLDPRT
CADProsthetic/HandParameterized/Button/src/buttonBase.SLDPRT
CADProsthetic/HandParameterized/Fingers/Pinky/pinky.STL
CADProsthetic/HandParameterized/Fingers/src/Middle/middleDIP.SLDPRT
CADProsthetic/HandParameterized/Fingers/Thumb/thumbDIP.STL
CADProsthetic/HandParameterized/ServoBase/Pulley/supportPulleyPalmUp.STL
CADProsthetic/HandParameterized/ServoBase/src/Base HerkuleX/MiniBaseHerkulex.SLDPRT
CADProsthetic/HandParameterized/ServoBase/src/Pulley/supportPulleyPalmUp2.SLDPRT
CAD/CommonParts/M2Nut.SLDPRT
CAD/CommonParts/M2x6.SLDPRT
CAD/CommonParts/M2x8.SLDPRT
CAD/CommonParts/M3Nut.SLDPRT
CAD/CommonParts/M3Spacer10.SLDPRT
CAD/CommonParts/M3Spacer25.SLDPRT
CAD/CommonParts/M3Spacer30.SLDPRT
CAD/CommonParts/M3Washer.SLDPRT
CAD/CommonParts/M3x10.SLDPRT
CAD/CommonParts/M3x12.SLDPRT
CAD/CommonParts/M3x20.SLDPRT
CAD/CommonParts/M6Nut.SLDPRT
CAD/CommonParts/M6x28.SLDPRT
CAD/CommonParts/PlasticSpacer.SLDPRT
CAD/CommonParts/pulley.SLDPRT
CAD/FinalParts/Flange.sldprt
CAD/FinalSTLs/FingerTopPlate.STL
CAD/FinalSTLs/Flange.STL
CAD/FinalSTLs/MiddlePlate.STL
CAD/FinalSTLs/ServoPlate.STL
CAD/Robot Base AX12/BottomPlateAX12.STL
CAD/Robot Base AX12/servoPulleyAX12_1-2.STL
CAD/Robot Base AX12/src/AX12Base.SLDPRT
CAD/Robot Base AX12/src/BearingBase.SLDPRT
CAD/Robot Base AX12/src/BottomPlateAX12.SLDPRT
CAD/Robot Base AX12/src/MiddlePlate.SLDPRT
CAD/Robot Base AX12/src/servoPulleyAX12_1.SLDPRT
CAD/Robot Base AX12/src/servoPulleyAX12_2.SLDPRT
CAD/Robot Base stdServo/servoPulleyStd1-2.STL
CAD/Robot Base stdServo/src/MiddlePlate.SLDPRT
CAD/Robot Base stdServo/src/PCBMount.SLDPRT
CAD/Robot Base stdServo/src/ServoHorn.SLDPRT
CAD/Robot Base stdServo/src/servoPulleyStd1.SLDPRT
CAD/Robot Base stdServo/src/servoPulleyStd2.SLDPRT
CAD/Robot Base stdServo/src/servoPulleyStd3.SLDPRT
CAD/Robot Base stdServo/stdServoBase.STL
CAD/Robot Finger/DifferentialDisk.STL
CAD/Robot Finger/FingerPIP.STL
CAD/Robot Finger/src/DifferentialDisk.SLDPRT
CAD/Robot Finger/src/FingerBase2.SLDPRT
CAD/Robot Finger/src/FingerBase3.SLDPRT
CAD/Robot Finger/src/FingerDIP.SLDPRT
CAD/Robot Finger/src/FingerMCP.SLDPRT
CAD/Robot Finger/src/FingerPIP.SLDPRT
CAD/Robot Finger/src/Joint1.SLDPRT
CAD/Robot Finger/src/Joint2.SLDPRT
CAD/Robot Finger/src/TopPlate.SLDPRT
CAD/Robot Finger/src/TubePlate.SLDPRT
CAD/Robot Finger/src/TubePlateMCP.SLDPRT
CAD/Robot Finger/src/tubeDIP.SLDPRT
CAD/Robot Finger/src/tubeMCP.SLDPRT
CAD/Robot Finger/src/tubePIP.SLDPRT
CAD/Robot Flange/src/flangeAX12_1.SLDPRT
CAD/Robot Flange/src/flangeAX12_2.SLDPRT
CAD/Robot Flange/src/flangeAX12_3.SLDPRT
CAD/Robot Flange/src/flangeStdServo_3.SLDPRT
CADProsthetic/HandParameterized/Button/Button.STL
CADProsthetic/HandParameterized/Button/src/buttonFrame.SLDPRT
CADProsthetic/HandParameterized/Fingers/Index/index.STL
CADProsthetic/HandParameterized/Fingers/Middle/middleMIP.STL
CADProsthetic/HandParameterized/Fingers/Pinky/pinkyDIP.STL
CADProsthetic/HandParameterized/Fingers/Ring/ringDIP.STL
CADProsthetic/HandParameterized/Fingers/src/Index/indexDIP.SLDPRT
CADProsthetic/HandParameterized/Fingers/src/Index/indexMIP.SLDPRT
CADProsthetic/HandParameterized/Fingers/src/Index/indexTube1.SLDPRT
CADProsthetic/HandParameterized/Fingers/src/Index/indexTube2.SLDPRT
CADProsthetic/HandParameterized/Fingers/src/Middle/middleElastomer.SLDPRT
CADProsthetic/HandParameterized/Fingers/src/Middle/middleMIP.SLDPRT
CADProsthetic/HandParameterized/Fingers/src/Middle/middlePIP.SLDPRT
CADProsthetic/HandParameterized/Fingers/src/Middle/middleTube1.SLDPRT
CADProsthetic/HandParameterized/Fingers/src/Middle/middleTube3.SLDPRT
CADProsthetic/HandParameterized/Fingers/src/Middle/skarifima3.SLDPRT
CADProsthetic/HandParameterized/Fingers/src/Middle/tube31.SLDPRT
CADProsthetic/HandParameterized/Fingers/src/Middle/tube33.SLDPRT
CADProsthetic/HandParameterized/Fingers/src/Pinky/pinkyDIP.SLDPRT
CADProsthetic/HandParameterized/Fingers/src/Pinky/pinkyElastomer.SLDPRT
CADProsthetic/HandParameterized/Fingers/src/Pinky/pinkyMIP.SLDPRT
CADProsthetic/HandParameterized/Fingers/src/Pinky/pinkyPIP.SLDPRT
CADProsthetic/HandParameterized/Fingers/src/Pinky/pinkyTube1.SLDPRT
CADProsthetic/HandParameterized/Fingers/src/Pinky/pinkyTube2.SLDPRT
CADProsthetic/HandParameterized/Fingers/src/Ring/ringMIP.SLDPRT
CADProsthetic/HandParameterized/Fingers/src/Ring/ringPIP.SLDPRT
CADProsthetic/HandParameterized/Fingers/src/Ring/ringTube2.SLDPRT
CADProsthetic/HandParameterized/Fingers/src/Ring/skarifima.SLDPRT
CADProsthetic/HandParameterized/Fingers/src/Thumb/skarifima.SLDPRT
CADProsthetic/HandParameterized/Fingers/src/Thumb/thumbElastomer.SLDPRT
CADProsthetic/HandParameterized/Fingers/src/Thumb/thumbPIP.SLDPRT
CADProsthetic/HandParameterized/Fingers/src/Thumb/thumbTube2.SLDPRT
CADProsthetic/HandParameterized/Flange/SupportBaseFlange1.STL
CADProsthetic/HandParameterized/Flange/flange.STL
CADProsthetic/HandParameterized/Flange/src/SupportBaseFlange2.SLDPRT
CADProsthetic/HandParameterized/Flange/src/supportHandFlange2.SLDPRT
CADProsthetic/HandParameterized/ServoBase/Base HerkuleX/BracketHerkulex2.STL
CADProsthetic/HandParameterized/ServoBase/Pulley/pulley.STL
CADProsthetic/HandParameterized/ServoBase/src/Base HerkuleX/BracketHerkulex3.SLDPRT
CADProsthetic/HandParameterized/ServoBase/src/Pulley/supportPulley1.SLDPRT
CADProsthetic/HandParameterized/Thumb_mechanism/lockMechanismBracket.STL
CADProsthetic/HandParameterized/Thumb_mechanism/lockMechanismBracket2.STL
CADProsthetic/HandParameterized/Thumb_mechanism/src/ThumbMechanismTube2.SLDPRT
CADProsthetic/HandParameterized/Thumb_mechanism/src/lockMechanismBracket.SLDPRT
CADProsthetic/HandParameterized/Thumb_mechanism/src/lockMechanismSupport.SLDPRT
CADProsthetic/HandParameterized/Thumb_mechanism/src/thumbBracket.SLDPRT
CADProsthetic/HandParameterized/Thumb_mechanism/src/thumbButton.SLDPRT
CADProsthetic/HandParameterized/Thumb_mechanism/src/thumbDriver1.SLDPRT
CADProsthetic/HandParameterized/Thumb_mechanism/src/thumbDriver2.SLDPRT
CADProsthetic/HandParameterized/Thumb_mechanism/src/thumbMechanismDriver1.SLDPRT
CADProsthetic/HandParameterized/Thumb_mechanism/src/thumbMechanismDriver2.SLDPRT
CADProsthetic/HandParameterized/Thumb_mechanism/src/thumbMechansimTube1.SLDPRT
CADProsthetic/HandParameterized/Thumb_mechanism/src/thumbMovingBracket.SLDPRT
CADProsthetic/HandParameterized/Thumb_mechanism/src/thumbMovingBracket1.SLDPRT
CADProsthetic/HandParameterized/Thumb_mechanism/src/thumbMovingBracketDown.SLDPRT
CADProsthetic/HandParameterized/Thumb_mechanism/src/toothedBlockMechanism.SLDPRT
CADProsthetic/HandParameterized/Thumb_mechanism/src/toothedMechansim.SLDPRT
CADProsthetic/HandParameterized/Thumb_mechanism/thumbBase.STL
CADProsthetic/HandParameterized/Thumb_mechanism/thumbBracket.STL
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
