liarokapisv/RobotHands/(commit log)

2017-01-14 Fixed mate problems
    [FingerBase1.SLDPRT, FingerBase2.SLDPRT, FingerBase3.SLDPRT, FingerMCP.SLDPRT, Finger_2ph.SLDASM, M3Nut.SLDPRT, M3Washer.SLDPRT, M3x12.SLDPRT]
2017-01-14 Added new version. Changed finger base.
    [90666A131 - ScrewM6L12LowProfile.SLDPRT, 90965A130 - WasherM3.SLDPRT, 91290A123 - ScrewM3L20.SLDPRT, 91292A114 - ScrewM3L12.SLDPRT, 91292A195 - ScrewM5L45.SLDPRT, 91292A831 - ScrewM2L6.SLDPRT, 91292A832 - ScrewM2L8.SLDPRT, 91292A833 - ScrewM2L10.SLDPRT]
2017-01-18 removed hole from FingerMCP
    [FingerMCP.SLDPRT, Finger_2ph.SLDASM, FingersTopPlate.SLDASM]
2017-01-18 Created assembly parts, exported stls
    [FingerTopPlate.STL, FingerTopPlate.sldprt, Flange.STL, Flange.sldprt, MiddlePlate.STL, MiddlePlate.sldprt, ServoPlate.STL, ServoPlate.sldprt]
2017-01-19 Fixed fingerMCP dimensions, changed fingers to 4
    [BearingBase.SLDPRT, BottomPlateStdServo.SLDPRT, DifferentialDisk.SLDPRT, FingerBase1.SLDPRT, FingerBase2.SLDPRT, FingerBase3.SLDPRT, FingerMCP.SLDPRT, FingerTopPlate.STL]
2017-01-19 changed dimensions, modified screw holes
    [FingerBase1.SLDPRT, FingerMCP.SLDPRT, FingerTopPlate.STL, FingerTopPlate.sldprt, Finger_2ph.SLDASM, FingersTopPlate.SLDASM, Flange.STL, Flange.sldprt]
